wdxm657/ble_egg_anfu/蛋安抚器产品定义.md

## Wag2Me V1.3版本定义
- 1- 修订记录
    - 记录-1
        - 时间：2026-04-16
        - 修订人：刘岩
        - 修订内容：初始版本
- 2-开发内容
    - 2.1 设备
        - 蛋安抚器
    - 2.2 APP
        - 功能模块
            - Pet Hub、Hardware，增加对蛋安抚器的支持
    - 2.3-运营管理端
        - 增加对蛋安抚器的支持
    - 2.4-服务器端
        - 增加对蛋安抚器的支持
- 3-设备定义
    - 蛋安抚器
        - 主要电子器件
            - 主控
                - RV1103G1，17RMB
                - 部署声音识别算法
            - 麦克风咪头
                - B6050AL-C1033，1.5RMB
            - 超声波模组
                - 双头+板，13.2RMB
            - 扬声器喇叭
                - 首选
                    - 高保真，自带音腔，6.2RMB
                - 次选
                    - 旧样机在用，1.1RMBf
            - 蓝牙芯片
                - TLSR8258，2RMB
        - 安装要求
            - 摆放在狗狗碰不到的地方，距离地面高度0.7~1.5米，正面无遮挡
        - 功能定义
            - 自动识别吠叫
                - 7 x 24 小时自动识别狗吠，监测到狗狗持续吠叫则自动执行安抚
                - 每10~15秒为一个监测周期，根据期间识别到的狗吠次数判断是否要执行安抚
            - 自动执行安抚
                - 无安抚成功记录时，按照出厂顺序执行安抚，直到狗吠停止或全部措施执行完
                    - 1-播放安抚音乐2分钟
                    - 如果吠叫未停止
                    - 已录制主人声音
                    - 2-播放主人录音
                        - 录音播放次数=ceil(20 / 录音长度)
                    - 如果吠叫未停止
                    - 3-释放超声波5秒
                        - 25kHz@110dB
                    - 如果吠叫未停止
                    - 4-释放超声波5秒
                        - 30kHz@110dB
                    - 如果吠叫未停止
                    - 5-释放超声波5秒
                        - 25kHz&30kHz@110dB
                    - 设备进入60秒休息时间
                - 如果有成功安抚记录，优先执行最近成功的安抚措施
                    - 根据成功安抚记录，基于出厂顺序，调整下次执行顺序
                    - 举例
                        - 最近成功止吠措施
                            - 25kHz@110dB
                        - 下次执行顺序
                            - 1-25kHz@110dB
                            - 2-30kHz@110dB
                            - 3-25kHz&30kHz@110dB
                            - 4-播放安抚音乐
                            - 5-播放主人录音
            - 主人录音管理
                - 录音长度：3~10秒
                - 可在APP控制设备进行
                    - 录音试听
                    - 录音清除
                    - 声音录制
            - 安抚措施可配置
                - 安抚措施可多选，至少选1个
                    - 播放安抚音乐
                    - 播放主人声音
                    - 发射超声波
                        - 发射频率及强度可多选，至少选1个，最多选3个
                            - 25kHz@100dB
                            - 30kHz@80dB
                            - 25kHz&30kHz@100dB
            - 安抚记录查看
                - 可在APP上查看最近30天的安抚记录
            - 恢复出厂
                - 在app上解除配对时，设备恢复出厂状态
                    - 清除主人录音
                    - 安抚措施执行顺序恢复出厂状态
                    - 断开与当前用户的蓝牙连接
            - 上电后自动开机，可通过app操作关机
        - 数据处理
            - 与APP的数据接口
                - APP请求设备
                    - 配对请求
                    - 解除配对请求
                    - 获取设备状态
                        - 开关状态
                        - 是否存在主人录音
                    - 播放主人录音指令
                    - 删除主人录音指令
                    - 开始录制指令
                    - 结束录制指令
                        - 异常反馈：录音时长<3秒
                    - 音量，请求+指令
                    - 安抚模式，请求+指令
                    - 安抚措施，请求+指令
                - 设备主打上报
                    - 当前工作状态：监测/休息/识别/执行
                    - 安抚记录
                        - 吠叫识别时间
                        - 安抚措施执行时间（可能多个）
                        - 安抚结果及时间
        - 物理UI
            - 指示灯
                - 工作状态灯
                    - 熄灭：未供电
                    - 白色灯常亮：已供电、未开机
                    - 白色灯闪烁：开机启动中
                    - 蓝色灯常亮：实时监测状态
                    - 蓝色灯闪烁：安抚后的休息状态
                    - 绿色灯闪烁：检测到狗吠，判断是否要执行安抚
                    - 绿色灯常亮：安抚措施执行中
                - 蓝牙连接灯
                    - 熄灭：蓝牙未连接
                    - 蓝色灯常亮：蓝牙已连接
            - USB供电口
