wdxm657/ble_egg_anfu/docs/ctrl_service_doc.md

## 通用控制 Service 协议说明（给 APP 开发）

### 蓝牙名称 SincereEGGA

### 1. GATT 结构概览

- **Service：Custom Control Service**
- UUID（16 字节）：`00 A0 0D 0C 0B 0A 09 08 07 06 05 04 03 02 01 00`
- **Characteristic 1：Ctrl RX（APP -> 设备）**

- 

- UUID：`01 A0 0D 0C 0B 0A 09 08 07 06 05 04 03 02 01 00`
- 属性：Read | Write | Write Without Response
- 用途：APP 向设备发送所有控制命令

- **Characteristic 2：Ctrl TX（设备 -> APP）**

- 

- UUID：`02 A0 0D 0C 0B 0A 09 08 07 06 05 04 03 02 01 00`
- 属性：Read | Notify
- 需先向 CCC 写 `0x0001` 开启 Notify
- 用途：设备向 APP 返回响应/事件

- **Characteristic 3：Log TX（设备 -> APP）**

- 

- UUID：`03 A0 0D 0C 0B 0A 09 08 07 06 05 04 03 02 01 00`
- 属性：Read | Notify
- 需先向 CCC 写 `0x0001` 开启 Notify
- 用途：独立的调试日志输出通道，设备侧 `BLE_LOG_D` 宏的输出发往此特征。原始文本 UTF-8 编码，不分帧（每包最多 20 字节，长日志自动分包）
- APP 应将此通道的日志单独显示或与协议日志分开处理

当前固件按默认 MTU=23 设计，单帧总长度限制：`6 + payloadLen <= 20`。

**阅读约定**：下文「请求帧 / 响应帧」中，`byte0`～`byte5` 为固定 6 字节帧头；`byte6` 起为负载。`seq` 由 APP 自选 `0x00`～`0xFF`，响应中原样回显。多字节整数均为**小端（LE）**。

---

### 2. 通用帧头（每个接口共用，共 6 字节）

| | | |
| --- | --- | --- |
| 字节索引 | 固定/变量 | 含义 |
| byte0 | 固定 `0x01` | 协议版本 |
| byte1 | `0x01`/ `0x02`/ `0x03` | 消息类型：`0x01`=CMD（APP→设备），`0x02`=RSP（设备→APP），`0x03`=EVENT（设备→APP） |
| byte2 | 命令 ID | 与具体接口对应（见各节） |
| byte3 | `seq` | 序号；RSP/EVENT 与触发该结果的 CMD 使用同一 `seq`（事件除外见各节说明）。注意：设备会缓存最近 4 条 RSP 帧，若同一 seq 重复到达，自动重发上一次的响应结果 |
| byte4 | `payloadLen & 0xFF` | 负载长度低字节 |
| byte5 | `(payloadLen >> 8) & 0xFF` | 负载长度高字节；当前实现恒为 `0x00` |

`payloadLen` = 从 `byte6` 开始的字节数，且满足 `6 + payloadLen <= 20`。

---

### 3. 错误码（响应或事件中 payload 的首字节 `status`）

| | | |
| --- | --- | --- |
| 取值 | 名称 | 含义（APP 侧建议） |
| `0x00` | OK | 成功 |
| `0x01` | LEN_ERROR | 长度/格式不符 |
| `0x02` | UNSUPPORTED_CMD | 不支持的命令 |
| `0x03` | PARAM_ERROR | 参数非法 |
| `0x04` | INTERNAL_ERROR  | 内部或下游处理失败 |
| `0x05` | BUSY | 忙（如上一笔异步未完成） |
| `0x06` | SOC_TIMEOUT | 等 SOC 串口响应超时 |
| `0x07` | SOC_ERROR | SOC 返回错误（errDetail 为原始状态码） |

**短错误响应（常见 2 字节负载）**：`byte6=status`，`byte7=errDetail`（多数为 `0x00`；部分接口在失败时 `byte7` 为 SOC 原始错误码，见各接口说明）。

#### 3.1 SOC 原始故障码（当 `status = 0x07` 时，`errDetail` 取值）

当 BLE MCU 返回 `SOC_ERROR(0x07)` 时，`errDetail` 字节为 SOC 侧返回的原始状态码（`ds_uart_status_t`），取值如下：

| errDetail | 枚举名 | 含义 |
| --- | --- | --- |
| `0x00` | `DS_UART_STATUS_OK` | 成功 |
| `0x01` | `DS_UART_STATUS_PARAM_ERROR` | 参数错误 |
| `0x02` | `DS_UART_STATUS_BUSY` | 忙 |
| `0x03` | `DS_UART_STATUS_STATE_CONFLICT` | 状态冲突（当前不允许该操作） |
| `0x04` | `DS_UART_STATUS_TIMEOUT` | 超时 |
| `0x05` | `DS_UART_STATUS_NOT_FOUND` | 未找到（如无主人录音文件） |
| `0x06` | `DS_UART_STATUS_INTERNAL_ERROR` | SOC 内部错误 |

> **安抚会话中禁止的操作**：当设备处于安抚流程中（从首次狗叫识别到冷却开始），以下命令会被 SOC 拒绝并返回 `status=0x07(SOC_ERROR)` + `errDetail=0x03(状态冲突)`：
> - `OWNER_REC_START(0x20)` — 主人录音开始
> - `OWNER_REC_STOP(0x21)` — 主人录音结束
> - `OWNER_REC_PLAY(0x22)` — 主人录音播放
> - `OWNER_REC_PLAY_STOP(0x25)` — 主人录音停止播放
> - `OWNER_REC_DELETE(0x23)` — 主人录音删除
> - `OWNER_REC_SAVE(0x26)` — 主人录音保存
> - `CALM_MUSIC_PLAY(0x27)` — 安抚音频播放
> - `CALM_MUSIC_PLAY_STOP(0x28)` — 安抚音频停止播放
> - `CALM_MUSIC_SELECT(0x29)` 设置模式 — 设置安抚音频
> - `CALM_MODE_SET(0x30)` — 安抚模式设置
> - `CALM_STRATEGY_SET(0x37)` — 安抚策略设置
>
> APP 应在收到此错误后提示用户「安抚进行中，请稍后重试」。

---

### 4. 已实现命令（逐字节说明）

---

#### 4.1 电源开关（POWER_CTRL，CMD = `0x12`）

**请求帧（APP → 设备），总长 7 字节**

| | | |
| ----- | --- | --- |
| 字节  | 值/变量 | 注释 |
| byte0 | `0x01`  | 协议版本 |
| byte1 | `0x01`  | CMD |
| byte2 | `0x12`  | POWER_CTRL |
| byte3 | `seq` | 序号 |
| byte4 | `0x01`  | 负载长度 = 1 |
| byte5 | `0x00`  | 长度高字节 |
| byte6 | `onOff` | `0x00`=关机，`非0`视为开机（固件规范化为 `0x01`） |

**响应帧（设备 → APP），总长 8 字节**

| | | |
| ----- | --- | --- |
| 字节  | 值/变量  | 注释 |
| byte0 | `0x01` | 协议版本 |
| byte1 | `0x02` | RSP |
| byte2 | `0x12` | POWER_CTRL |
| byte3 | `seq` | 与请求一致 |
| byte4 | `0x02` | 负载长度 = 2 |
| byte5 | `0x00` | 长度高字节 |
| byte6 | `status` | 见 §3；成功为 `0x00` |
| byte7 | `onOff`  | 回显 MCU 应用后的开关：`0x00`关，`0x01`开 |

**参数错误时**：同上总长 8 字节，`byte6=0x03`（PARAM_ERROR），`byte7=0x00`。

---

#### 4.2 状态查询（STATUS_GET，CMD = `0x13`）

**请求帧（APP → 设备），总长 6 字节**

| | | |
| ----- | --- | --- |
| 字节  | 值/变量 | 注释 |
| byte0 | `0x01`  | 协议版本 |
| byte1 | `0x01`  | CMD |
| byte2 | `0x13`  | STATUS_GET |
| byte3 | `seq` | 序号 |
| byte4 | `0x00`  | 负载长度 = 0 |
| byte5 | `0x00`  | 长度高字节 |

**响应帧（设备 → APP），总长 16 字节**

| | | |
| --- | --- | --- |
| 字节 | 值/变量 | 注释 |
| byte0  | `0x01` | 协议版本 |
| byte1  | `0x02` | RSP |
| byte2  | `0x13` | STATUS_GET |
| byte3  | `seq` | 与请求一致 |
| byte4  | `0x07` | 负载长度 = 7 |
| byte5  | `0x00` | 长度高字节 |
| byte6  | `status` | 见 §3 |
| byte7  | `powerState` | 电源：`0x00`关机，`0x01`开机（**MCU 本地维护**，非 SOC 直传） |
| byte8  | `workState` | 工作状态：`0x00`OFF，`0x01`监测，`0x02`识别，`0x03`执行，`0x04`休息 |
| byte9  | `btLinked` | 兼容字段：当前连接下**固定为** `0x01` |
| byte10 | `volume` | 音量 `0`～`100` (百分比) |
| byte11 | `calmMode` | 安抚模式：`0x00`自动调整，`0x01`人工干预 |
| byte12 | `charging` | 充电状态（**MCU 本地 ADC 监测**）：`0x00`未充电，`0x01`充电中 |

---

#### 4.3 音量设置（VOLUME_SET，CMD = `0x14`）

**请求帧（APP → 设备），总长 7 字节**

| | | |
| ----- | --- | --- |
| 字节  | 值/变量  | 注释 |
| byte0 | `0x01` | 协议版本 |
| byte1 | `0x01` | CMD |
| byte2 | `0x14` | VOLUME_SET |
| byte3 | `seq` | 序号 |
| byte4 | `0x01` | 负载长度 = 1 |
| byte5 | `0x00` | 长度高字节 |
| byte6 | `volume` | 目标音量 `0`～`100` (百分比) |

**响应帧（设备 → APP），总长 8 字节**

| | | |
| ----- | --- | --- |
| 字节  | 值/变量 | 注释 |
| byte0 | `0x01` | 协议版本 |
| byte1 | `0x02` | RSP |
| byte2 | `0x14` | VOLUME_SET |
| byte3 | `seq` | 与请求一致 |
| byte4 | `0x02` | 负载长度 = 2 |
| byte5 | `0x00` | 长度高字节 |
| byte6 | `status` | 见 §3 |
| byte7 | `volumeApplied` | SOC 应用后的音量 `0`～`100` (百分比) |

**失败（SOC 回包异常）**：总长 8 字节，`byte6=0x07`（SOC_ERROR），`byte7=SOC故障码`（见 §3.1）。

---

#### 4.4 音量查询（VOLUME_GET，CMD = `0x15`）

**请求帧（APP → 设备），总长 6 字节**

| | | |
| ----- | --- | --- |
| 字节  | 值/变量 | 注释 |
| byte0 | `0x01`  | 协议版本 |
| byte1 | `0x01`  | CMD |
| byte2 | `0x15`  | VOLUME_GET |
| byte3 | `seq` | 序号 |
| byte4 | `0x00`  | 负载长度 = 0 |
| byte5 | `0x00`  | 长度高字节 |

**响应帧（设备 → APP），总长 8 字节**

| | | |
| ----- | --- | --- |
| 字节  | 值/变量  | 注释 |
| byte0 | `0x01` | 协议版本 |
| byte1 | `0x02` | RSP |
| byte2 | `0x15` | VOLUME_GET |
| byte3 | `seq` | 与请求一致 |
| byte4 | `0x02` | 负载长度 = 2 |
| byte5 | `0x00` | 长度高字节 |
| byte6 | `status` | 见 §3 |
| byte7 | `volume` | 当前音量 `0`～`100` (百分比) |

---

#### 4.5 主人录音开始（OWNER_REC_START，CMD = `0x20`）

**请求帧（APP → 设备），总长 6 字节**

| | | |
| ----- | --- | --- |
| 字节  | 值/变量 | 注释 |
| byte0 | `0x01`  | 协议版本 |
| byte1 | `0x01`  | CMD |
| byte2 | `0x20`  | OWNER_REC_START |
| byte3 | `seq` | 序号 |
| byte4 | `0x00`  | 负载长度 = 0 |
| byte5 | `0x00`  | 长度高字节 |

**响应帧成功（设备 → APP），总长 7 字节**

| | | |
| ----- | --- | --- |
| 字节  | 值/变量  | 注释 |
| byte0 | `0x01` | 协议版本 |
| byte1 | `0x02` | RSP |
| byte2 | `0x20` | OWNER_REC_START |
| byte3 | `seq` | 与请求一致 |
| byte4 | `0x01` | 负载长度 = 1 |
| byte5 | `0x00` | 长度高字节 |
| byte6 | `status` | `0x00`表示 SOC 已接受开始录制 |

**响应帧失败（SOC 非 OK）**，总长 8 字节：`byte6=0x07`（SOC_ERROR），`byte7=socStatus`（SOC 响应首字节原始值，见 §3.1）。

---

#### 4.6 主人录音结束（OWNER_REC_STOP，CMD = `0x21`）

**请求帧（APP → 设备），总长 6 字节**

| | | |
| ----- | --- | --- |
| 字节  | 值/变量 | 注释 |
| byte0 | `0x01`  | 协议版本 |
| byte1 | `0x01`  | CMD |
| byte2 | `0x21`  | OWNER_REC_STOP |
| byte3 | `seq` | 序号 |
| byte4 | `0x00`  | 负载长度 = 0 |
| byte5 | `0x00`  | 长度高字节 |

**响应帧成功（设备 → APP），总长 8 字节**

| | | |
| ----- | --- | --- |
| 字节  | 值/变量 | 注释 |
| byte0 | `0x01` | 协议版本 |
| byte1 | `0x02` | RSP |
| byte2 | `0x21` | OWNER_REC_STOP |
| byte3 | `seq` | 与请求一致 |
| byte4 | `0x02` | 负载长度 = 2 |
| byte5 | `0x00` | 长度高字节 |
| byte6 | `status` | `0x00` |
| byte7 | `durationSec` | 有效录音时长（秒） |

停止响应在 WAV 头更新并关闭文件后返回；时长按实际写入的 PCM 字节数计算，16 kHz、单声道、16 bit，每秒 32000 字节，向下取整。不再额外延迟录制；重复停止返回最近一次录音的相同结果，不随调用时间增长。手动停止只返回 RSP，不发送自动停止事件。

**响应帧（录音过短等，SOC** `status=0x01`**）**，总长 8 字节：同上 `byte4=0x02`，`byte6=0x03`（PARAM_ERROR），`byte7=durationSec`（SOC 带回的秒数，常为 0）。

**响应帧（其它失败）**，总长 8 字节：`byte6=0x04`（INTERNAL_ERROR），`byte7=0x00`。

---

#### 4.7 主人录音播放（OWNER_REC_PLAY，CMD = `0x22`）

**请求帧（APP → 设备），总长 7 字节**

| | | |
| ----- | --- | --- |
| 字节  | 值/变量  | 注释 |
| byte0 | `0x01` | 协议版本 |
| byte1 | `0x01` | CMD |
| byte2 | `0x22` | OWNER_REC_PLAY |
| byte3 | `seq` | 序号 |
| byte4 | `0x01` | 负载长度 = 1 |
| byte5 | `0x00` | 长度高字节 |
| byte6 | `source` | 播放源：`0x00`=已保存音频，`0x01`=tmp 目录未保存音频 |

**响应帧（设备 → APP），总长 7 字节**

| | | |
| ----- | --- | --- |
| 字节  | 值/变量  | 注释 |
| byte0 | `0x01` | 协议版本 |
| byte1 | `0x02` | RSP |
| byte2 | `0x22` | OWNER_REC_PLAY |
| byte3 | `seq` | 与请求一致 |
| byte4 | `0x01` | 负载长度 = 1 |
| byte5 | `0x00` | 长度高字节 |
| byte6 | `status` | `0x00`表示已接受并开始异步播放 |

**响应帧（无主人录音，SOC** `NOT_FOUND`**）**，总长 8 字节：`byte6=0x07`（SOC_ERROR），`byte7=SOC故障码`。

**响应帧（其它失败）**，总长 8 字节：`byte6=0x04`（INTERNAL_ERROR），`byte7=0x00`。

---

#### 4.8 主人录音停止播放（OWNER_REC_PLAY_STOP，CMD = `0x25`）

**请求帧（APP → 设备），总长 6 字节**

| | | |
| ----- | --- | --- |
| 字节  | 值/变量 | 注释 |
| byte0 | `0x01`  | 协议版本 |
| byte1 | `0x01`  | CMD |
| byte2 | `0x25`  | OWNER_REC_PLAY_STOP |
| byte3 | `seq` | 序号 |
| byte4 | `0x00`  | 负载长度 = 0 |
| byte5 | `0x00`  | 长度高字节 |

**响应帧（设备 → APP），总长 7 字节**

| | | |
| ----- | --- | --- |
| 字节  | 值/变量  | 注释 |
| byte0 | `0x01` | 协议版本 |
| byte1 | `0x02` | RSP |
| byte2 | `0x25` | OWNER_REC_PLAY_STOP |
| byte3 | `seq` | 与请求一致 |
| byte4 | `0x01` | 负载长度 = 1 |
| byte5 | `0x00` | 长度高字节 |
| byte6 | `status` | 见 §3 |

---

#### 4.9 主人录音保存（OWNER_REC_SAVE，CMD = `0x26`）

**用途**：将已录制到 tmp 目录的音频文件移动到播放目录。如果 tmp 中无文件，返回 `NOT_FOUND`。

**请求帧（APP → 设备），总长 6 字节**

| | | |
| ----- | --- | --- |
| 字节  | 值/变量 | 注释 |
| byte0 | `0x01`  | 协议版本 |
| byte1 | `0x01`  | CMD |
| byte2 | `0x26`  | OWNER_REC_SAVE |
| byte3 | `seq` | 序号 |
| byte4 | `0x00`  | 负载长度 = 0 |
| byte5 | `0x00`  | 长度高字节 |

**响应帧成功（设备 → APP），总长 8 字节**

| | | |
| ----- | --- | --- |
| 字节  | 值/变量 | 注释 |
| byte0 | `0x01` | 协议版本 |
| byte1 | `0x02` | RSP |
| byte2 | `0x26` | OWNER_REC_SAVE |
| byte3 | `seq` | 与请求一致 |
| byte4 | `0x02` | 负载长度 = 2 |
| byte5 | `0x00` | 长度高字节 |
| byte6 | `status` | `0x00` |
| byte7 | `durationSec` | 音频时长（秒），与 OWNER_REC_STOP 一致 |

时长从保存后的 WAV 文件读取，计算规则同停录接口。录制尚未结束时保存返回 SOC_ERROR，附带 SOC 状态 `0x02`（BUSY），应先停止再保存。

保存成功响应在 WAV 数据和重命名涉及的目录均完成 `fsync` 后返回，确保保存后立即断电时数据已提交到存储。同步失败返回 SOC_ERROR，附带 SOC 状态 `0x06`（INTERNAL_ERROR），不返回保存成功。

**响应帧（tmp 无文件）**，总长 7 字节：`byte6=0x07`（SOC_ERROR），`byte7=0x05`（NOT_FOUND）。

**响应帧（移动失败）**，总长 7 字节：`byte6=0x07`（SOC_ERROR），`byte7=0x06`（INTERNAL_ERROR）。

---

#### 4.10 主人录音删除（OWNER_REC_DELETE，CMD = `0x23`）

**请求帧（APP → 设备），总长 6 字节**

| | | |
| ----- | --- | --- |
| 字节  | 值/变量 | 注释 |
| byte0 | `0x01`  | 协议版本 |
| byte1 | `0x01`  | CMD |
| byte2 | `0x23`  | OWNER_REC_DELETE |
| byte3 | `seq` | 序号 |
| byte4 | `0x00`  | 负载长度 = 0 |
| byte5 | `0x00`  | 长度高字节 |

**响应帧成功（设备 → APP），总长 7 字节**

| | | |
| ----- | --- | --- |
| 字节  | 值/变量  | 注释 |
| byte0 | `0x01` | 协议版本 |
| byte1 | `0x02` | RSP |
| byte2 | `0x23` | OWNER_REC_DELETE |
| byte3 | `seq` | 与请求一致 |
| byte4 | `0x01` | 负载长度 = 1 |
| byte5 | `0x00` | 长度高字节 |
| byte6 | `status` | `0x00` |

删除接口会停止录制，删除临时和已保存的录音，并同步两个目录后才返回成功；成功后查询返回 `exist=0`、`durationSec=0`。文件原本不存在或重复删除时也返回成功。

**删除或同步失败**：总长 8 字节，`byte6=0x07`（SOC_ERROR），`byte7=0x06`（SOC INTERNAL_ERROR）。此时不能认为删除已持久化，可重试删除接口。

---

#### 4.11 主人录音信息（OWNER_REC_INFO_GET，CMD = `0x24`）

**请求帧（APP → 设备），总长 6 字节**

| | | |
| ----- | --- | --- |
| 字节  | 值/变量 | 注释 |
| byte0 | `0x01`  | 协议版本 |
| byte1 | `0x01`  | CMD |
| byte2 | `0x24`  | OWNER_REC_INFO_GET |
| byte3 | `seq` | 序号 |
| byte4 | `0x00`  | 负载长度 = 0 |
| byte5 | `0x00`  | 长度高字节 |

**响应帧（设备 → APP），总长 9 字节**

| | | |
| ----- | --- | --- |
| 字节  | 值/变量 | 注释 |
| byte0 | `0x01` | 协议版本 |
| byte1 | `0x02` | RSP |
| byte2 | `0x24` | OWNER_REC_INFO_GET |
| byte3 | `seq` | 与请求一致 |
| byte4 | `0x03` | 负载长度 = 3 |
| byte5 | `0x00` | 长度高字节 |
| byte6 | `status` | 见 §3 |
| byte7 | `exist` | `0x00`无文件，`0x01`有 |
| byte8 | `durationSec` | 时长（秒），与 SOC 规则一致（含上限） |

查询对象为已保存的录音文件；时长从该 WAV 文件实际 PCM 数据量计算，向下取整，重启前后规则一致。新录音尚未保存时，此接口仍返回旧的已保存录音信息；新录音保存后，其时长与本次停止、保存响应一致。无文件时返回 `exist=0`、`durationSec=0`。

---

#### 4.11 安抚记录读取（CALM_RECORD_GET，CMD = `0x33`）

用途：获取最旧的一条安抚会话记录。设备会将本条记录的所有 entry 逐条通过 NOTIFY 上报。每条 entry 携带 `session_id`，APP 可据此在读取完成后调用 `CALM_RECORD_DELETE(0x3A)` 删除对应记录。再继续获取下一条，直到无记录为止。

**请求帧（APP → 设备），总长 6 字节**

| | | |
| ----- | --- | --- |
| 字节  | 值/变量 | 注释 |
| byte0 | `0x01`  | 协议版本 |
| byte1 | `0x01`  | CMD |
| byte2 | `0x33`  | CALM_RECORD_GET |
| byte3 | `seq` | 序号 |
| byte4 | `0x00`  | 负载长度 = 0 |
| byte5 | `0x00`  | 长度高字节 |

**单条 entry 响应帧（设备 → APP），总长 15 字节**

| | | |
| --- | --- | --- |
| byte0 | `0x01` | 协议版本 |
| byte1 | `0x02` | RSP |
| byte2 | `0x33` | CALM_RECORD_GET |
| byte3 | `seq` | 与请求一致 |
| byte4 | `0x09` | 负载长度 = 9 |
| byte5 | `0x00` | 长度高字节 |
| byte6 | `status` | 本条为 `0x00` |
| byte7 | `entryIdx` | 本条 entry 在该记录中的索引，`0`起 |
| byte8 | `totalEntriesInRecord` | 本记录总共包含多少条 entry |
| byte9 | `session_id` | 本条记录所属的会话 ID（1 字节，用于删除） |
| byte10 | `type` | entry 类型（见下表） |
| byte11～byte14 | `ts` | Unix 时间戳（秒），uint32 LE |

**结果条目响应帧（最后一条，即 `entryIdx == totalEntriesInRecord - 1`），总长 16 字节**

最后一条 entry 恒为结果条目（`type=0x10` SUCCESS 或 `0x11` FAIL），其帧尾多 1 字节 `reward`，用于告知 APP 本次安抚成功是否附带零食投喂奖励。

| | | |
| --- | --- | --- |
| byte0～byte5 | 同单条帧  | 帧头 |
| byte6 | `status` | `0x00` |
| byte7 | `entryIdx` | 最后一条索引（`totalEntriesInRecord - 1`） |
| byte8 | `totalEntriesInRecord` | 同前 |
| byte9 | `session_id` | 同前 |
| byte10 | `type` | `0x10`=SUCCESS 或 `0x11`=FAIL |
| byte11～byte14 | `ts` | 结果时间戳（Unix 秒，uint32 LE） |
| byte15 | `reward` | 零食奖励标记：`0x00`无；`0x01`=本次成功附带零食投喂奖励 |

> **reward 说明**：非结果条目（`entryIdx < totalEntriesInRecord - 1`）帧长为 9 字节、无该字段；仅结果条目为 10 字节。APP 可按 `entryIdx == totalEntriesInRecord - 1` 判断帧长并读取 `reward`。旧固件（无 reward 字段）的结果条目仍为 9 字节，读取时按 0 处理即可，向后兼容。

**entry type 定义**

| | | |
| --- | --- | --- |
| type | 名称 | 含义 |
| `0x01` | BARK | 狗叫识别（每条记录的第一个 entry） |
| `0x02` | MUSIC | 安抚音乐 |
| `0x03` | OWNER | 主人音频 |
| `0x04` | US_25K  | 超声波 25KHz |
| `0x05` | US_30K  | 超声波 30KHz |
| `0x06` | US_DUAL | 超声波双频 |
| `0x07` | SNACK | 零食投喂 |
| `0x10` | SUCCESS | 安抚成功（每条记录的最后一个 entry） |
| `0x11` | FAIL | 安抚失败（每条记录的最后一个 entry） |

**无记录响应帧（设备 → APP），总长 7 字节**

| | | |
| ----- | --- | --- |
| 字节  | 值/变量  | 注释 |
| byte0 | `0x01` | 协议版本 |
| byte1 | `0x02` | RSP |
| byte2 | `0x33` | CALM_RECORD_GET |
| byte3 | `seq` | 与请求一致 |
| byte4 | `0x01` | 负载长度 = 1 |
| byte5 | `0x00` | 长度高字节 |
| byte6 | `status` | `0x00` |

**APP 建议流程**：

1. 发送 `CALM_RECORD_GET`（空 payload）
2. 接收多条 `entry` 响应帧，按 `entryIdx` / `totalEntriesInRecord` 拼成完整记录，记录 `session_id`
3. 当 `entryIdx == totalEntriesInRecord - 1` 时，本条记录接收完毕
4. 调用 `CALM_RECORD_DELETE` 并传入该记录的 `session_id` 以删除
5. 再次发送 `CALM_RECORD_GET` 获取下一条，重复步骤 2~4
6. 收到 `no records`（`payloadLen=1`），结束

**错误短包示例**：总长 7 字节，`byte6=status`，`byte7=0x00`。

---

#### 4.12 安抚记录删除（CALM_RECORD_DELETE，CMD = `0x3A`）

用途：APP 读取完一条记录的全部 entry 后，调用此接口传入 `session_id` 删除指定记录。

**请求帧（APP → 设备），总长 7 字节**

| | | |
| --- | --- | --- |
| 字节 | 值/变量 | 注释 |
| byte0 | `0x01` | 协议版本 |
| byte1 | `0x01` | CMD |
| byte2 | `0x3A` | CALM_RECORD_DELETE |
| byte3 | `seq` | 序号 |
| byte4 | `0x01` | 负载长度 = 1 |
| byte5 | `0x00` | 长度高字节 |
| byte6 | `session_id` | 要删除的记录的会话 ID（1 字节） |

**响应帧成功（设备 → APP），总长 7 字节**

| | | |
| ----- | --- | --- |
| 字节  | 值/变量  | 注释 |
| byte0 | `0x01` | 协议版本 |
| byte1 | `0x02` | RSP |
| byte2 | `0x3A` | CALM_RECORD_DELETE |
| byte3 | `seq` | 与请求一致 |
| byte4 | `0x01` | 负载长度 = 1 |
| byte5 | `0x00` | 长度高字节 |
| byte6 | `status` | `0x00`=成功 |

**响应帧失败**：总长 7 字节，`byte6=0x06`（SOC_TIMEOUT）或 `0x07`（SOC_ERROR）。

---

#### 4.13 安抚模式设置（CALM_MODE_SET，CMD = `0x30`）

**请求帧（APP → 设备），总长 7 字节**

| | | |
| ----- | --- | --- |
| 字节  | 值/变量 | 注释 |
| byte0 | `0x01`  | 协议版本 |
| byte1 | `0x01`  | CMD |
| byte2 | `0x30`  | CALM_MODE_SET |
| byte3 | `seq` | 序号 |
| byte4 | `0x01`  | 负载长度 = 1 |
| byte5 | `0x00`  | 长度高字节 |
| byte6 | `mode`  | `0x00`自动调整（允许动态调序），`0x01`人工干预（固定策略顺序） |

**响应帧成功（设备 → APP），总长 8 字节**

| | | |
| ----- | --- | --- |
| 字节  | 值/变量 | 注释 |
| byte0 | `0x01` | 协议版本 |
| byte1 | `0x02` | RSP |
| byte2 | `0x30` | CALM_MODE_SET |
| byte3 | `seq` | 与请求一致 |
| byte4 | `0x02` | 负载长度 = 2 |
| byte5 | `0x00` | 长度高字节 |
| byte6 | `status` | `0x00` |
| byte7 | `modeApplied` | 与请求一致或 SOC 确认后的值 |

---

#### 4.14 安抚模式查询（CALM_MODE_GET，CMD = `0x31`）

**请求帧（APP → 设备），总长 6 字节**

| | | |
| ----- | --- | --- |
| 字节  | 值/变量 | 注释 |
| byte0 | `0x01`  | 协议版本 |
| byte1 | `0x01`  | CMD |
| byte2 | `0x31`  | CALM_MODE_GET |
| byte3 | `seq` | 序号 |
| byte4 | `0x00`  | 负载长度 = 0  |
| byte5 | `0x00`  | 长度高字节 |

**响应帧（设备 → APP），总长 11 字节**

| | | |
| --- | --- | --- |
| 字节 | 值/变量 | 注释 |
| byte0  | `0x01` | 协议版本 |
| byte1  | `0x02` | RSP |
| byte2  | `0x31` | CALM_MODE_GET |
| byte3  | `seq` | 与请求一致 |
| byte4  | `0x05` | 负载长度 = 5 |
| byte5  | `0x00` | 长度高字节 |
| byte6  | `status` | 见 §3 |
| byte7  | `mode` | 当前安抚模式，同 §4.13 |
| byte8  | `usOrder0` | 超声策略顺序第 1 步：`1`=25k，`2`=30k，`3`=25k+30k |
| byte9  | `usOrder1` | 第 2 步；未使用可填 `0` |
| byte10 | `usOrder2` | 第 3 步；未使用可填 `0` |

（`usOrder`* 来自 MCU 缓存的超声顺序，与策略里超声段一致。）

---

#### 4.15 安抚策略设置（CALM_STRATEGY_SET，CMD = `0x37`）

说明：下文 `§4.13` 指安抚模式设置节。

负载为变长：`payloadLen = 3 + M + 1 + U`，其中 `M = measureOrderCount`（1～4），`U = usOrderCount`（1～3）。整帧须满足 `6 + payloadLen <= 20`。

**帧头（byte0～byte5）**

| | | |
| ----- | --- | --- |
| 字节  | 值/变量 | 注释 |
| byte0 | `0x01` | 协议版本 |
| byte1 | `0x01` | CMD |
| byte2 | `0x37` | CALM_STRATEGY_SET |
| byte3 | `seq` | 序号 |
| byte4 | `payloadLen & 0xFF` | 例如 `M=2,U=3`时 `payloadLen=9`，此处为 `0x09` |
| byte5 | `0x00` | 长度高字节 |

**负载首段（从 byte6 起）**

| | | |
| --- | --- | --- |
| 字节 | 值/变量 | 注释 |
| byte6 | `mode` | 与 §4.13 相同；仅允许 `0`或 `1` |
| byte7 | `enabledMask` | bit0=音乐，bit1=主人录音，bit2=超声，bit3=零食投喂；**不可为 0**；自动策略禁止 bit3 |
| byte8 | `measureOrderCount` | `M`，执行顺序项个数，1～4 |
| byte9 ～ `byte(8+M)` | `measureOrder[i]` | 每项：`1`=音乐，`2`=主人录音，`3`=超声，`4`=零食投喂；自动策略禁止 `4` |

**负载末段（超声顺序）**

| | | |
| --- | --- | --- |
| 字节 | 值/变量 | 注释 |
| `byte(9+M)`  | `usOrderCount` | `U`，1～3 |
| 随后 `U`字节 | `usOrder[j]` | 每项：`1`=25kHz，`2`=30kHz，`3`=25kHz+30kHz |

**响应帧成功（设备 → APP），总长 7 字节**

| | | |
| ----- | --- | --- |
| 字节  | 值/变量  | 注释 |
| byte0 | `0x01` | 协议版本 |
| byte1 | `0x02` | RSP |
| byte2 | `0x37` | CALM_STRATEGY_SET |
| byte3 | `seq` | 与请求一致 |
| byte4 | `0x01` | 负载长度 = 1 |
| byte5 | `0x00` | 长度高字节 |
| byte6 | `status` | `0x00` |

**响应帧失败（SOC 非 OK）**，总长 8 字节：`byte6=0x04`（INTERNAL_ERROR），`byte7=socErr`（SOC 原始错误码，见 §3.1）。

---

#### 4.16 安抚策略查询（CALM_STRATEGY_GET，CMD = `0x38`）

**请求帧（APP → 设备），总长 7 字节**

| | | |
| ----- | --- | --- |
| 字节  | 值/变量 | 注释 |
| byte0 | `0x01`  | 协议版本 |
| byte1 | `0x01`  | CMD |
| byte2 | `0x38`  | CALM_STRATEGY_GET |
| byte3 | `seq` | 序号 |
| byte4 | `0x01`  | 负载长度 = 1 |
| byte5 | `0x00`  | 长度高字节 |
| byte6 | `mode`  | `0x00`=查询自动策略，`0x01`=查询手动策略 |

**注意**：SOC 端维护两个独立的策略文件（`calm_strategy_auto.bin` / `calm_strategy_manual.bin`），查询时需指定要获取哪个。设置策略（`CALM_STRATEGY_SET`）时自动根据 payload 中的 `mode` 字段保存到对应文件；模式切换（`CALM_MODE_SET`）时也会将当前策略持久化到对应文件。

**响应帧（设备 → APP），变长**  
令 `M = measureOrderCount`，`U = usOrderCount`，则 `payloadLen = 4 + M + U`（最大 `4+4+3=11`），总长 `6 + payloadLen`，不超过 20。

| | | |
| --- | --- | --- |
| 字节 | 值/变量 | 注释 |
| byte0 | `0x01` | 协议版本 |
| byte1 | `0x02` | RSP |
| byte2 | `0x38` | CALM_STRATEGY_GET |
| byte3 | `seq` | 与请求一致 |
| byte4 | `payloadLen & 0xFF` | 见上式 |
| byte5 | `0x00` | 长度高字节 |
| byte6 | `status` | 见 §3 |
| byte7 | `mode` | 同请求中的 mode |
| byte8 | `enabledMask` | 同 §4.15 |
| byte9 | `measureOrderCount` | `M` |
| byte10 ～ `byte(9+M)` | `measureOrder[i]` | 同 §4.15 |
| `byte(10+M)` | `usOrderCount` | `U` |
| 随后 `U`字节 | `usOrder[j]` | 同 §4.15 |

---

#### 4.17 设置时间（TIME_SET，CMD = `0x32`）

**请求帧（APP → 设备），总长 11 字节**

| | | |
| --- | --- | --- |
| 字节 | 值/变量 | 注释 |
| byte0  | `0x01` | 协议版本 |
| byte1  | `0x01` | CMD |
| byte2  | `0x32` | TIME_SET |
| byte3  | `seq` | 序号 |
| byte4  | `0x05` | 负载长度 = 5 |
| byte5  | `0x00` | 长度高字节 |
| byte6  | `epochSec_b0` | Unix 时间戳（秒），uint32 LE 字节 0 |
| byte7  | `epochSec_b1` | 字节 1 |
| byte8  | `epochSec_b2` | 字节 2 |
| byte9  | `epochSec_b3` | 字节 3 |
| byte10 | `tzQ15` | 有符号时区参数（固件侧与 SOC 约定，通常为 15 分钟粒度偏移）；具体换算见 `BLE_UART接口设计_V1.md` |

**响应帧（设备 → APP），总长 7 字节**

| | | |
| ----- | --- | --- |
| 字节  | 值/变量  | 注释 |
| byte0 | `0x01` | 协议版本 |
| byte1 | `0x02` | RSP |
| byte2 | `0x32` | TIME_SET |
| byte3 | `seq` | 与请求一致 |
| byte4 | `0x01` | 负载长度 = 1 |
| byte5 | `0x00` | 长度高字节 |
| byte6 | `status` | `0x00`表示 MCU 已缓存并下发 SOC（SOC 设时结果以联调为准） |

---

#### 4.18 UID 查询（UID_GET，CMD = `0x34`）

Flash UID 共 16 字节，分 **2 帧 RSP** 回传，每帧 8 字节负载。

**请求帧（APP → 设备），总长 6 字节**

| | | |
| ----- | --- | --- |
| 字节  | 值/变量 | 注释 |
| byte0 | `0x01`  | 协议版本 |
| byte1 | `0x01`  | CMD |
| byte2 | `0x34`  | UID_GET |
| byte3 | `seq` | 序号 |
| byte4 | `0x00`  | 负载长度 = 0 |
| byte5 | `0x00`  | 长度高字节 |

**响应帧第 1 包（设备 → APP），总长 16 字节**

| | | |
| --- | --- | --- |
| 字节 | 值/变量 | 注释 |
| byte0 | `0x01` | 协议版本 |
| byte1 | `0x02` | RSP |
| byte2 | `0x34` | UID_GET |
| byte3 | `seq` | 与请求一致 |
| byte4 | `0x0A` | 负载长度 = 10 |
| byte5 | `0x00` | 长度高字节 |
| byte6 | `status` | 见 §3 |
| byte7 | `part` | 固定 `0x00`，表示 UID 第 1 段 |
| byte8～byte15 | `uid[0..7]` | UID 字节 0～7 |

**响应帧第 2 包（设备 → APP），总长 16 字节**

| | | |
| --- | --- | --- |
| 字节 | 值/变量 | 注释 |
| byte0 | `0x01` | 协议版本 |
| byte1 | `0x02` | RSP |
| byte2 | `0x34` | UID_GET |
| byte3 | `seq` | 与第 1 包相同 |
| byte4 | `0x0A` | 负载长度 = 10 |
| byte5 | `0x00` | 长度高字节 |
| byte6 | `status` | 见 §3 |
| byte7 | `part` | 固定 `0x01`，表示 UID 第 2 段 |
| byte8～byte15 | `uid[8..15]` | UID 字节 8～15 |

---

#### 4.19 解绑复位（FACTORY_RESET，CMD = `0x56`）

**请求帧（APP → 设备），总长 7 字节**

| | | |
| ----- | --- | --- |
| 字节  | 值/变量  | 注释 |
| byte0 | `0x01` | 协议版本 |
| byte1 | `0x01` | CMD |
| byte2 | `0x50` | FACTORY_RESET |
| byte3 | `seq` | 序号 |
| byte4 | `0x01` | 负载长度 = 1 |
| byte5 | `0x00` | 长度高字节 |
| byte6 | `reason` | 原因码；当前建议 `0x01`（如解绑触发），其它值保留 |

**响应帧（设备 → APP），总长 7 字节**

| | | |
| ----- | --- | --- |
| 字节  | 值/变量  | 注释 |
| byte0 | `0x01` | 协议版本 |
| byte1 | `0x02` | RSP |
| byte2 | `0x50` | FACTORY_RESET |
| byte3 | `seq` | 与请求一致 |
| byte4 | `0x01` | 负载长度 = 1 |
| byte5 | `0x00` | 长度高字节 |
| byte6 | `status` | `0x00`表示已执行清录音、清策略与清记录等出厂数据流程 |

**响应帧失败**：总长 8 字节，`byte6=0x04`（INTERNAL_ERROR），`byte7=socStatus`（SOC 原始错误码，见 §3.1）。

---

#### 4.20 零食奖励开关设置（REWARD_FLAG_SET，CMD = `0x35`）

**用途**：设置「安抚成功是否附带零食投喂奖励」功能开关。该开关由 MCU 保存在本地 Flash，每次启动时自动恢复；MCU 同步给 SOC 用于安抚成功时的奖励判定。

**请求帧（APP → 设备），总长 7 字节**

| | | |
| ----- | --- | --- |
| 字节  | 值/变量  | 注释 |
| byte0 | `0x01` | 协议版本 |
| byte1 | `0x01` | CMD |
| byte2 | `0x35` | REWARD_FLAG_SET |
| byte3 | `seq` | 序号 |
| byte4 | `0x01` | 负载长度 = 1 |
| byte5 | `0x00` | 长度高字节 |
| byte6 | `enabled`| `0x00`=关闭，`非0`视为开启（固件规范化为 `0x01`） |

**响应帧（设备 → APP），总长 8 字节**

| | | |
| ----- | --- | --- |
| 字节  | 值/变量  | 注释 |
| byte0 | `0x01` | 协议版本 |
| byte1 | `0x02` | RSP |
| byte2 | `0x35` | REWARD_FLAG_SET |
| byte3 | `seq` | 与请求一致 |
| byte4 | `0x02` | 负载长度 = 2 |
| byte5 | `0x00` | 长度高字节 |
| byte6 | `status` | `0x00`成功；`0x03`参数错误 |
| byte7 | `enabledApplied` | 设备实际应用的开关值 `0x00`/`0x01` |

**参数错误时**：`byte6=0x03`（PARAM_ERROR），`byte7=0x00`。

---

#### 4.21 零食奖励开关查询（REWARD_FLAG_GET，CMD = `0x36`）

**用途**：查询当前零食奖励功能开关状态（进入设置页时恢复 UI 勾选态）。

**请求帧（APP → 设备），总长 6 字节**

| | | |
| ----- | --- | --- |
| 字节  | 值/变量 | 注释 |
| byte0 | `0x01`  | 协议版本 |
| byte1 | `0x01`  | CMD |
| byte2 | `0x36`  | REWARD_FLAG_GET |
| byte3 | `seq` | 序号 |
| byte4 | `0x00`  | 负载长度 = 0 |
| byte5 | `0x00`  | 长度高字节 |

**响应帧（设备 → APP），总长 8 字节**

| | | |
| ----- | --- | --- |
| 字节  | 值/变量  | 注释 |
| byte0 | `0x01` | 协议版本 |
| byte1 | `0x02` | RSP |
| byte2 | `0x36` | REWARD_FLAG_GET |
| byte3 | `seq` | 与请求一致 |
| byte4 | `0x02` | 负载长度 = 2 |
| byte5 | `0x00` | 长度高字节 |
| byte6 | `status` | `0x00`成功；`0x03`参数错误 |
| byte7 | `enabled` | 当前开关值：`0x00`关闭，`0x01`开启 |

---

#### 4.22 安抚音频选择与播放测试（CALM_MUSIC_SELECT，CMD = `0x29`）

**用途**：选择 SOC 端的安抚音频文件。设置成功后，选择会保存到 SOC 本地 `params/calm_music_index.bin`；SOC 启动时加载该值，手动测试播放（`CALM_MUSIC_PLAY`，`0x27`）和自动安抚中的音乐措施都会使用该文件。首次运行或选择文件无效时默认使用音频 1。

**音频编号**：

| `audioIndex` | 文件名 |
| --- | --- |
| `0x00` | `calm1.wav`  |
| `0x01` | `calm2.wav`  |

**请求帧（APP → 设备）**

| 模式 | 总长 | byte4 (`payloadLen`) | byte6 起的负载 |
| ---- | ---- | --- | --- |
| 查询 | 6 字节 | `0x00` | 无 |
| 设置 | 7 字节 | `0x01` | `audioIndex`：`0x00`=calm1.wav，`0x01`=calm2.wav |

两种请求的 `byte0`～`byte3` 与 `byte5` 字段遵循通用帧头定义；查询请求不带负载，设置请求携带 1 字节索引。

**响应帧（设备 → APP），总长 8 字节**

| 字节  | 值/变量 | 注释 |
| ----- | --- | ---- |
| byte0 | `0x01` | 协议版本 |
| byte1 | `0x02` | RSP |
| byte2 | `0x29` | CALM_MUSIC_SELECT |
| byte3 | `seq` | 与请求一致 |
| byte4 | `0x02` | 负载长度 = 2 |
| byte5 | `0x00` | 长度高字节 |
| byte6 | `status` | `0x00`成功；`0x03`参数错误；`0x07`SOC 错误 |
| byte7 | `audioIndex` / `errDetail` | `status=0x00` 时为当前音频索引；`status=0x07` 时为 SOC 原始状态码 |

查询模式返回持久化后加载的当前选择；设置模式在本地保存成功后更新当前选择并返回。成功响应为 `[status=0x00, audioIndex]`；SOC 拒绝或执行失败时返回 `[status=0x07, errDetail]`，`errDetail` 为 SOC 原始状态码（安抚会话状态冲突为 `0x03`）。参数错误为 `[status=0x03, 0x00]`；`status=0x06` 表示 MCU 等待 SOC 超时。设置操作在安抚会话进行中会被 SOC 拒绝，查询不受此限制。

**播放/停止测试**：

1. 可先发送空负载 `CALM_MUSIC_SELECT(0x29)` 查询当前选择。
2. 发送带 1 字节编号 `0x00` 或 `0x01` 的 `CALM_MUSIC_SELECT(0x29)` 设置音频，等待成功响应。
3. 发送 `CALM_MUSIC_PLAY(0x27)`，空负载，开始播放当前选择的文件。
4. 发送 `CALM_MUSIC_PLAY_STOP(0x28)`，空负载，停止播放。

`0x27` 与 `0x28` 的请求均为总长 6 字节（空负载）；成功响应均为总长 7 字节，`byte6=0x00`。SOC 拒绝或执行失败时返回总长 8 字节，`byte6=0x07`、`byte7=errDetail`；安抚会话状态冲突的 `errDetail=0x03`。其他 SOC 错误时 `errDetail` 为 SOC 原始状态码。

---

### 5. 事件（设备 → APP，逐字节）

#### 5.1 主人录音自动停止事件（EVENT cmd = `0x21`）

SOC 端录音数据量达到配置上限（当前 `DS_OWNER_REC_MAX_SEC=11` 秒）自动停止时，设备以 EVENT 形式上报，复用 `OWNER_REC_STOP` 的 cmdId。手动停止不发送此事件。

**事件帧，总长 9 字节**

| | | |
| ----- | --- | --- |
| 字节  | 值/变量 | 注释 |
| byte0 | `0x01` | 协议版本 |
| byte1 | `0x03` | EVENT |
| byte2 | `0x21` | CTRL_CMD_OWNER_REC_STOP |
| byte3 | `seq` | 事件序号（由设备分配，可与 CMD 无关） |
| byte4 | `0x03` | 负载长度 = 3 |
| byte5 | `0x00` | 长度高字节 |
| byte6 | `bleStatus` | 停录结果，同 §3 语义 |
| byte7 | `durationSec` | 停录时实际时长（整数秒，当前上限 11） |
| byte8 | `autoStop` | `0x01`=SOC 自动停止 |

#### 5.2 工作状态变化事件（WORK_STATE_CHANGED，EVENT cmd = `0x80`）

SOC 工作状态发生变化时主动推送。payload 直接透传 SOC 原始数据。

**事件帧，总长 8 字节**

| | | |
| ----- | --- | --- |
| 字节  | 值/变量 | 注释 |
| byte0 | `0x01` | 协议版本 |
| byte1 | `0x03` | EVENT |
| byte2 | `0x80` | CTRL_CMD_WORK_STATE_CHANGED |
| byte3 | `seq` | 事件序号 |
| byte4 | `0x02` | 负载长度 = 2 |
| byte5 | `0x00` | 长度高字节 |
| byte6 | `workState` | 工作状态：`0x00`OFF，`0x01`监测，`0x02`识别，`0x03`执行，`0x04`休息 |
| byte7 | `reason` | 触发原因（见下表） |

**reason 取值**

| reason | 含义 |
| :----: | --- |
| `0x00` | 开机 |
| `0x01` | 监测到狗叫，进入识别 |
| `0x02` | 触发安抚，开始执行措施 |
| `0x03` | 安抚成功，进入休息 |
| `0x04` | 安抚失败，进入休息 |
| `0x05` | 休息结束，回到监测 |
| `0x06` | 措施完成，进入复听 |
| `0x07` | 识别超时，回到监测 |
| `0x08` | 复听期间检测到狗叫，再次识别 |

#### 5.4 安抚会话开始事件（SOC_SESSION_START，EVENT cmd = `0x81`）

SOC 端吠叫检测满 3 次触发安抚执行时主动推送。

**事件帧，总长 14 字节**

| | | |
| --- | --- | --- |
| 字节 | 值/变量 | 注释 |
| byte0 | `0x01` | 协议版本 |
| byte1 | `0x03` | EVENT |
| byte2 | `0x81` | CTRL_CMD_SOC_SESSION_START |
| byte3 | `seq` | 事件序号 |
| byte4 | `0x08` | 负载长度 = 8 |
| byte5 | `0x00` | 长度高字节 |
| byte6～9 | `session_id` | 会话 ID，uint32 LE |
| byte10～13 | `bark_ts` | 首次狗叫 Unix 时间戳（秒），uint32 LE |

#### 5.5 措施执行事件（SOC_MEASURE_EXEC，EVENT cmd = `0x82`）

SOC 每项安抚措施开始执行时主动推送。

**事件帧，总长 17 字节**

| | | |
| --- | --- | --- |
| 字节 | 值/变量 | 注释 |
| byte0 | `0x01` | 协议版本 |
| byte1 | `0x03` | EVENT |
| byte2 | `0x82` | CTRL_CMD_SOC_MEASURE_EXEC |
| byte3 | `seq` | 事件序号 |
| byte4 | `0x0B` | 负载长度 = 11 |
| byte5 | `0x00` | 长度高字节 |
| byte6～9 | `session_id` | 会话 ID，uint32 LE |
| byte10 | `step` | 本项措施在列表中的序号（0 起） |
| byte11 | `measure` | 措施类型：`1`=音乐，`2`=主人录音，`3`=超声 |
| byte12 | `sub` | 超声子项，仅 `measure=3` 时有效：`1`=25KHz，`2`=30KHz，`3`=双频 |
| byte13～16 | `ts` | 执行时间 Unix 时间戳（秒），uint32 LE |

#### 5.6 会话结果事件（SOC_SESSION_RESULT，EVENT cmd = `0x83`）

安抚会话结束（成功/失败）时主动推送。

**事件帧，总长 18 字节**

| | | |
| --- | --- | --- |
| 字节 | 值/变量 | 注释 |
| byte0 | `0x01` | 协议版本 |
| byte1 | `0x03` | EVENT |
| byte2 | `0x83` | CTRL_CMD_SOC_SESSION_RESULT |
| byte3 | `seq` | 事件序号 |
| byte4 | `0x0C` | 负载长度 = 12 |
| byte5 | `0x00` | 长度高字节 |
| byte6～9 | `session_id` | 会话 ID，uint32 LE |
| byte10 | `result` | `0x00`=失败，`0x01`=成功 |
| byte11～14 | `end_ts` | 结束时间 Unix 时间戳（秒），uint32 LE |
| byte15 | `ok_measure` | 最后生效的措施类型（同 `measure`） |
| byte16 | `ok_sub` | 最后生效的超声子项（同 `sub`） |
| byte17 | `reward` | 零食奖励标记：`0x00`无，`0x01`=本次成功附带零食投喂奖励 |

> **reward 说明**：仅当 `result=0x01`（成功）且设备开启了「零食奖励」功能、且最后生效措施不是零食投喂时，设备会额外投喂一次零食并将 `reward=1`。该投喂**不属于安抚流程措施**（不产生 `0x82` 措施执行事件、不新增记录条目），APP 可用此字段展示「本次安抚附带零食奖励」。

#### 5.7 SOC 错误事件（SOC_ERROR，EVENT cmd = `0x86`）

SOC 端发生内部错误时主动推送。

**事件帧，总长 7 字节**

| | | |
| ----- | --- | --- |
| 字节  | 值/变量  | 注释 |
| byte0 | `0x01` | 协议版本 |
| byte1 | `0x03` | EVENT |
| byte2 | `0x86` | CTRL_CMD_SOC_ERROR |
| byte3 | `seq` | 事件序号 |
| byte4 | `0x01` | 负载长度 = 1 |
| byte5 | `0x00` | 长度高字节 |
| byte6 | `errCode` | SOC 错误码（见 SOC 侧定义） |

#### 5.8 安抚记录可用通知（CALM_RECORD_NOTIFY，EVENT cmd = `0x84`）

SOC 端每秒检查一次安抚记录文件，当检测到有已存储的完整记录且 BLE 已连接时，以 EVENT 形式通知上位机（只要记录存在且 BLE 连接就会每秒持续通知）。

**触发时机**：
- SOC 每秒轮询，检测到有安抚记录 + BLE 已连接，每秒发送通知
- APP 读取并删除记录后通知停止（无新记录时不再发送）

**事件帧，总长 7 字节**

| | | |
| ----- | --- | --- |
| 字节  | 值/变量 | 注释 |
| byte0 | `0x01` | 协议版本 |
| byte1 | `0x03` | EVENT |
| byte2 | `0x84` | CTRL_CMD_CALM_RECORD_NOTIFY |
| byte3 | `seq` | 事件序号 |
| byte4 | `0x01` | 负载长度 = 1 |
| byte5 | `0x00` | 长度高字节 |
| byte6 | `recordCount`| 当前存储的安抚记录数（固定为 `0x01`） |

**APP 建议处理方式**：
- 收到此 EVENT 后，表示设备端有安抚记录可用
- 用户如需读取具体记录，点击「查询安抚记录」按钮调用 `CALM_RECORD_GET(0x33)` 获取
- 记录的完整管理与删除仍通过 `CALM_RECORD_GET(0x33)` / `CALM_RECORD_DELETE(0x3A)` 由 APP 控制

---

#### 5.9 安抚音频播放完成事件（CALM_MUSIC_DONE，EVENT cmd = `0x87`）

SOC 安抚音频文件（`calm1.wav` 或 `calm2.wav`）自然播放到文件末尾时发送。用户主动停止播放、切换音频或播放失败不发送此事件。MCU 收到后在 BLE 已连接时转发给 APP；BLE 未连接时丢弃。

**事件帧，总长 7 字节**

| 字节 | 值/变量 | 注释 |
| ---- | --- | ---- |
| byte0 | `0x01` | 协议版本 |
| byte1 | `0x03` | EVENT |
| byte2 | `0x87` | CALM_MUSIC_DONE |
| byte3 | `seq` | MCU 生成的事件序号 |
| byte4 | `0x01` | 负载长度 = 1 |
| byte5 | `0x00` | 长度高字节 |
| byte6 | `audioIndex` | `0x00`=`calm1.wav`，`0x01`=`calm2.wav` |

APP 可据此将对应音频的播放状态更新为已完成。事件仅用于播放完成通知，不替代 `CALM_MUSIC_PLAY(0x27)` 的启动响应。

---

#### 5.3 状态变更事件（STATUS_CHANGED，EVENT cmd = `0x13`）

当设备运行时状态（电源/工作/录音/音量/模式/使能位等）发生任何变化时，设备主动推送完整状态快照。  
payload 格式与 STATUS_GET（§4.2）的响应一致，EVENT 类型标识 `msg_type=0x03`。

**事件帧，总长 16 字节**

| | | |
| --- | --- | --- |
| 字节 | 值/变量 | 注释 |
| byte0  | `0x01` | 协议版本 |
| byte1  | `0x03` | EVENT |
| byte2  | `0x13` | CTRL_CMD_STATUS_GET（复用命令 ID，由 msg_type 区分） |
| byte3  | `seq` | 事件序号 |
| byte4  | `0x07` | 负载长度 = 7 |
| byte5  | `0x00` | 长度高字节 |
| byte6  | `status` | `0x00` |
| byte7  | `powerState` | 电源：`0x00`关机，`0x01`开机 |
| byte8  | `workState` | 工作状态：`0x00`OFF，`0x01`监测，`0x02`识别，`0x03`执行，`0x04`休息 |
| byte9  | `btLinked` | 蓝牙连接状态：当前会话固定 `0x01` |
| byte10 | `volume` | 音量 `0`～`100` (百分比) |
| byte11 | `calmMode` | 安抚模式：`0x00`自动调整，`0x01`人工干预 |
| byte12 | `charging` | 充电状态（**MCU 本地 ADC 监测**）：`0x00`未充电，`0x01`充电中 |

**触发时机**：电源/工作/录音/音量/模式/使能位等任何状态变化，以及 **MCU 充电状态变化（插拔 USB、充满/开始充电）** 均会触发推送。

APP 应在收到此事件后刷新本地缓存的状态展示，无需再次调用 STATUS_GET。

---

### 6. APP 处理建议

1. 连接后先开启 `Ctrl TX` Notify。
2. 请求维护 `seq`，响应按 `cmdId + seq` 匹配。
3. `CALM_RECORD_GET(0x33)` 按逐条 entry 的 `entryIdx / totalEntriesInRecord` 拼成完整记录，并记录 `session_id`；拿到记录的最后一条 entry 后调用 `CALM_RECORD_DELETE(0x3A)` 传入该 `session_id` 删除，循环直至无记录。
4. 若收到 `CALM_RECORD_NOTIFY(0x84)` EVENT，表示设备端当前存在安抚记录，可点击「查询安抚记录」按钮读取，或忽略在适当时机再查。该通知每秒重复发送，直到记录被读取删除。
5. 若 `status != 0x00`，结合 §3 与对应接口的 `errDetail`（若有）提示用户或重试。
