wdxm657/ble_egg_anfu/docs/UART_超声波模组.md

# UART 超声波模组通信协议

## 1. 概述

本文档定义主机（MCU）与超声波模组之间的 UART 通信协议。主机通过串口向模组下发配置和发射指令，模组执行后返回应答帧。

- **物理层**：UART，3.3V TTL 电平
- **波特率**：115200 bps
- **数据位**：8
- **停止位**：1
- **校验位**：无
- **通信方式**：半双工，主机主动发送请求，模组回复应答

---

## 2. 通用约定

### 2.1 帧格式

所有指令和应答均采用定长或变长帧，结构如下：

| 偏移  | 长度(字节) | 字段 | 说明 |
| ----- | --- | --- | --- |
| 0 | 1 | `HEAD`  | 帧头，固定 `0xAA` |
| 1 | 1 | `CMD` | 命令字，见 §3 |
| 2 | 1 | `LEN` | 数据区长度（0 ~ 32），不含 HEAD/CMD/LEN/CHECK |
| 3 | LEN | `DATA`  | 数据区，内容依赖 CMD |
| 3+LEN | 1 | `CHECK` | 校验和 = `HEAD` + `CMD` + `LEN` + `DATA` 各字节累加和，取低 8 位 |

### 2.2 应答帧格式

模组对每个有效指令回复一个应答帧：

| 偏移 | 长度(字节) | 字段 | 说明 |
| ---- | --- | --- | --- |
| 0 | 1 | `HEAD` | 帧头，固定 `0xAA` |
| 1 | 1 | `CMD` | 命令字，与请求帧相同 |
| 2 | 1 | `LEN` | `0x01` |
| 3 | 1 | `STATUS` | 执行状态 |
| 4 | 1 | `CHECK`  | 校验和 |

`STATUS` 取值：

| 取值 | 含义 | 说明 |
| --- | --- | --- |
| `0x00` | 成功 | 指令已正确执行 |
| `0x01` | 失败 | 指令执行失败，参数或硬件异常 |
| `0x02` | 无效命令 | `CMD` 值未定义或当前状态下不支持 |

### 2.3 超时与重试

- 主机发送请求后，应在 **100 ms** 内收到应答，否则视为超时。

---

## 3. 指令定义

### 3.1 配置超声波发射频率为 25KHz

**用途**：将模组超声波发射频率设置为 25KHz 单频模式。

**调用方 / 前置条件**：模组空闲或已停止发射。

**请求**：

| 字段  | 值 | 说明 |
| ----- | --- | --- |
| HEAD  | `0xAA` | |
| CMD | `0x01` | |
| LEN | `0x00` | 无数据区 |
| CHECK | `0xAB` | `0xAA+0x01+0x00 = 0xAB` |

**应答**：通用应答帧（见 §2.2），`CMD=0x01`。

**示例**：

```
请求： AA 01 00 AB
应答： AA 01 01 00 AC
```

---

### 3.2 配置超声波发射频率为 30KHz

**用途**：将模组超声波发射频率设置为 30KHz 单频模式。

**调用方 / 前置条件**：模组空闲或已停止发射。

**请求**：

| 字段  | 值 | 说明 |
| ----- | --- | --- |
| HEAD  | `0xAA` | |
| CMD | `0x02` | |
| LEN | `0x00` | 无数据区 |
| CHECK | `0xAC` | `0xAA+0x02+0x00 = 0xAC` |

**应答**：通用应答帧（见 §2.2），`CMD=0x02`。

**示例**：

```
请求： AA 02 00 AC
应答： AA 02 01 00 AD
```

---

### 3.3 配置超声波发射频率为 25KHz + 30KHz

**用途**：将模组超声波发射频率设置为 25KHz 和 30KHz 混合模式（双频交替或同时输出，视模组硬件能力而定）。

**调用方 / 前置条件**：模组空闲或已停止发射。

**请求**：

| 字段  | 值 | 说明 |
| ----- | --- | --- |
| HEAD  | `0xAA` | |
| CMD | `0x03` | |
| LEN | `0x00` | 无数据区 |
| CHECK | `0xAD` | `0xAA+0x03+0x00 = 0xAD` |

**应答**：通用应答帧（见 §2.2），`CMD=0x03`。

**示例**：

```
请求： AA 03 00 AD
应答： AA 03 01 00 AE
```

---

### 3.4 开启 / 关闭超声波变压器

**用途**：控制超声波变压器高压输出的通断。发射超声波前需先开启变压器。

**调用方 / 前置条件**：无。

**请求**：

| 字段 | 值 | 说明 |
| --- | --- | --- |
| HEAD | `0xAA` | |
| CMD | `0x04` | |
| LEN | `0x01` | 数据区长度为 1 |
| DATA[0] | `0x00` ~ `0x01` | `0x00` = 关闭变压器，`0x01` = 开启变压器 |
| CHECK | 计算结果 | 整帧校验和 |

**应答**：通用应答帧（见 §2.2），`CMD=0x04`。

**示例**：

```
开启变压器：
请求： AA 04 01 01 B0
应答： AA 04 01 00 AF

关闭变压器：
请求： AA 04 01 00 AF
应答： AA 04 01 00 AF
```

---

### 3.5 发射超声波

**用途**：控制超声波发射的开启与关闭。模组按当前配置的频率（由 §3.1 / §3.2 / §3.3 设置）持续发射，直到主机下发关闭指令。发射时长完全由主机控制。

**调用方 / 前置条件**：开启发射前需先通过 §3.4 开启变压器。

**请求**：

| 字段 | 值 | 说明 |
| --- | --- | --- |
| HEAD | `0xAA` | |
| CMD | `0x05` | |
| LEN | `0x01` | 数据区长度为 1 |
| DATA[0] | `0x00` ~ `0x01` | `0x00` = 停止发射，`0x01` = 开始发射 |
| CHECK | 计算结果 | 整帧校验和 |

**应答**：通用应答帧（见 §2.2），`CMD=0x05`。

**示例**：

```
开始发射：
请求： AA 05 01 01 B1
应答： AA 05 01 00 B0

停止发射：
请求： AA 05 01 00 B0
应答： AA 05 01 00 B0
```

## 3.6 RGB 三色灯控制

**CMD：`0x06`**

**用途**：通过串口控制 RGB 三色灯。支持：

- 关闭所有颜色；
- 任意颜色组合常亮；
- 任意颜色组合按指定频率闪烁。

**调用方 / 前置条件**：无。模组需具备 RGB 三色灯硬件。

### 请求

| 字段 | 值 | 说明 |
| --- | --- | --- |
| HEAD | `0xAA` | 帧头 |
| CMD | `0x06` | RGB 控制命令  |
| LEN | `0x03` | 数据区长度 3  |
| DATA[0] | `MODE` | 工作模式 |
| DATA[1] | `COLOR`  | 颜色掩码 |
| DATA[2] | `FREQ` | 闪烁频率 Hz |
| CHECK | 计算结果 | 整帧校验和 |

### DATA 定义

**DATA[0]：MODE 工作模式**

| 取值 | 含义 | 说明 |
| --- | ---- | --- |
| `0x00` | 关闭 | 关闭 RGB 所有颜色 |
| `0x01` | 常亮 | 按 `COLOR` 掩码常亮 |
| `0x02` | 闪烁 | 按 `COLOR` 掩码和 `FREQ` 闪烁  |
| 其他 | 无效 | 返回 `STATUS=0x01` |

**DATA[1]：COLOR 颜色掩码，RGB 三色灯**

| bit | 颜色 | 说明 |
| --- | ---- | --- |
| bit0 | R | `1`=参与，`0`=关闭 |
| bit1 | G | `1`=参与，`0`=关闭 |
| bit2 | B | `1`=参与，`0`=关闭 |
| bit3~7 | 保留 | 必须为 `0` |

常用颜色组合：

| COLOR  | 颜色 |
| --- | --- |
| `0x01` | 红 |
| `0x02` | 绿 |
| `0x04` | 蓝 |
| `0x03` | 红 + 绿，黄 |
| `0x05` | 红 + 蓝，品红 |
| `0x06` | 绿 + 蓝，青 |
| `0x07` | 红 + 绿 + 蓝，白 |

说明：

- `MODE=0x00` 时忽略 `COLOR`、`FREQ`，建议填 `0x00`。
- `MODE=0x01` 或 `0x02` 时，`COLOR` 不得为 `0x00`，且 bit3~7 必须为 0，否则返回 `STATUS=0x01`。
- 该指令为整灯状态设置：未在 `COLOR` 中置位的颜色通道关闭。

**DATA[2]：FREQ 闪烁频率**

| 取值 | 含义 |
| --- | --- |
| `0x01~0x32` | 闪烁频率 1~50 Hz |
| `0x00` | 仅 `MODE=0x00/0x01` 时建议填 0 |
| 其他 | `MODE=0x02` 时视为无效，返回 `STATUS=0x01` |

说明：

- 仅 `MODE=0x02` 时有效。
- 默认占空比 50%。
- 实际频率精度受模组定时器能力影响。

### 应答

通用应答帧，`CMD=0x06`：

| STATUS | 含义 |
| --- | --- |
| `0x00` | 成功 |
| `0x01` | 参数错误或执行失败 |
| `0x02` | 无效命令或当前状态不支持 |

### 示例

```text
RGB 全灭：
请求： AA 06 03 00 00 00 B3
应答： AA 06 01 00 B1

RGB 红色常亮：
请求： AA 06 03 01 01 00 B5
应答： AA 06 01 00 B1

RGB 绿色闪烁 2Hz：
请求： AA 06 03 02 02 02 B9
应答： AA 06 01 00 B1

RGB 红 + 蓝常亮，即品红：
请求： AA 06 03 01 05 00 B9
应答： AA 06 01 00 B1

RGB 白色闪烁 10Hz：
请求： AA 06 03 02 07 0A C6
应答： AA 06 01 00 B1
```

## 3.7 RG 双色灯控制

**CMD：`0x07`**

**用途**：通过串口控制 RG 双色灯。支持：

- 关闭所有颜色；
- 任意颜色组合常亮；
- 任意颜色组合按指定频率闪烁。

**调用方 / 前置条件**：无。模组需具备 RG 双色灯硬件。

### 请求

| 字段 | 值 | 说明 |
| --- | --- | --- |
| HEAD | `0xAA` | 帧头 |
| CMD | `0x07` | RG 控制命令 |
| LEN | `0x03` | 数据区长度 3  |
| DATA[0] | `MODE` | 工作模式 |
| DATA[1] | `COLOR`  | 颜色掩码 |
| DATA[2] | `FREQ` | 闪烁频率 Hz |
| CHECK | 计算结果 | 整帧校验和 |

### DATA 定义

**DATA[0]：MODE 工作模式**

| 取值 | 含义 | 说明 |
| --- | ---- | --- |
| `0x00` | 关闭 | 关闭 RG 所有颜色 |
| `0x01` | 常亮 | 按 `COLOR` 掩码常亮 |
| `0x02` | 闪烁 | 按 `COLOR` 掩码和 `FREQ` 闪烁  |
| 其他 | 无效 | 返回 `STATUS=0x01` |

**DATA[1]：COLOR 颜色掩码，RG 双色灯**

| bit | 颜色 | 说明 |
| --- | ---- | --- |
| bit0 | R | `1`=参与，`0`=关闭 |
| bit1 | G | `1`=参与，`0`=关闭 |
| bit2~7 | 保留 | 必须为 `0` |

常用颜色组合：

| COLOR  | 颜色 |
| --- | --- |
| `0x01` | 红 |
| `0x02` | 绿 |
| `0x03` | 红 + 绿 |

说明：

- `MODE=0x00` 时忽略 `COLOR`、`FREQ`，建议填 `0x00`。
- `MODE=0x01` 或 `0x02` 时，`COLOR` 不得为 `0x00`，且 bit2~7 必须为 0，否则返回 `STATUS=0x01`。
- 该指令为整灯状态设置：未在 `COLOR` 中置位的颜色通道关闭。

**DATA[2]：FREQ 闪烁频率**

| 取值 | 含义 |
| --- | --- |
| `0x01~0x32` | 闪烁频率 1~50 Hz |
| `0x00` | 仅 `MODE=0x00/0x01` 时建议填 0 |
| 其他 | `MODE=0x02` 时视为无效，返回 `STATUS=0x01` |

说明：

- 仅 `MODE=0x02` 时有效。
- 默认占空比 50%。
- 实际频率精度受模组定时器能力影响。

### 应答

通用应答帧，`CMD=0x07`：

| STATUS | 含义 |
| --- | --- |
| `0x00` | 成功 |
| `0x01` | 参数错误或执行失败 |
| `0x02` | 无效命令或当前状态不支持 |

### 示例

```text
RG 全灭：
请求： AA 07 03 00 00 00 B4
应答： AA 07 01 00 B2

RG 红色常亮：
请求： AA 07 03 01 01 00 B6
应答： AA 07 01 00 B2

RG 绿色闪烁 5Hz：
请求： AA 07 03 02 02 05 BD
应答： AA 07 01 00 B2

RG 红 + 绿常亮：
请求： AA 07 03 01 03 00 B8
应答： AA 07 01 00 B2

RG 红 + 绿闪烁 1Hz：
请求： AA 07 03 02 03 01 BA
应答： AA 07 01 00 B2
```

---

## 4. 典型使用流程

```mermaid
sequenceDiagram
    participant Host as 主机 (MCU)
    participant Module as 超声波模组

    Host->>Module: AA 01 00 AB  (配置25KHz)
    Module-->>Host: AA 01 01 00 AC (成功)

    Host->>Module: AA 04 01 01 B0 (开启变压器)
    Module-->>Host: AA 04 01 00 AF (成功)

    Host->>Module: AA 05 01 01 B1 (开始发射)
    Module-->>Host: AA 05 01 00 B0 (成功)
    Note over Host,Module: 主机控制发射时长

    Host->>Module: AA 05 01 00 B0 (停止发射)
    Module-->>Host: AA 05 01 00 B0 (成功)

    Host->>Module: AA 04 01 00 AF (关闭变压器)
    Module-->>Host: AA 04 01 00 AF (成功)
```

---

## 5. 完整指令速查表

| 功能 | CMD | LEN | DATA | 说明 |
| --- | --- | --- | --- | --- |
| 配置 25KHz | `0x01` | `0x00` | 无 | 发射频率设为 25KHz |
| 配置 30KHz | `0x02` | `0x00` | 无 | 发射频率设为 30KHz |
| 配置 25K+30K | `0x03` | `0x00` | 无 | 发射频率设为 25KHz+30KHz |
| 控制变压器 | `0x04` | `0x01` | `0x00`=关, `0x01`=开 | 开启/关闭变压器 |
| 发射超声波 | `0x05` | `0x01` | `0x00`=停止, `0x01`=发射 | 开始/停止超声波发射 |
| RGB 三色灯控制 | `0x06` | `0x03` | `MODE, COLOR, FREQ` | 关闭 / 常亮 / 指定频率闪烁 |
| RG 双色灯控制  | `0x07` | `0x03` | `MODE, COLOR, FREQ` | 关闭 / 常亮 / 指定频率闪烁 |

---

## 6. 错误处理

| 异常场景 | 行为 | 应答 STATUS |
| --- | --- | --- |
| 帧头错误 (`HEAD != 0xAA`) | 模组丢弃该帧，无应答 | — |
| 校验和不匹配 | 模组丢弃该帧，无应答 | — |
| CMD 未定义 | 回复错误应答 | `0x02` (无效命令) |
| 数据区长度与 CMD 不匹配 | 回复错误应答 | `0x01` (失败) |
| 发射指令(DATA=开)但变压器未开启 | 回复错误应答 | `0x01` (失败) |

---

## 7. 附录

### 7.1 校验和计算参考 (C语言)

```c
uint8_t calc_checksum(const uint8_t *buf, uint8_t len)
{
    uint8_t sum = 0;
    for (uint8_t i = 0; i < len; i++) {
        sum += buf[i];
    }
    return sum;
}
```

### 7.2 组包参考 (C语言)

```c
void build_request(uint8_t cmd, const uint8_t *data, uint8_t data_len, uint8_t *frame)
{
    frame[0] = 0xAA;        // HEAD
    frame[1] = cmd;         // CMD
    frame[2] = data_len;    // LEN
    for (uint8_t i = 0; i < data_len; i++) {
        frame[3 + i] = data[i];
    }
    frame[3 + data_len] = calc_checksum(frame, 3 + data_len);
}
```
