wdxm657/ble_egg_anfu/(list of files, cad)

Other CAD files:
hardware/止吠蛋主板_20260602.dwg
