wdxm657/ble_egg_anfu/hardware/egg/egg.pdf

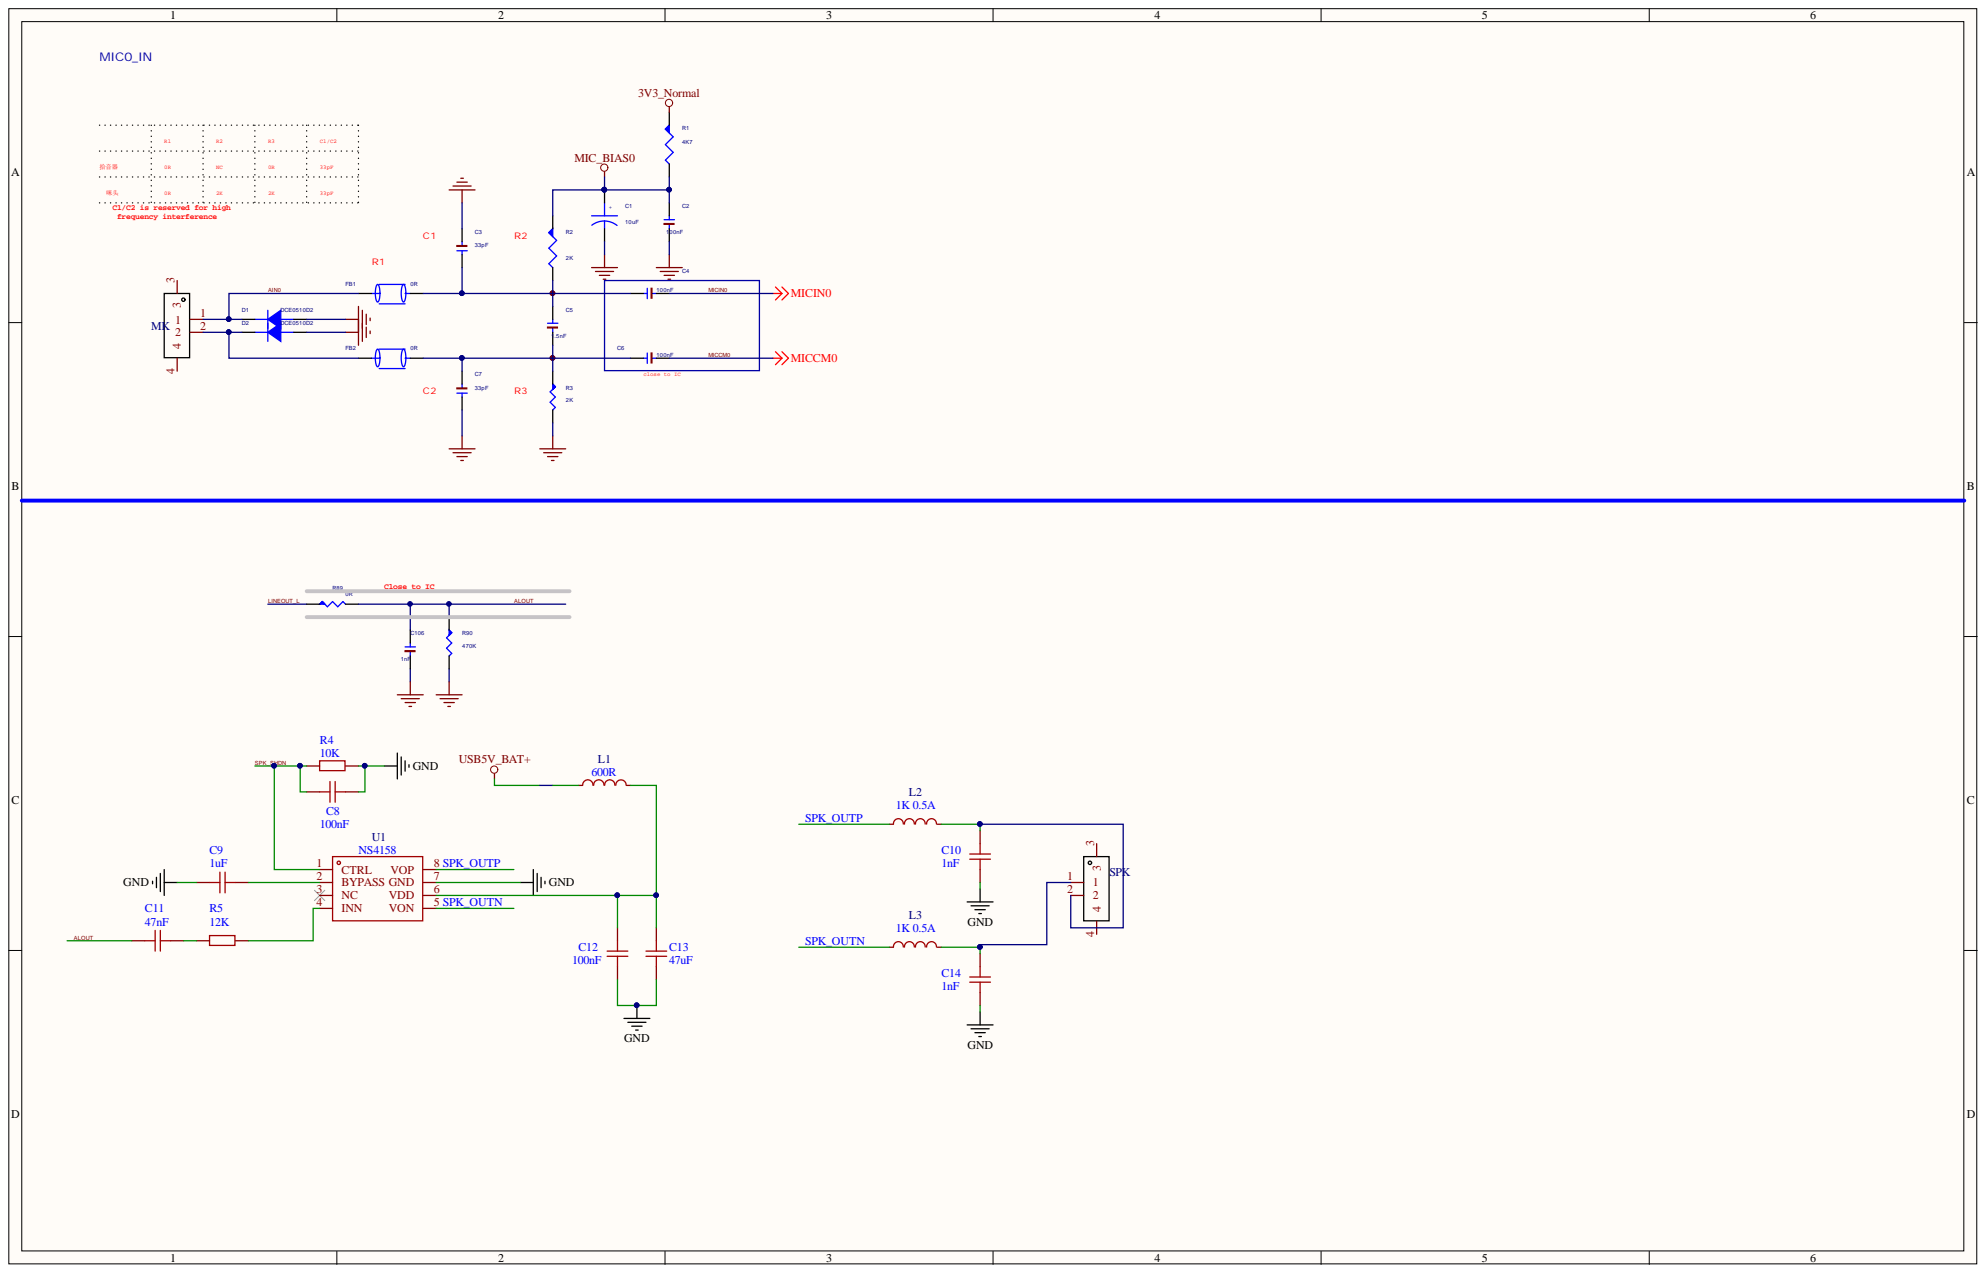
[picture p1: page 1]

C1/C2 is reserved for high
frequency interference

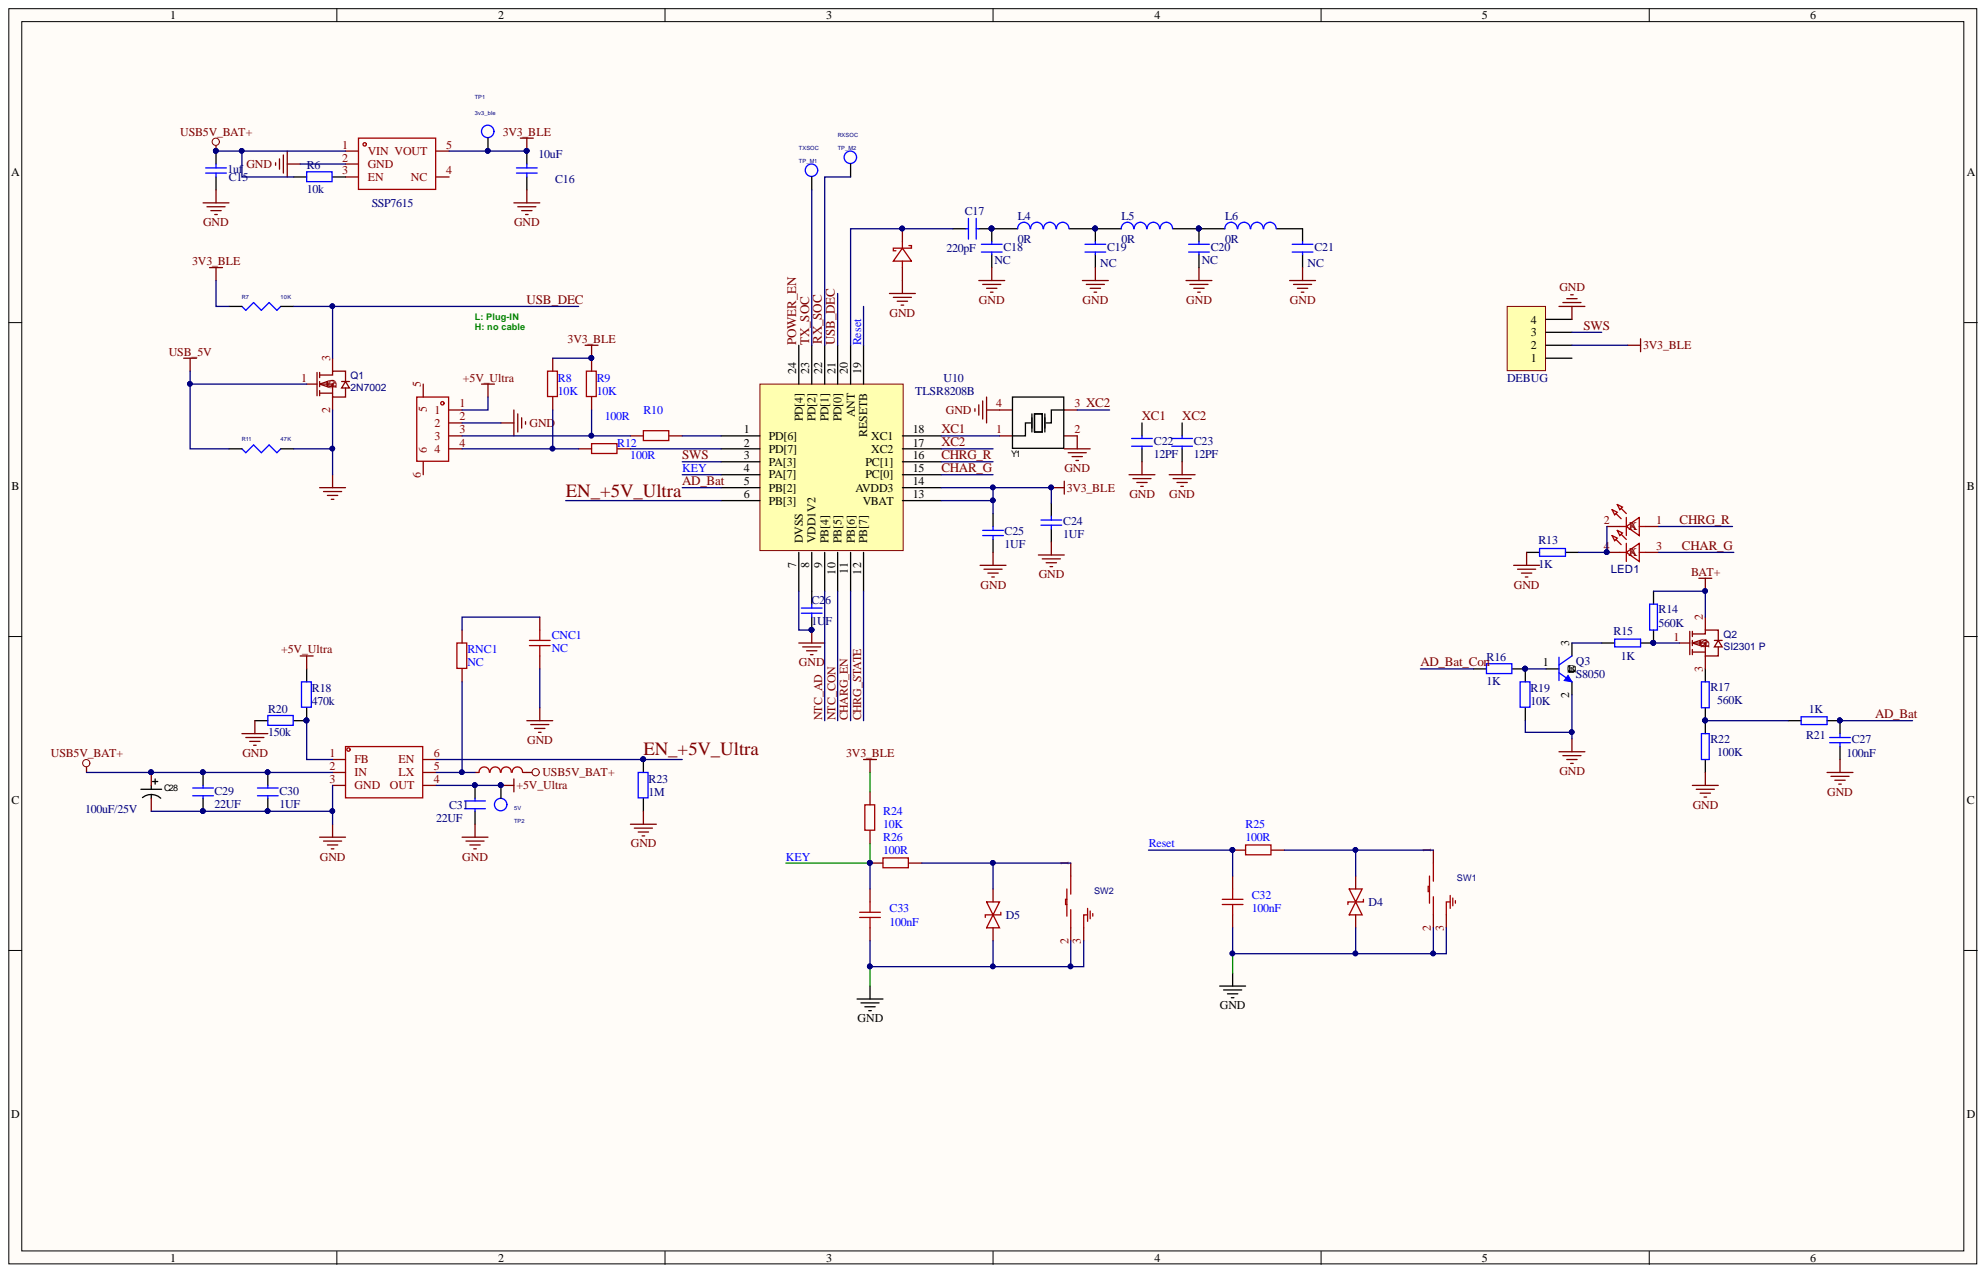
[picture p2: page 2]

18 ESETB 19 ANT 20 PD[0] 21 PD[1] 22 PD[2] 23 PD[4] 24

PB[7] 12 VBAT 13 AVDD3 14 PC[0] 15 PC[1] 16 XC2 17 XC1 R

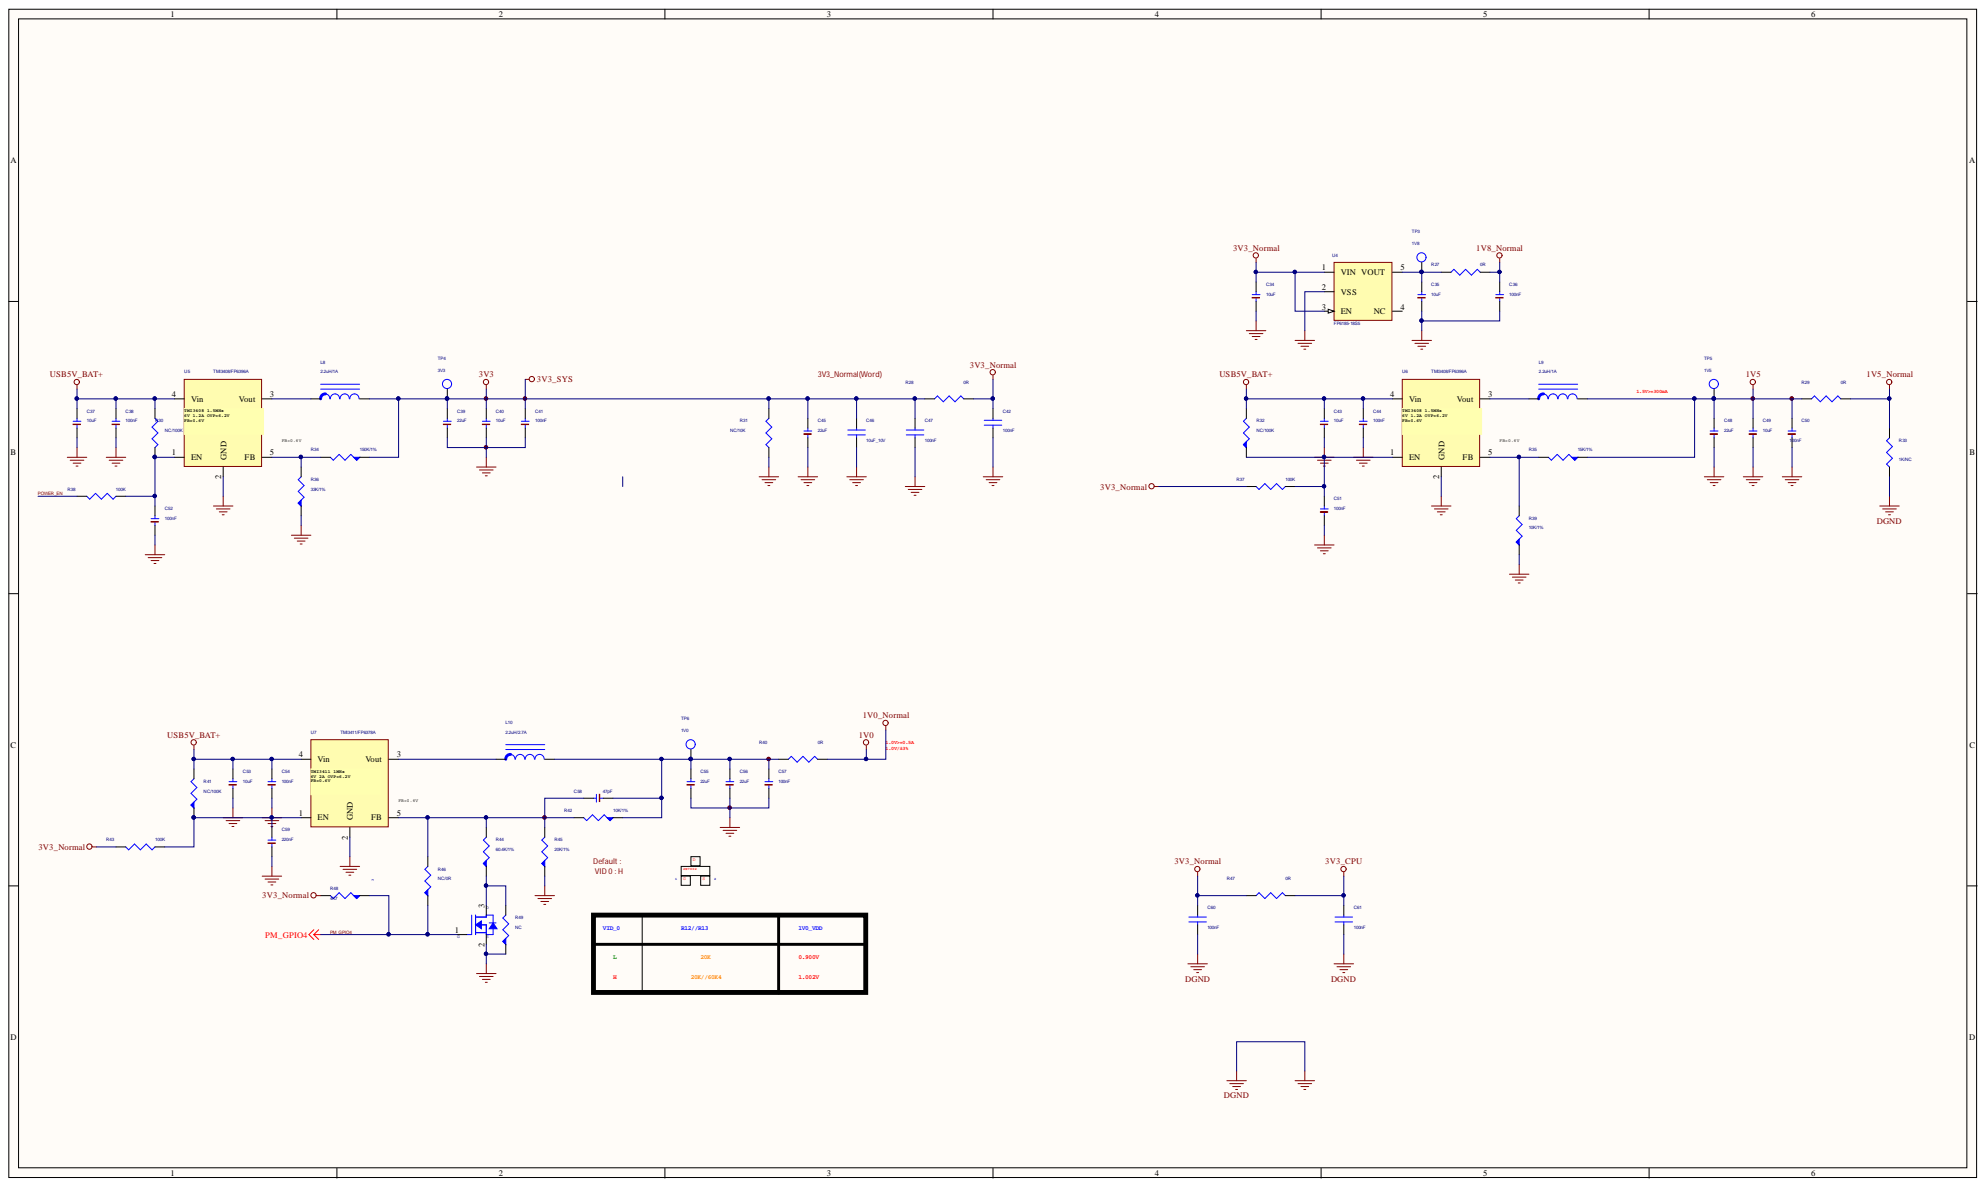
[picture p3: page 3]

VID_0 | R12//R13 | 1V0_VDD

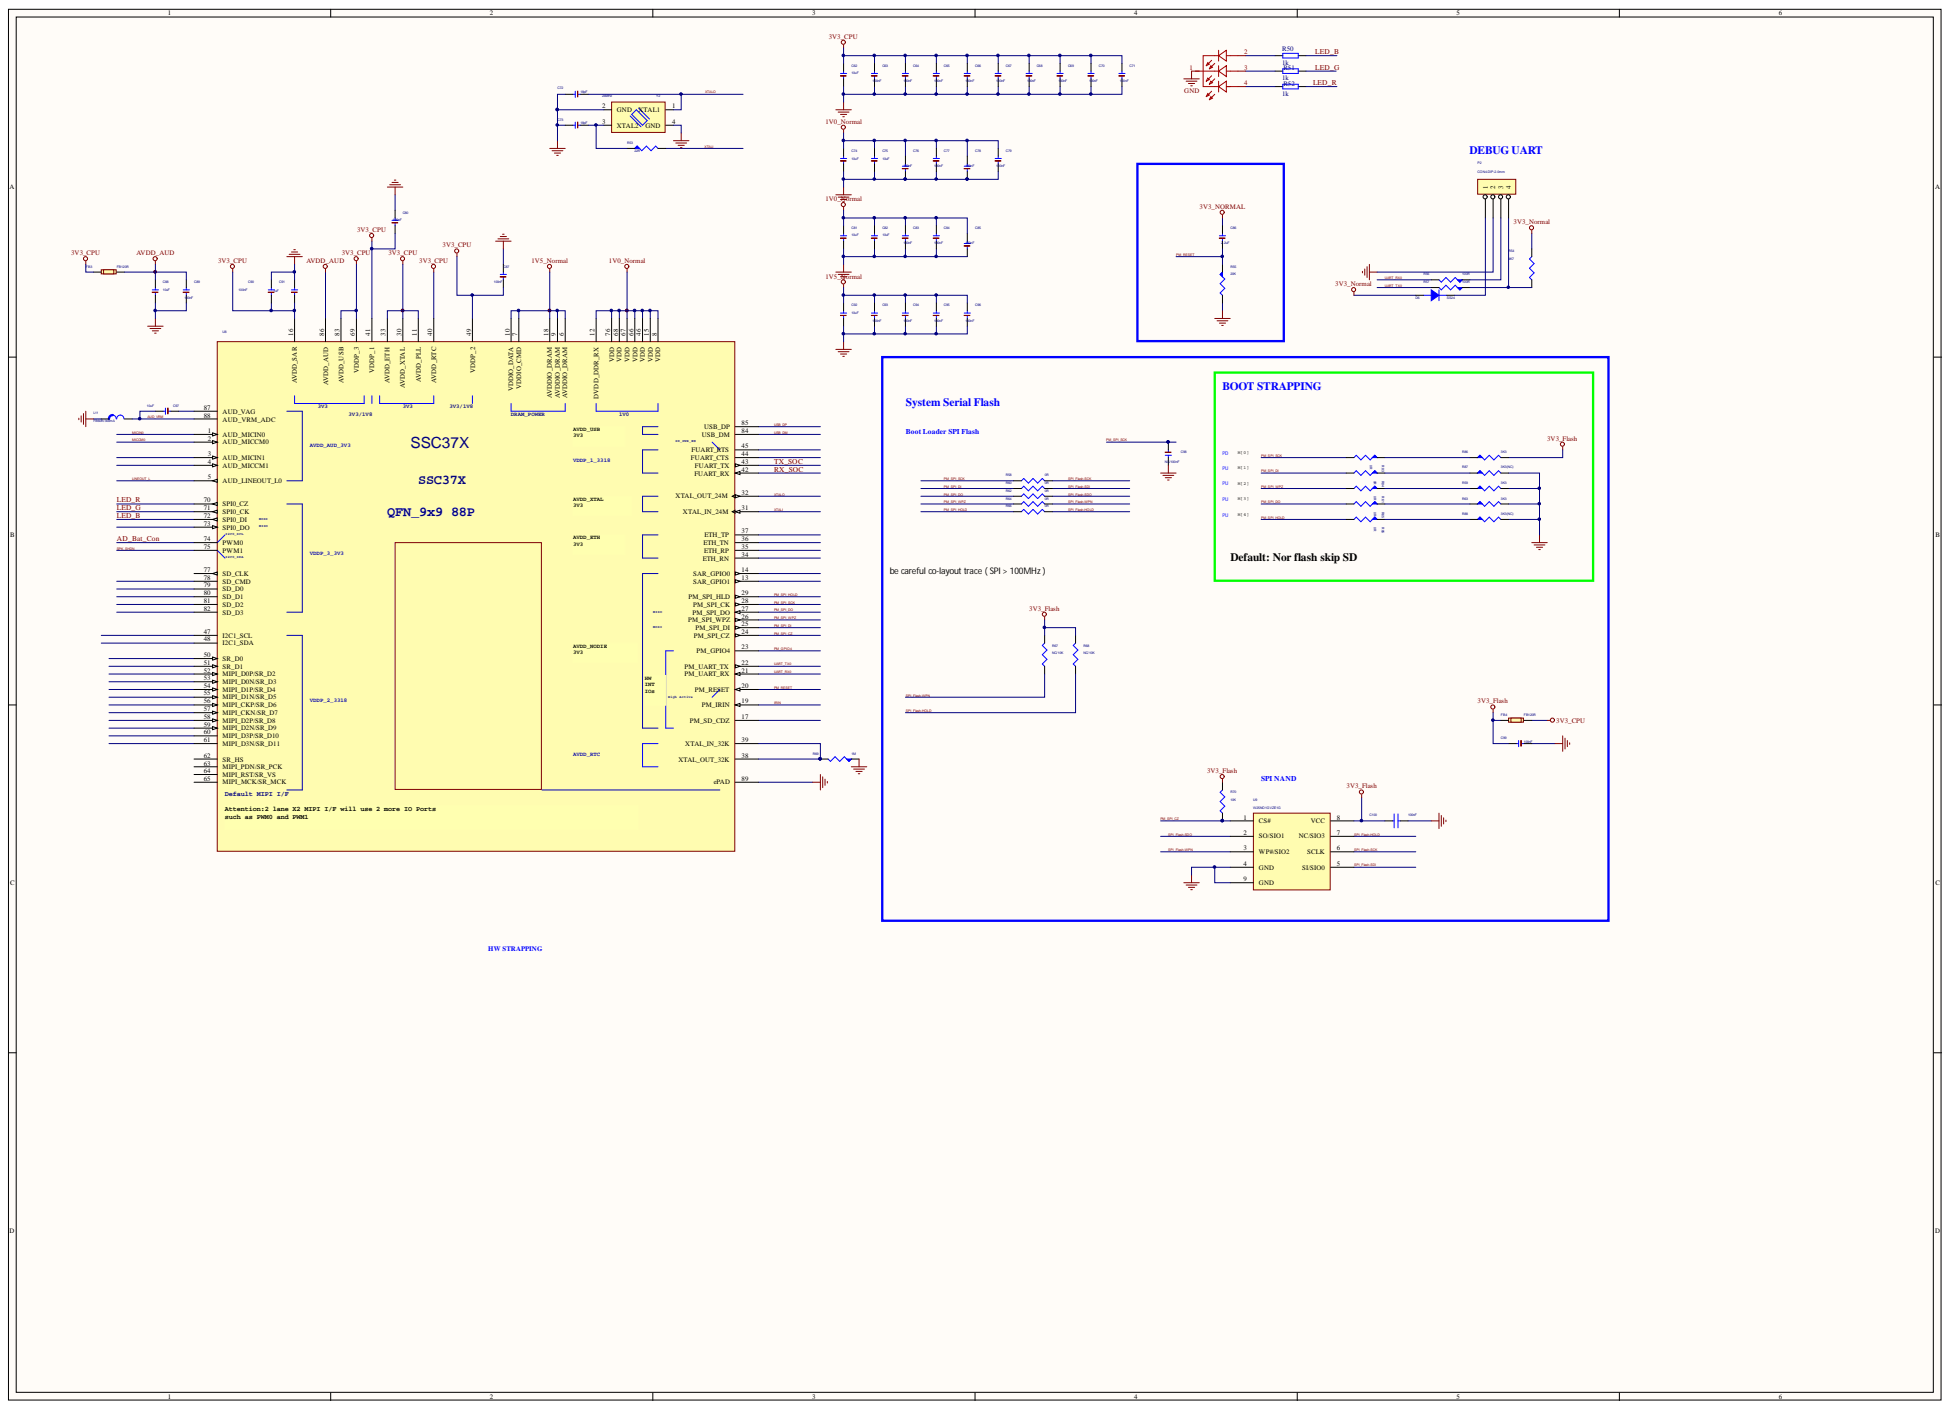
[picture p4: page 4]

Boot Loader SPI Flash

Default: Nor flash skip SD

be careful co-layout trace ( SPI > 100MHz )

Attention:2 lane X2 MIPI I/F will use 2 more IO Ports
such as PWM0 and PWM1

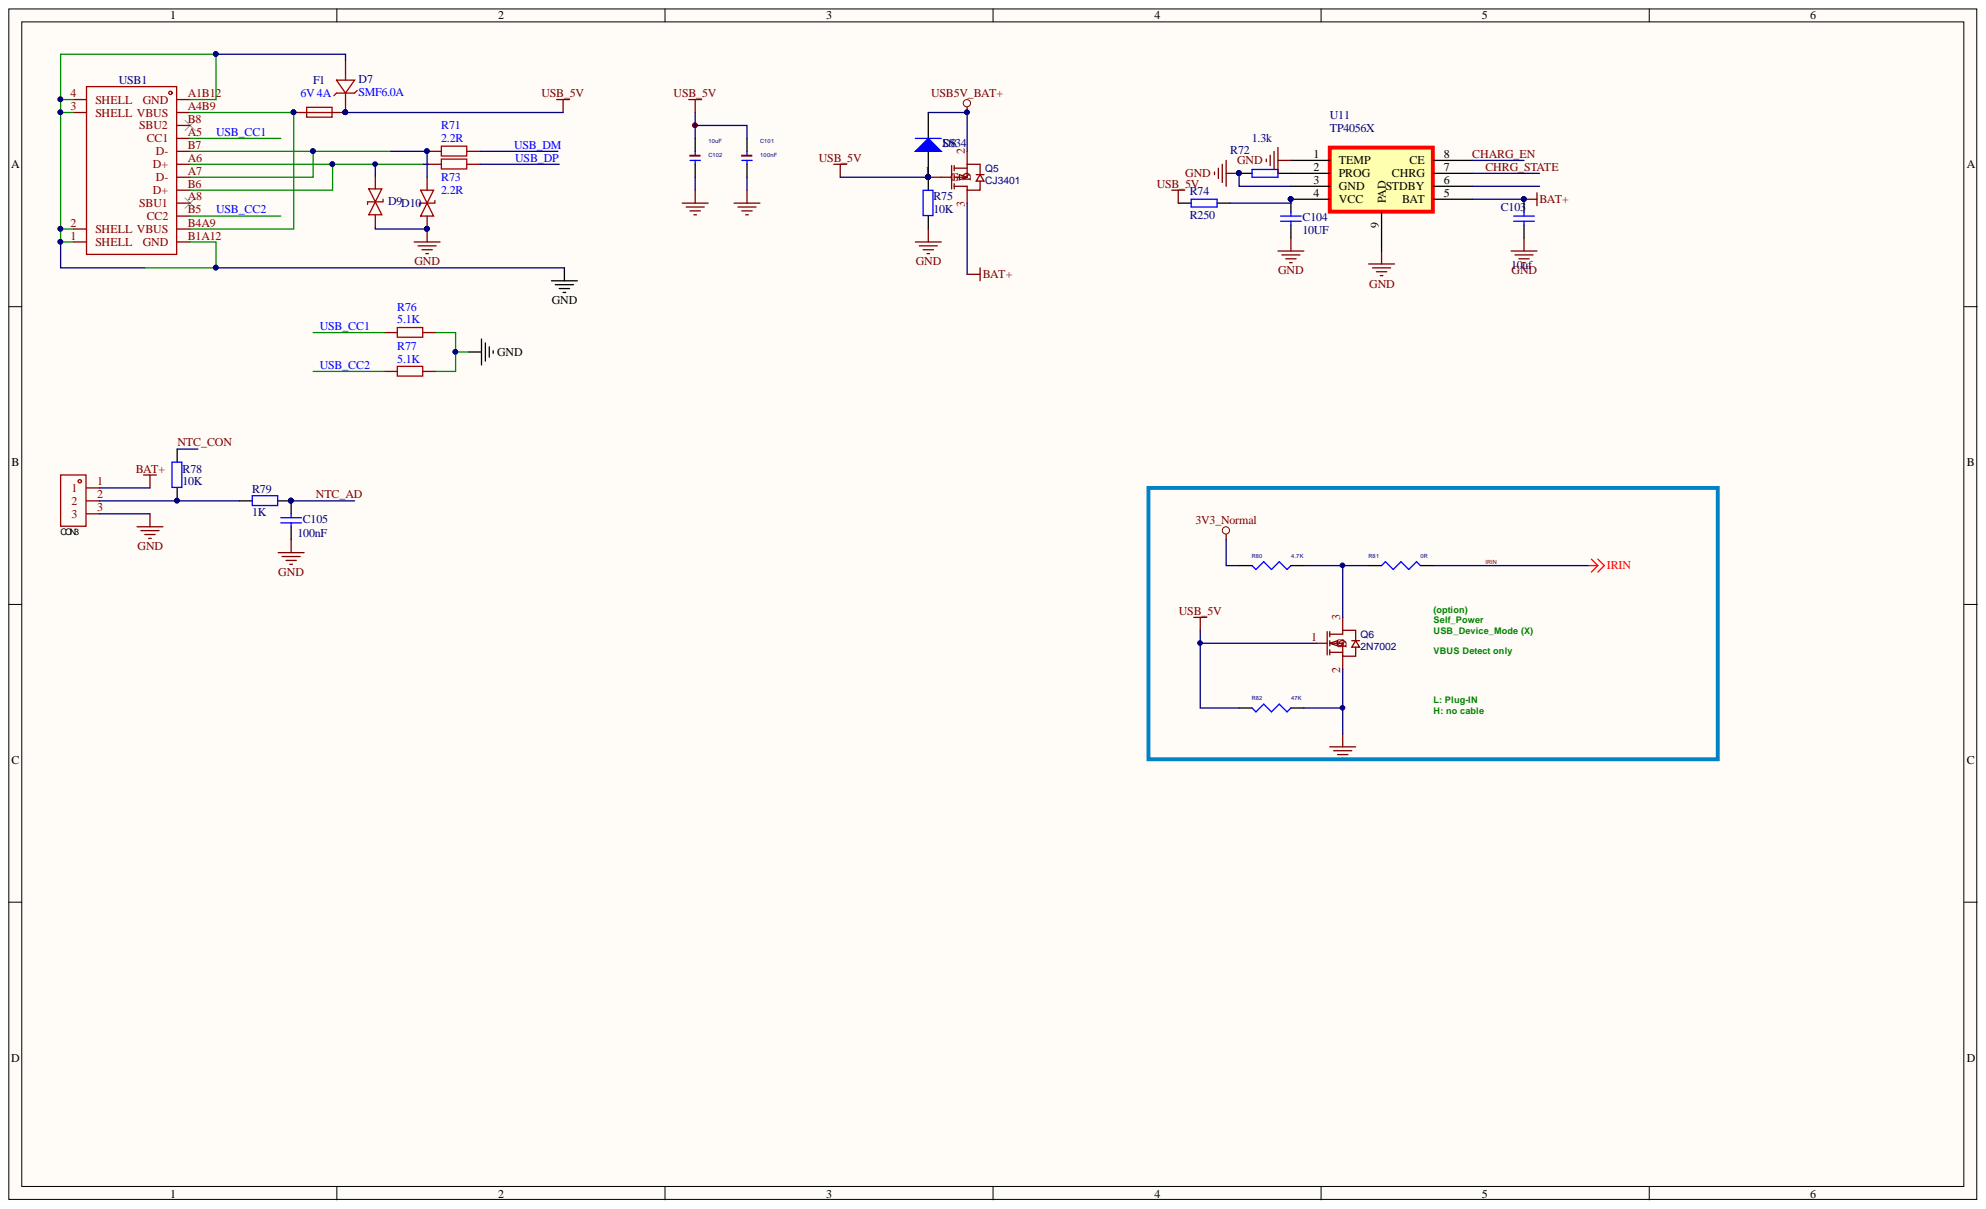
[picture p5: page 5]
