wdxm657/ble_egg_anfu/(list of files, drawings)

Other design files:
hardware/egg/AUDIO.SchDoc
hardware/egg/Bluetooth.SchDoc
hardware/egg/egg.PcbDoc
hardware/egg/egg.PrjPCB
hardware/egg/PCB2.PcbLib
hardware/egg/POWER.SchDoc
hardware/egg/QFN88_FLASH_UART.SchDoc
hardware/egg/USB_CHARGE.SchDoc
hardware/SSC375D20260602/PCB_Project5.PrjPCB
