wdxm657/ble_egg_anfu/main.c

/********************************************************************************************************
 * @file    main.c
 *
 * @brief   This is the source file for BLE SDK
 *
 * @author  BLE GROUP
 * @date    12,2021
 *
 * @par     Copyright (c) 2021, Telink Semiconductor (Shanghai) Co., Ltd. ("TELINK")
 *
 *          Licensed under the Apache License, Version 2.0 (the "License");
 *          you may not use this file except in compliance with the License.
 *          You may obtain a copy of the License at
 *
 *              http://www.apache.org/licenses/LICENSE-2.0
 *
 *          Unless required by applicable law or agreed to in writing, software
 *          distributed under the License is distributed on an "AS IS" BASIS,
 *          WITHOUT WARRANTIES OR CONDITIONS OF ANY KIND, either express or implied.
 *          See the License for the specific language governing permissions and
 *          limitations under the License.
 *
 *******************************************************************************************************/
#include "tl_common.h"
#include "drivers.h"
#include "stack/ble/ble.h"

#include "app.h"
#include "app_att.h"
#include "app_buffer.h"
#include "app_uart.h"
#include "software_uart.h"

/**
 * @brief   IRQ handler
 * @param   none.
 * @return  none.
 */
_attribute_ram_code_ void irq_handler(void)
{
    app_uart_ndma_irq_proc();
    blc_sdk_irq_handler();
#if (SOFT_UART_ENABLE)
    soft_uart_irq_handler();
#endif
}

/**
 * @brief		This is main function
 * @param[in]	none
 * @return      none
 */
#if (PM_DEEPSLEEP_RETENTION_ENABLE)
_attribute_ram_code_sec_noinline_
#endif
    int
    main(void)
{
#if (BLE_APP_PM_ENABLE)
#if (SAVE_RAM_CODE_ENABLE)
    blc_pm_select_internal_32k_crystal_save_ram();
#else
    blc_pm_select_internal_32k_crystal();
#endif
#endif

#if (BLE_OTA_SERVER_ENABLE && (FLASH_SIZE_OPTION == FLASH_SIZE_OPTION_128K))
    blc_ota_setFirmwareSizeAndBootAddress(48, MULTI_BOOT_ADDR_0x10000);
#endif

    cpu_wakeup_init(INTERNAL_CAP_XTAL24M);

    int deepRetWakeUp = pm_is_MCU_deepRetentionWakeup();  // MCU deep retention wakeUp

    rf_drv_ble_init();

    clock_init(SYS_CLK_TYPE);

    gpio_init(!deepRetWakeUp);  // analog resistance will keep available in deepSleep mode, so no need initialize again

#if (PM_DEEPSLEEP_RETENTION_ENABLE)
    if (deepRetWakeUp)
    {
        user_init_deepRetn();
    }
    else
#endif
    {

#if FIRMWARES_SIGNATURE_ENABLE
        blt_firmware_signature_check();
#endif

        user_init_normal();
    }

#if (MODULE_WATCHDOG_ENABLE)
    wd_set_interval_ms(WATCHDOG_INIT_TIMEOUT, CLOCK_SYS_CLOCK_1MS);
    wd_start();
#endif

#if (DEBUG_MODE)
    log_set_level(LOG_LEVEL_DEBUG);
#endif

    irq_enable();

    while (1)
    {
#if (MODULE_WATCHDOG_ENABLE)
        wd_clear();  // clear watch dog
#endif

        main_loop();
    }
}
