wdxm657/ble_egg_anfu/app.c

/********************************************************************************************************
 * @file    app.c
 *
 * @brief   This is the source file for BLE SDK
 *
 * @author  BLE GROUP
 * @date    12,2021
 *
 * @par     Copyright (c) 2021, Telink Semiconductor (Shanghai) Co., Ltd. ("TELINK")
 *
 *          Licensed under the Apache License, Version 2.0 (the "License");
 *          you may not use this file except in compliance with the License.
 *          You may obtain a copy of the License at
 *
 *              http://www.apache.org/licenses/LICENSE-2.0
 *
 *          Unless required by applicable law or agreed to in writing, software
 *          distributed under the License is distributed on an "AS IS" BASIS,
 *          WITHOUT WARRANTIES OR CONDITIONS OF ANY KIND, either express or implied.
 *          See the License for the specific language governing permissions and
 *          limitations under the License.
 *
 *******************************************************************************************************/
#include "tl_common.h"
#include "drivers.h"
#include "stack/ble/ble.h"
#include "app.h"
#include "app_att.h"
#include "app_ui.h"
#include "app_buffer.h"
#include "app_uart.h"
#include "app_ctrl.h"
#include "app_ultrasonic.h"
#include "app_input.h"
#include "app_adc_mon.h"
#include "adc.h"

#define ADV_IDLE_ENTER_DEEP_TIME  60  // 60 s
#define CONN_IDLE_ENTER_DEEP_TIME 60  // 60 s
#define MY_APP_ADV_CHANNEL        BLT_ENABLE_ADV_ALL
#define MY_ADV_INTERVAL_MIN       ADV_INTERVAL_20MS
#define MY_ADV_INTERVAL_MAX       ADV_INTERVAL_25MS
#define MY_RF_POWER_INDEX         RF_POWER_P2p87dBm
#define MY_DIRECT_ADV_TIME        10000000
#define BLE_DEVICE_ADDRESS_TYPE   BLE_DEVICE_ADDRESS_PUBLIC
/* 广播开启门控：MCU 与 AI SOC 串口通信建立的最长等待时间，超时判定硬件故障并重启设备 */
#define SOC_LINK_WAIT_TIMEOUT_US  15000000  // 15 s
u32 advertise_begin_tick;
u32 g_time_tick_last = 0;
#if (PM_DEEPSLEEP_ENABLE)
int device_in_connection_state;
u8  sendTerminate_before_enterDeep = 0;
u32 latest_user_event_tick;
#endif
own_addr_type_t app_own_address_type = OWN_ADDRESS_PUBLIC;

static u8 g_app_power_on = 0;

/* BLE 广播是否已在 MCU 与 AI SOC 串口通信建立成功后打开（0: 未打开, 1: 已打开） */
static u8 g_adv_enabled = 0;

void app_set_power_state(u8 on)
{
    g_app_power_on = on ? 1 : 0;
}

u8 app_get_power_state(void)
{
    return g_app_power_on;
}

u8 g_flash_uid[16];

void app_get_flash_uid(u8 *uid, u8 len)
{
    if (!uid || len == 0)
    {
        return;
    }

    u8 copy_len = (len > sizeof(g_flash_uid)) ? sizeof(g_flash_uid) : len;
    memcpy(uid, g_flash_uid, copy_len);
}

/**
 * @brief	BLE Advertising data
 */
const u8 tbl_advData[] = {
    9,
    DT_COMPLETE_LOCAL_NAME,
    'W',
    '2',
    'M',
    'C',
    'B',
    'E',
    'g',
    'g',
    2,
    DT_FLAGS,
    0x05,  // BLE limited discoverable mode and BR/EDR not supported
    3,
    DT_APPEARANCE,
    0x80,
    0x01,  // 384, Generic Remote Control, Generic category
    5,
    DT_INCOMPLETE_LIST_16BIT_SERVICE_UUID,
    0x12,
    0x18,
    0x0F,
    0x18,  // incomplete list of service class UUIDs (0x1812, 0x180F)
};
/**
 * @brief	BLE Scan Response Packet data
 */
u8 tbl_scanRsp[] = {
    9,
    DT_COMPLETE_LOCAL_NAME,
    'W',
    '2',
    'M',
    'C',
    'B',
    'E',
    'g',
    'g',
    17,
    DT_MANUFACTURER_SPECIFIC_DATA,
    0x00,
    0x01,
    0x02,
    0x03,
    0x04,
    0x05,
    0x06,
    0x07,
    0x08,
    0x09,
    0x0A,
    0x0B,
    0x0C,
    0x0D,
    0x0E,
    0x0F,
};
/**
 * @brief      callback function of LinkLayer Event "BLT_EV_FLAG_ADV_DURATION_TIMEOUT"
 * @param[in]  e - LinkLayer Event type
 * @param[in]  p - data pointer of event
 * @param[in]  n - data length of event
 * @return     none
 */
void app_switch_to_undirected_adv(u8 e, u8 *p, int n)
{
    (void)e;
    (void)p;
    (void)n;
    bls_ll_setAdvParam(MY_ADV_INTERVAL_MIN, MY_ADV_INTERVAL_MAX, ADV_TYPE_CONNECTABLE_UNDIRECTED, app_own_address_type, 0, NULL, MY_APP_ADV_CHANNEL, ADV_FP_NONE);
    bls_ll_setAdvEnable(BLC_ADV_ENABLE);  // must: set ADV enable
}
/**
 * @brief      callback function of LinkLayer Event "BLT_EV_FLAG_CONNECT"
 * @param[in]  e - LinkLayer Event type
 * @param[in]  p - data pointer of event
 * @param[in]  n - data length of event
 * @return     none
 */
void task_connect(u8 e, u8 *p, int n)
{
    bls_l2cap_requestConnParamUpdate(CONN_INTERVAL_10MS, CONN_INTERVAL_10MS, 99, CONN_TIMEOUT_4S);  // 1 S
#if (PM_DEEPSLEEP_ENABLE)
    latest_user_event_tick     = clock_time();
    device_in_connection_state = 1;
#endif
#if (UI_LED_ENABLE)
    LOG_D("[APP][CONN] Connect request");
#endif
    g_ble_connected = 1;
    u8 linked = 1;
    app_uart_send_cmd(UART_SOC_BT_LINK_NOTIFY, &linked, 1, NULL);
}
/**
 * @brief      callback function of LinkLayer Event "BLT_EV_FLAG_TERMINATE"
 * @param[in]  e - LinkLayer Event type
 * @param[in]  p - data pointer of event
 * @param[in]  n - data length of event
 * @return     none
 */
void task_terminate(u8 e, u8 *p, int n)  //*p is terminate reason
{
#if (PM_DEEPSLEEP_ENABLE)
    device_in_connection_state = 0;
#endif
    g_ble_connected = 0;
    u8 linked = 0;
    app_uart_send_cmd(UART_SOC_BT_LINK_NOTIFY, &linked, 1, NULL);
    tlk_contr_evt_terminate_t *pEvt = (tlk_contr_evt_terminate_t *)p;
    if (pEvt->terminate_reason == HCI_ERR_CONN_TIMEOUT)
    {
    }
    else if (pEvt->terminate_reason == HCI_ERR_REMOTE_USER_TERM_CONN)
    {
    }
    else if (pEvt->terminate_reason == HCI_ERR_CONN_TERM_MIC_FAILURE)
    {
    }
    else
    {
    }
#if (PM_DEEPSLEEP_ENABLE)
    // user has push terminate pkt to ble TX buffer before deepsleep
    if (sendTerminate_before_enterDeep == 1)
    {
        sendTerminate_before_enterDeep = 2;
    }
#endif
#if (UI_LED_ENABLE)
    LOG_D("[APP][TERMINATE] Terminate request");
#endif
    advertise_begin_tick = clock_time();
}
/**
 * @brief      callback function of LinkLayer Event "BLT_EV_FLAG_SUSPEND_EXIT"
 * @param[in]  e - LinkLayer Event type
 * @param[in]  p - data pointer of event
 * @param[in]  n - data length of event
 * @return     none
 */
void task_suspend_exit(u8 e, u8 *p, int n)
{
    (void)e;
    (void)p;
    (void)n;
    rf_set_power_level_index(MY_RF_POWER_INDEX);
}

_attribute_data_retention_ static u32 scan_cycle_tick = 0;
u8                                    scan_pm_disable = 0;
#define KEY_SM_IDLE                    0
#define KEY_SM_PRESS_DEBOUNCE          1
#define KEY_SM_PRESSED                 2
#define KEY_SM_RELEASE_DEBOUNCE        3
#define KEY_DEBOUNCE_US                (20 * 1000)    // 按键去抖 20ms
#define KEY_SLEEP_ENABLE_DELAY_US      (5 * 1000000)  // 初始化后 5s 才允许按键进深睡
// scan cycle and active time
#define SCAN_CYCLE_US  (1 * 1000000)
#define SCAN_ACTIVE_US (1 * 1000 * 1000)


#if (PM_DEEPSLEEP_ENABLE)
static void app_request_deep_sleep(void)
{
    if (device_in_connection_state)
    {
        BLE_LOG_D("deep sleep conn");
        bls_ll_terminateConnection(HCI_ERR_REMOTE_USER_TERM_CONN);
        bls_ll_setAdvEnable(0);
        sendTerminate_before_enterDeep = 1;
    }
    else
    {
        app_adc_mon_bat_percent_save_to_flash();
        cpu_set_gpio_wakeup(USB_DET, Level_Low, 1);
        gpio_setup_up_down_resistor(GPIO_CHARGE_EN, PM_PIN_PULLUP_10K);
        cpu_set_gpio_wakeup(GPIO_KEY, Level_Low, 1);
        gpio_setup_up_down_resistor(GPIO_KEY, PM_PIN_PULLUP_10K);

        gpio_write(GPIO_SOC_SWITCH, !LED_ON_LEVEL);
        gpio_setup_up_down_resistor(GPIO_SOC_SWITCH, PM_PIN_PULLDOWN_100K);
        gpio_write(GPIO_LED_CHARGE_GREN, !LED_ON_LEVEL);
        gpio_write(GPIO_LED_CHARGE_RED, !LED_ON_LEVEL);
        gpio_write(GPIO_NTC_AD_EN, 0);
        // SOC端配置ADC开关
        // gpio_write(V_BAT_CON, 0);

        LOG_D("deep sleep no conn");
        cpu_sleep_wakeup(DEEPSLEEP_MODE, PM_WAKEUP_PAD, 0);
    }
}
#endif
static u32 key_sleep_enable_tick = 0;

/**
 * @brief      power management code for application
 * @param[in]  none
 * @return     none
 */
void blt_pm_proc(void)
{
#if PM_DEEPSLEEP_ENABLE
    if (sendTerminate_before_enterDeep == 2)
    {
        app_request_deep_sleep();
        return;
    }
#endif
#if (BLE_APP_PM_ENABLE)
    static u8  key_sm   = KEY_SM_IDLE;
    static u32 key_tick = 0;
#if (PM_DEEPSLEEP_RETENTION_ENABLE)
#if (SCAN_ENABLE)
    if (scan_cycle_tick == 0)
    {
        scan_cycle_tick = clock_time();
    }
    u32 now = clock_time();
    if (clock_time_exceed(scan_cycle_tick, SCAN_CYCLE_US))
    {
        scan_cycle_tick = now;
    }
    u32 delta = now - scan_cycle_tick;
    if (delta < SCAN_ACTIVE_US)
    {
        bls_pm_setSuspendMask(SUSPEND_DISABLE);
    }
    else
    {
        bls_pm_setSuspendMask(SUSPEND_ADV | DEEPSLEEP_RETENTION_ADV | SUSPEND_CONN | DEEPSLEEP_RETENTION_CONN);
    }
#else
    // 直接进入睡眠状态
    bls_pm_setSuspendMask(SUSPEND_ADV | DEEPSLEEP_RETENTION_ADV | SUSPEND_CONN | DEEPSLEEP_RETENTION_CONN);
#endif
#else
    if ((blc_ll_getCurrentState() & BLS_LINK_STATE_CONN) || g_app_power_on)
    {
        bls_pm_setSuspendMask(SUSPEND_DISABLE);
    }
#endif
#if (BLE_OTA_SERVER_ENABLE)
    if (ota_is_working)
    {
        bls_pm_setSuspendMask(SUSPEND_DISABLE);
    }
#endif
#if (UI_KEYBOARD_ENABLE)
    if (scan_pin_need || key_not_released)
    {
        bls_pm_setManualLatency(0);
    }
#endif
#if (PM_DEEPSLEEP_ENABLE)  // test connection power, should disable deepSleep
    // 检测按键：按下去抖确认 -> 松开去抖确认后，才进入深睡
    {
        u8 key_down = !gpio_read(GPIO_KEY);

        switch (key_sm)
        {
        case KEY_SM_IDLE:
            if (key_down)
            {
                key_sm   = KEY_SM_PRESS_DEBOUNCE;
                key_tick = clock_time();
            }
            break;

        case KEY_SM_PRESS_DEBOUNCE:
            if (!key_down)
            {
                key_sm = KEY_SM_IDLE;
            }
            else if (clock_time_exceed(key_tick, KEY_DEBOUNCE_US))
            {
                if (!gpio_read(GPIO_KEY))
                {
                    key_sm = KEY_SM_PRESSED;
                }
                else
                {
                    key_sm = KEY_SM_IDLE;
                }
            }
            break;

        case KEY_SM_PRESSED:
            if (!key_down)
            {
                key_sm   = KEY_SM_RELEASE_DEBOUNCE;
                key_tick = clock_time();
            }
            break;

        case KEY_SM_RELEASE_DEBOUNCE:
            if (key_down)
            {
                key_sm = KEY_SM_PRESSED;
            }
            else if (clock_time_exceed(key_tick, KEY_DEBOUNCE_US))
            {
                if (!gpio_read(GPIO_KEY))
                {
                    key_sm = KEY_SM_PRESSED;
                    break;
                }
                key_sm = KEY_SM_IDLE;
                if (!clock_time_exceed(key_sleep_enable_tick, KEY_SLEEP_ENABLE_DELAY_US))
                {
                    break;
                }
                app_request_deep_sleep();
            }
            break;

        default:
            key_sm = KEY_SM_IDLE;
            break;
        }
    }

    if (clock_time_exceed(key_sleep_enable_tick, KEY_SLEEP_ENABLE_DELAY_US * 12) &&
        !app_adc_mon_is_charging() && app_adc_mon_get_bat_percent_exact() < 5)
    {
        app_request_deep_sleep();
    }

#endif  // end of PM_DEEPSLEEP_ENABLE
    /*
     * SOC UART has no flow control and is not configured as a wake source.
     * Allowing BLE suspend while the SOC is alive can drop bytes from the
     * 10-byte heartbeat frame, leaving fragments such as "55 AA ... 55 AA"
     * that both sides later parse as invalid frames. Keep normal explicit
     * deep-sleep paths above, but do not enter BLE suspend during runtime.
     */
    bls_pm_setSuspendMask(SUSPEND_DISABLE);
#endif  // END of  BLE_APP_PM_ENABLE
}

#if (APP_BATT_CHECK_ENABLE)  // battery check must do before OTA relative operation
_attribute_data_retention_ u32 lowBattDet_tick = 0;
/**
 * @brief		this function is used to process battery power.
 * 				The low voltage protection threshold 2.0V is an example and reference value. Customers should
 * 				evaluate and modify these thresholds according to the actual situation. If users have unreasonable designs
 * 				in the hardware circuit, which leads to a decrease in the stability of the power supply network, the
 * 				safety thresholds must be increased as appropriate.
 * @param[in]	none
 * @return      none
 */
_attribute_ram_code_ void user_battery_power_check(u16 alarm_vol_mv)
{
    /*For battery-powered products, as the battery power will gradually drop, when the voltage is low to a certain
      value, it will cause many problems.
            a) When the voltage is lower than operating voltage range of chip, chip can no longer guarantee stable operation.
            b) When the battery voltage is low, due to the unstable power supply, the write and erase operations
                    of Flash may have the risk of error, causing the program firmware and user data to be modified abnormally,
                    and eventually causing the product to fail. */
    u8 battery_check_returnValue = 0;
    if (analog_read(USED_DEEP_ANA_REG) & LOW_BATT_FLG)
    {
        battery_check_returnValue = app_battery_power_check(alarm_vol_mv + 200);
    }
    else
    {
        battery_check_returnValue = app_battery_power_check(alarm_vol_mv);
    }
    if (battery_check_returnValue)
    {
        analog_write(USED_DEEP_ANA_REG, analog_read(USED_DEEP_ANA_REG) & (~LOW_BATT_FLG));  // clr
    }
    else
    {
#if (UI_LED_ENABLE)  // led indicate
        for (int k = 0; k < 3; k++)
        {
            gpio_write(GPIO_LED_BLUE, LED_ON_LEVEL);
            sleep_us(200000);
            gpio_write(GPIO_LED_BLUE, !LED_ON_LEVEL);
            sleep_us(200000);
        }
#endif
        if (analog_read(USED_DEEP_ANA_REG) & LOW_BATT_FLG)
        {
            LOG_D("[APP][BAT] The battery voltage is lower than %dmV, shut down!!!", (alarm_vol_mv + 200));
        }
        else
        {
            LOG_D("[APP][BAT] The battery voltage is lower than %dmV, shut down!!!", alarm_vol_mv);
        }
        analog_write(USED_DEEP_ANA_REG, analog_read(USED_DEEP_ANA_REG) | LOW_BATT_FLG);  // mark
#if (UI_KEYBOARD_ENABLE)
        u32 pin[] = KB_DRIVE_PINS;
        for (int i = 0; i < (sizeof(pin) / sizeof(*pin)); i++)
        {
            cpu_set_gpio_wakeup(pin[i], Level_High, 1);  // drive pin pad high wakeup deepsleep
        }
        cpu_sleep_wakeup(DEEPSLEEP_MODE, PM_WAKEUP_PAD, 0);  // deepsleep
#endif
    }
}
#endif
#define COLLOR_NAME "NimBLE_GATT"
#include <string.h>
#if (SCAN_ENABLE)
// 解析并打印一个广播 / 扫描响应数据包中的所有 AD Structure
static void print_adv_data(event_adv_report_t *pa)
{
    u8  *data            = pa->data;
    u8   total_len       = pa->len;  // 有效数据长度 (0~31)
    u8   index           = 0;
    u8   dev_name_flag   = 0;
    u8   uuid16_flag     = 0;
    u8   uuid32_flag     = 0;
    u8   uuid128_flag    = 0;
    u16  uuid16_val      = 0;
    u32  uuid32_val      = 0;
    u8   uuid128_val[16] = {0};
    char name[32]        = {0};
    // RSSI 在 data[total_len]（即 len 后面的那个字节）
    s8 rssi = (s8)data[total_len];  // rssi has already plus 110.
    // 1) 如需看原始字节流，可取消下面注释
    // for (u8 i = 0; i < total_len; ++i) {
    //     tl_printf("0x%02x ", data[i]);
    // }
    // tl_printf("\r\n");
    // 2) 按 AD Structure 解析
    while (index < total_len)
    {
        u8 len = data[index];  // 本 AD 结构长度（不含自己这个 length 字节）
        // 长度为 0：后面都是 padding（非有效数据），直接结束
        if (len == 0)
        {
            break;
        }
        // 当前结构总占用字节数：1(长度) + len
        u16 struct_total = 1 + len;
        // 越界检查，避免访问到无效内存
        if (index + struct_total > total_len)
        {
            LOG_W("AD struct out of range: index=%d, len=%d, total_len=%d",
                  index,
                  len,
                  total_len);
            break;
        }
        u8  ad_type   = data[index + 1];
        u8  value_len = len - 1;  // 去掉 type
        u8 *ad_value  = &data[index + 2];
        // 根据 AD Type 解析
        switch (ad_type)
        {
        // ===== 16-bit UUID 列表：0x02 / 0x03 =====
        case 0x02:  // 非完整的 16 bit UUID 列表
        case 0x03:  // 完整的 16 bit UUID 列表
        {
            u8 pos = 0;
            while (pos + 1 < value_len)
            {
                // BLE 小端：低字节在前
                u16 uuid16 = (u16)ad_value[pos] |
                             ((u16)ad_value[pos + 1] << 8);
                // 只记录第一个 UUID16，用于后面统一打印
                if (!uuid16_flag)
                {
                    uuid16_val  = uuid16;
                    uuid16_flag = 1;
                }
                pos += 2;
            }
            break;
        }
        // ===== 32-bit UUID 列表：0x04 / 0x05 =====
        case 0x04:  // 非完整的 32 bit UUID 列表
        case 0x05:  // 完整的 32 bit UUID 列表
        {
            u8 pos = 0;
            while (pos + 3 < value_len)
            {
                u32 uuid32 = (u32)ad_value[pos] |
                             ((u32)ad_value[pos + 1] << 8) |
                             ((u32)ad_value[pos + 2] << 16) |
                             ((u32)ad_value[pos + 3] << 24);
                // 只记录第一个 UUID32，用于后面统一打印
                if (!uuid32_flag)
                {
                    uuid32_val  = uuid32;
                    uuid32_flag = 1;
                }
                pos += 4;
            }
            break;
        }
        // ===== 128-bit UUID 列表：0x06 / 0x07 =====
        case 0x06:  // 非完整的 128 bit UUID 列表
        case 0x07:  // 完整的 128 bit UUID 列表
        {
            u8 pos = 0;
            while (pos + 15 < value_len)
            {
                // 只记录第一个 UUID128，用于后面统一打印
                if (!uuid128_flag)
                {
                    for (u8 k = 0; k < 16; ++k)
                    {
                        uuid128_val[k] = ad_value[pos + k];
                    }
                    uuid128_flag = 1;
                }
                pos += 16;
            }
            break;
        }
        // ===== 设备名：0x08 / 0x09 =====
        case 0x08:  // Shortened Local Name
        case 0x09:  // Complete Local Name
        {
            if (value_len > 0)
            {
                u8 copy_len = (value_len < (sizeof(name) - 1)) ? value_len : (sizeof(name) - 1);
                memcpy(name, ad_value, copy_len);
                if (strcmp(name, COLLOR_NAME) == 0)
                {
                    dev_name_flag = 1;
                }
            }
            break;
        }
        default:
            // 其它类型暂不处理，必要时可以在这里加日志
            break;
        }
        // 跳到下一个 AD Structure
        index += struct_total;
    }
    // 统一输出：根据是否同时存在 UUID 和 Name 决定打印内容
    if (dev_name_flag || uuid16_flag || uuid32_flag || uuid128_flag)
    {
        if (dev_name_flag)
        {
            if (uuid16_flag)
            {
                LOG_D("  UUID16: 0x%04x, Name: %s db=%d", (unsigned int)uuid16_val, name, rssi);
            }
            else if (uuid32_flag)
            {
                LOG_D("  UUID32: 0x%08x, Name: %s db=%d", (unsigned int)uuid32_val, name, rssi);
            }
            else
            {
                LOG_D("  Device Name: %s db=%d", name, rssi);
            }
        }
        //  else {
        // 	if (uuid16_flag) {
        // 		LOG_D("  UUID16: 0x%04x db=%d", (unsigned int)uuid16_val, rssi);
        // 	} else if (uuid32_flag) {
        // 		LOG_D("  UUID32: 0x%08x db=%d", (unsigned int)uuid32_val, rssi);
        // 	}
        // }
    }
}
/**
 * @brief      callback function of HCI Controller Event
 * @param[in]  h - HCI Event type
 * @param[in]  p - data pointer of event
 * @param[in]  n - data length of event
 * @return     none
 */
int controller_event_callback(u32 h, u8 *p, int n)
{
    if (h & HCI_FLAG_EVENT_BT_STD)  // ble controller hci event
    {
        u8 evtCode = h & 0xff;
        if (evtCode == HCI_EVT_LE_META)
        {
            u8 subEvt_code = p[0];
            if (subEvt_code == HCI_SUB_EVT_LE_ADVERTISING_REPORT)  // ADV packet
            {
                DBG_CHN6_TOGGLE;
                // after controller is set to scan state, it will report all the adv packet it received by this event
                event_adv_report_t *pa = (event_adv_report_t *)p;
                // 打印 data 的全部内容 + 解析 AD 结构
                print_adv_data(pa);
#if (DBG_ADV_REPORT_ON_RAM)
                if (pa->len > 31)
                {
                    pa->len = 31;
                }
                memcpy((u8 *)AA_advRpt[AA_advRpt_index++], p, pa->len + 11);
                if (AA_advRpt_index >= RAM_ADV_MAX)
                {
                    AA_advRpt_index = 0;
                }
#endif
            }
        }
    }
    return 0;
}
#endif
/**
 * @brief		user initialization when MCU power on or wake_up from deepSleep mode
 * @param[in]	none
 * @return      none
 */
_attribute_no_inline_ void user_init_normal(void)
{
    //////////////////////////// personal hardware Initialization  Begin //////////////////////////////////
    app_uart_init();
    app_ctrl_init();

    // GPIO init — 根据 app_config.h 引脚定义（EVK=0, UI_LED_ENABLE=1）
#if (UI_LED_ENABLE)
#if !(EVK)
    /* 输出引脚初始化 */
    gpio_set_func(GPIO_SOC_SWITCH, PD4_FUNC);
    gpio_set_output_en(GPIO_SOC_SWITCH, PD4_OUTPUT_ENABLE);
    gpio_write(GPIO_SOC_SWITCH, !LED_ON_LEVEL);
    sleep_ms(1000);
    gpio_write(GPIO_SOC_SWITCH, LED_ON_LEVEL);

    gpio_set_func(GPIO_LED_CHARGE_GREN, PC0_FUNC);
    gpio_set_output_en(GPIO_LED_CHARGE_GREN, PC0_OUTPUT_ENABLE);
    gpio_write(GPIO_LED_CHARGE_GREN, LED_ON_LEVEL);        // 充电绿灯默认灭

    gpio_set_func(GPIO_LED_CHARGE_RED, PC1_FUNC);
    gpio_set_output_en(GPIO_LED_CHARGE_RED, PC1_OUTPUT_ENABLE);
    gpio_write(GPIO_LED_CHARGE_RED, LED_ON_LEVEL);          // 充电红灯默认灭

    gpio_set_func(GPIO_CHARGE_EN, PB6_FUNC);
    gpio_set_output_en(GPIO_CHARGE_EN, PB6_OUTPUT_ENABLE);
    gpio_write(GPIO_CHARGE_EN, 1);                          // 充电使能默认开启

    gpio_set_func(GPIO_NTC_AD_EN, PB5_FUNC);
    gpio_set_output_en(GPIO_NTC_AD_EN, PB5_OUTPUT_ENABLE);
    gpio_write(GPIO_NTC_AD_EN, 1);                          // NTC 检测默认开启

    // gpio_set_func(GPIO_BAT_AD_EN, PBx_FUNC);
    // gpio_set_output_en(GPIO_BAT_AD_EN, PBx_OUTPUT_ENABLE);
    // gpio_write(GPIO_BAT_AD_EN, 1);                          // BAT 检测默认开启
    
    gpio_set_func(GPIO_ULTAR_EN, PB3_FUNC);
    gpio_set_output_en(GPIO_ULTAR_EN, PB3_OUTPUT_ENABLE);
    gpio_write(GPIO_ULTAR_EN, 0);                           // 超声波默认关闭

    /* 输入引脚初始化 */
    gpio_set_func(GPIO_CHARGE_STATE, PB7_FUNC);           // 充电状态检测
    gpio_set_input_en(GPIO_CHARGE_STATE, PB7_INPUT_ENABLE);
    gpio_setup_up_down_resistor(GPIO_CHARGE_STATE, PM_PIN_PULLUP_10K);

    gpio_set_func(USB_DET, PD0_FUNC);                     // USB插入检测
    gpio_set_input_en(USB_DET, PD0_INPUT_ENABLE);
    gpio_setup_up_down_resistor(USB_DET, PM_PIN_PULLUP_10K);

    gpio_set_func(GPIO_KEY, PD0_FUNC);                     // 按键检测
    gpio_set_input_en(GPIO_KEY, PD0_INPUT_ENABLE);
    gpio_setup_up_down_resistor(GPIO_KEY, PM_PIN_PULLUP_10K);
#endif
#endif
#if (PM_DEEPSLEEP_ENABLE)
    key_sleep_enable_tick = clock_time();
#endif
    //////////////////////////// peripheral hardware Initialization  End //////////////////////////////////
    //////////////////////////// basic hardware Initialization  Begin //////////////////////////////////
    /* random number generator must be initiated before any BLE stack initialization.
     * When deepSleep retention wakeUp, no need initialize again */
    random_generator_init();
    blc_readFlashSize_autoConfigCustomFlashSector();
    /* attention that this function must be called after "blc_readFlashSize_autoConfigCustomFlashSector" !!!*/
    blc_app_loadCustomizedParameters_normal();
/* attention that this function must be called after "blc_app_loadCustomizedParameters_normal" !!!
   The reason is that the low battery check need the ADC calibration parameter, and this parameter
   is loaded in blc_app_loadCustomizedParameters_normal.
 */
#if (APP_BATT_CHECK_ENABLE)
    /*The SDK must do a quick low battery detect during user initialization instead of waiting
      until the main_loop. The reason for this process is to avoid application errors that the device
      has already working at low power.
      Considering the working voltage of MCU and the working voltage of flash, if the Demo is set below 2.0V,
      the chip will alarm and deep sleep (Due to PM does not work in the current version of B92, it does not go
      into deepsleep), and once the chip is detected to be lower than 2.0V, it needs to wait until the voltage rises to 2.2V,
      the chip will resume normal operation. Consider the following points in this design:
            At 2.0V, when other modules are operated, the voltage may be pulled down and the flash will not
            work normally. Therefore, it is necessary to enter deepsleep below 2.0V to ensure that the chip no
            longer runs related modules;
            When there is a low voltage situation, need to restore to 2.2V in order to make other functions normal,
            this is to ensure that the power supply voltage is confirmed in the charge and has a certain amount of
            power, then start to restore the function can be safer.*/
    user_battery_power_check(VBAT_ALARM_THRES_MV);
#endif
#if (APP_FLASH_PROTECTION_ENABLE)
    app_flash_protection_operation(FLASH_OP_EVT_APP_INITIALIZATION, 0, 0);
    blc_appRegisterStackFlashOperationCallback(app_flash_protection_operation);  // register flash operation callback for stack
#endif
    //////////////////////////// basic hardware Initialization  End //////////////////////////////////
    //////////////////////////// BLE stack Initialization  Begin //////////////////////////////////
    //////////// Controller Initialization  Begin /////////////////////////
    u8 mac_public[6];
    u8 mac_random_static[6];
    /* for 512K Flash, flash_sector_mac_address equals to 0x7F000, for 128K  Flash, flash_sector_mac_address equals to 0x1F000 */
    blc_initMacAddress(flash_sector_mac_address, mac_public, mac_random_static);
#if (BLE_DEVICE_ADDRESS_TYPE == BLE_DEVICE_ADDRESS_PUBLIC)
    app_own_address_type = OWN_ADDRESS_PUBLIC;
#elif (BLE_DEVICE_ADDRESS_TYPE == BLE_DEVICE_ADDRESS_RANDOM_STATIC)
    app_own_address_type = OWN_ADDRESS_RANDOM;
    blc_ll_setRandomAddr(mac_random_static);
#endif
    blc_ll_initBasicMCU();                  // mandatory
    blc_ll_initStandby_module(mac_public);  // mandatory
    blc_ll_initAdvertising_module();        // legacy advertising module: mandatory for BLE slave
    blc_ll_initSlaveRole_module();          // slave module: mandatory for BLE slave,
    blc_ll_setAclConnMaxOctetsNumber(ACL_CONN_MAX_RX_OCTETS, ACL_CONN_MAX_TX_OCTETS);
    blc_ll_initAclConnTxFifo(app_acl_txfifo, ACL_TX_FIFO_SIZE, ACL_TX_FIFO_NUM);
    blc_ll_initAclConnRxFifo(app_acl_rxfifo, ACL_RX_FIFO_SIZE, ACL_RX_FIFO_NUM);
    //////////// Controller Initialization  End /////////////////////////
    //////////// Host Initialization  Begin /////////////////////////
    /* GAP initialization must be done before any other host feature initialization !!! */
    blc_gap_peripheral_init();  // gap initialization
    /* GATT Initialization */
    my_gatt_init();
    /* L2CAP Initialization */
    blc_l2cap_register_handler(blc_l2cap_packet_receive);
    blc_l2cap_initRxDataBuffer(app_l2cap_rx_fifo, L2CAP_RX_BUFF_SIZE);
/* SMP Initialization */
/* SMP Initialization may involve flash write/erase(when one sector stores too much information,
 *   is about to exceed the sector threshold, this sector must be erased, and all useful information
 *   should re_stored) , so it must be done after battery check */
#if (BLE_APP_SECURITY_ENABLE)
    bls_smp_configPairingSecurityInfoStorageAddr(flash_sector_smp_storage);
    blc_smp_param_setBondingDeviceMaxNumber(4);  // default is 4, can not bigger than this value
                                                 // and this func must call before bls_smp_enableParing
    blc_smp_peripheral_init();
    blc_smp_setSecurityLevel(Unauthenticated_Pairing_with_Encryption);
#else
    blc_smp_setSecurityLevel(No_Security);
#endif
//////////// Host Initialization  End /////////////////////////
//////////// Service Initialization  Begin /////////////////////////
#if (BLE_OTA_SERVER_ENABLE)
    /* OTA module initialization must be called after "blc_ota_setNewFirmwareStorageAddress"(if used), and before any other OTA API.*/
    blc_ota_initOtaServer_module();
    blc_ota_setOtaProcessTimeout(60);  // set OTA whole process timeout
    blc_ota_registerOtaStartCmdCb(app_enter_ota_mode);
    blc_ota_registerOtaFirmwareVersionReqCb(app_get_firmware_version);
    blc_ota_registerOtaResultIndicationCb(app_ota_result);
#endif
    //////////// Service Initialization  End   /////////////////////////
    //////////////////////////// BLE stack Initialization  End //////////////////////////////////
    //////////////////////////// User Configuration for BLE application ////////////////////////////
    ////////////////// config ADV packet /////////////////////
    u8 adv_param_status = BLE_SUCCESS;
#if (BLE_APP_SECURITY_ENABLE)
    u8               bond_number = blc_smp_param_getCurrentBondingDeviceNumber();  // get bonded device number
    smp_param_save_t bondInfo;
    if (bond_number)  // at least 1 bonding device exist
    {
        // get the latest bonding device (index: bond_number-1 )
        bls_smp_param_loadByIndex(bond_number - 1, &bondInfo);
        /* set direct ADV
         * bondInfo.peer_addr_type & bondInfo.peer_addr is the address in the air packet of "CONNECT_IND" PDU stored in Flash.
         * if peer address is IDA(identity address), bondInfo.peer_addr is OK used here.
         * if peer address is RPA(resolved private address), bondInfo.peer_addr is one RPA peer device has used, it has a correct relation
         * with peer IRK, so it can match to peer device at any time even peer device changes it's RPA. */
        adv_param_status = bls_ll_setAdvParam(MY_ADV_INTERVAL_MIN, MY_ADV_INTERVAL_MAX, ADV_TYPE_CONNECTABLE_DIRECTED_LOW_DUTY, app_own_address_type, bondInfo.peer_addr_type, bondInfo.peer_addr, MY_APP_ADV_CHANNEL, ADV_FP_NONE);
        /* If IRK distributed by peer device is valid, peer device may use RPA(resolved private address) at any time,
         * even if it used IDA(identity address) in first pairing phase.
         * So here must add peer IRK to resolving list and enable address resolution, since local device should check if
         * "CONNECT_IND" PDU is sent by the device directed to.
         * attention: local RPA not used, so parameter "local_irk" set to NULL */
        if (blc_app_isIrkValid(bondInfo.peer_irk))
        {
            ll_resolvingList_add(bondInfo.peer_id_adrType, bondInfo.peer_id_addr, bondInfo.peer_irk, NULL);
            ll_resolvingList_setAddrResolutionEnable(1);
        }
        // it is recommended that direct ADV only last for several seconds, then switch to undirected adv
        bls_ll_setAdvDuration(MY_DIRECT_ADV_TIME, 1);
        bls_app_registerEventCallback(BLT_EV_FLAG_ADV_DURATION_TIMEOUT, &app_switch_to_undirected_adv);
    }
    else  // set undirected adv
#endif
    {
        adv_param_status = bls_ll_setAdvParam(MY_ADV_INTERVAL_MIN, MY_ADV_INTERVAL_MAX, ADV_TYPE_CONNECTABLE_UNDIRECTED, app_own_address_type, 0, NULL, MY_APP_ADV_CHANNEL, ADV_FP_NONE);
    }
    if (adv_param_status != BLE_SUCCESS)
    {
        LOG_D("[APP][INI] ADV parameters error 0x%x!!!", adv_param_status);
    }
    bls_ll_setAdvData((u8 *)tbl_advData, sizeof(tbl_advData));
    unsigned int flash_mid;
    int          flag = flash_read_mid_uid_with_check(&flash_mid, g_flash_uid);
    for (int i = 0; i < 16; i++)
    {
        tbl_scanRsp[12 + i] = g_flash_uid[i];
    }
    if (flag == 0)
    {  // reading flash UID error
        LOG_D("[APP][INI] reading flash UID error");
    }
    bls_ll_setScanRspData((u8 *)tbl_scanRsp, sizeof(tbl_scanRsp));
    /* 广播不再在此处无条件打开：
     * 需等 MCU 与 AI SOC 串口通信建立成功后才开启广播（见 app_adv_gate_check()），
     * 最长等待 SOC_LINK_WAIT_TIMEOUT_US(15s)，超时判定硬件故障并重启设备 */
// scan setting
#if (SCAN_ENABLE)
    blc_hci_le_setEventMask_cmd(HCI_LE_EVT_MASK_ADVERTISING_REPORT);
    blc_hci_registerControllerEventHandler(controller_event_callback);
#endif
    /* set rf power index, user must set it after every suspend wakeup, cause relative setting will be reset in suspend */
    rf_set_power_level_index(MY_RF_POWER_INDEX);
#if (SCAN_ENABLE)
    // add scanning in adv and connection slave role
    blt_ll_initScanState();
    blc_ll_addScanningInAdvState();       // add scan in adv state
    blc_ll_addScanningInConnSlaveRole();  // add scan in conn slave role
#endif
    bls_app_registerEventCallback(BLT_EV_FLAG_CONNECT, &task_connect);
    bls_app_registerEventCallback(BLT_EV_FLAG_TERMINATE, &task_terminate);
    bls_app_registerEventCallback(BLT_EV_FLAG_SUSPEND_EXIT, &task_suspend_exit);
///////////////////// Power Management initialization///////////////////
#if (BLE_APP_PM_ENABLE)
#if (SAVE_RAM_CODE_ENABLE)
    blc_ll_initPowerManagement_module_save_ram();  // pm module:      	 optional
#else
    blc_ll_initPowerManagement_module();  // pm module:      	 optional
#endif
#if (PM_DEEPSLEEP_RETENTION_ENABLE)
#if (!SAVE_RAM_CODE_ENABLE)
    blc_ll_initDeepsleepRetention_module();  // Remove it if need save ramcode, and add DeepsleepRetentionEarlyWakeupTiming.
                                             // Note:The user needs to DeepsleepRetentionEarlyWakeupTiming according to the timing from boot to the end of the user_init_deepRetn.Refer to handbook for details.
#endif
    bls_pm_setSuspendMask(SUSPEND_ADV | DEEPSLEEP_RETENTION_ADV | SUSPEND_CONN | DEEPSLEEP_RETENTION_CONN);
    blc_pm_setDeepsleepRetentionThreshold(95, 95);
#if (MCU_CORE_B80)
    blc_pm_setDeepsleepRetentionEarlyWakeupTiming(650);
#elif (MCU_CORE_B80B)
    blc_pm_setDeepsleepRetentionEarlyWakeupTiming(550);
#endif
#else
    bls_pm_setSuspendMask(SUSPEND_DISABLE);
#endif
    bls_app_registerEventCallback(BLT_EV_FLAG_SUSPEND_ENTER, &task_sleep_enter);
#else
    bls_pm_setSuspendMask(SUSPEND_DISABLE);
#endif
#if (UI_KEYBOARD_ENABLE)
    /////////// keyboard gpio wakeup init ////////
    u32 pin[] = KB_DRIVE_PINS;
    for (int i = 0; i < (sizeof(pin) / sizeof(*pin)); i++)
    {
        cpu_set_gpio_wakeup(pin[i], Level_High, 1);  // drive pin pad high wakeup deepsleep
    }
    bls_app_registerEventCallback(BLT_EV_FLAG_GPIO_EARLY_WAKEUP, &proc_keyboard);
#endif
    ////////////////////////////////////////////////////////////////////////////////////////////////

    /* Check if any Stack(Controller & Host) Initialization error after all BLE initialization done.
     * attention that code will stuck in "while(1)" if any error detected in initialization, user need find what error happens and then fix it */
    blc_app_checkControllerHostInitialization();
    advertise_begin_tick = clock_time();

    app_ultrasonic_init();
    app_input_init();
    app_adc_mon_init();
}

#if (PM_DEEPSLEEP_RETENTION_ENABLE)
/**
 * @brief		user initialization when MCU wake_up from deepSleep_retention mode
 * @param[in]	none
 * @return      none
 */
_attribute_ram_code_ void user_init_deepRetn(void)
{
    blc_app_loadCustomizedParameters_deepRetn();
    //////////// LinkLayer Initialization  Begin /////////////////////////
    blc_ll_initBasicMCU();  // mandatory
    //////////////////////////// User Configuration for BLE application ////////////////////////////
    /* set rf power index, user must set it after every suspend wakeup, cause relative setting will be reset in suspend */
    rf_set_power_level_index(MY_RF_POWER_INDEX);
    blc_ll_recoverDeepRetention();
    irq_enable();
#if (UI_KEYBOARD_ENABLE)
    /////////// keyboard GPIO wake_up initialization ////////
    u32 pin[] = KB_DRIVE_PINS;
    for (int i = 0; i < (sizeof(pin) / sizeof(*pin)); i++)
    {
        cpu_set_gpio_wakeup(pin[i], Level_High, 1);  // drive pin high level wake_up deepsleep
    }
#endif
    ////////////////////////////////////////////////////////////////////////////////////////////////
}
#endif
#if (APP_FLASH_PROTECTION_ENABLE)
/**
 * @brief      flash protection operation, including all locking & unlocking for application
 * 			   handle all flash write & erase action for this demo code. use should add more more if they have more flash operation.
 * @param[in]  flash_op_evt - flash operation event, including application layer action and stack layer action event(OTA write & erase)
 * 			   attention 1: if you have more flash write or erase action, you should should add more type and process them
 * 			   attention 2: for "end" event, no need to pay attention on op_addr_begin & op_addr_end, we set them to 0 for
 * 			   			    stack event, such as stack OTA write new firmware end event
 * @param[in]  op_addr_begin - operating flash address range begin value
 * @param[in]  op_addr_end - operating flash address range end value
 * 			   attention that, we use: [op_addr_begin, op_addr_end)
 * 			   e.g. if we write flash sector from 0x10000 to 0x20000, actual operating flash address is 0x10000 ~ 0x1FFFF
 * 			   		but we use [0x10000, 0x20000):  op_addr_begin = 0x10000, op_addr_end = 0x20000
 * @return     none
 */
_attribute_data_retention_ u16 flash_lockBlock_cmd = 0;
void                           app_flash_protection_operation(u8 flash_op_evt, u32 op_addr_begin, u32 op_addr_end)
{
    if (flash_op_evt == FLASH_OP_EVT_APP_INITIALIZATION)
    {
        /* ignore "op addr_begin" and "op addr_end" for initialization event
         * must call "flash protection_init" first, will choose correct flash protection relative API according to current internal flash type in MCU */
        flash_protection_init();
        /* just sample code here, protect all flash area for old firmware and OTA new firmware.
         * user can change this design if have other consideration */
        u32 app_lockBlock = 0xffffffff;
#if (BLE_OTA_SERVER_ENABLE)
        u32 multiBootAddress = blc_ota_getCurrentUsedMultipleBootAddress();
        if (multiBootAddress == MULTI_BOOT_ADDR_0x10000)
        {
            app_lockBlock = FLASH_LOCK_FW_LOW_128K;
        }
        else if (multiBootAddress == MULTI_BOOT_ADDR_0x20000)
        {
            app_lockBlock = FLASH_LOCK_FW_LOW_256K;
        }
        else if (multiBootAddress == MULTI_BOOT_ADDR_0x40000)
        {
            /* attention that 512K capacity flash can not lock all 512K area, should leave some upper sector
             * for system data(SMP storage data & calibration data & MAC address) and user data
             * will use a approximate value */
            app_lockBlock = FLASH_LOCK_FW_LOW_512K;
        }
#else
        app_lockBlock = FLASH_LOCK_FW_LOW_256K;  // just demo value, user can change this value according to application
#endif
        flash_lockBlock_cmd = flash_change_app_lock_block_to_flash_lock_block(app_lockBlock);
        if (blc_flashProt.init_err)
        {
            LOG_D("[FLASH][PROT] flash protection initialization error!!!");
        }
        LOG_D("[FLASH][PROT] initialization, lock flash");
        flash_lock(flash_lockBlock_cmd);
    }
#if (BLE_OTA_SERVER_ENABLE)
    else if (flash_op_evt == FLASH_OP_EVT_STACK_OTA_CLEAR_OLD_FW_BEGIN)
    {
        /* OTA clear old firmware begin event is triggered by stack, in "blc ota_initOtaServer_module", rebooting from a successful OTA.
         * Software will erase whole old firmware for potential next new OTA, need unlock flash if any part of flash address from
         * "op addr_begin" to "op addr_end" is in locking block area.
         * In this sample code, we protect whole flash area for old and new firmware, so here we do not need judge "op addr_begin" and "op addr_end",
         * must unlock flash */
        LOG_D("[FLASH][PROT] OTA clear old FW begin, unlock flash");
        flash_unlock();
    }
    else if (flash_op_evt == FLASH_OP_EVT_STACK_OTA_CLEAR_OLD_FW_END)
    {
        /* ignore "op addr_begin" and "op addr_end" for END event
         * OTA clear old firmware end event is triggered by stack, in "blc ota_initOtaServer_module", erasing old firmware data finished.
         * In this sample code, we need lock flash again, because we have unlocked it at the begin event of clear old firmware */
        LOG_D("[FLASH][PROT] OTA clear old FW end, restore flash locking");
        flash_lock(flash_lockBlock_cmd);
    }
    else if (flash_op_evt == FLASH_OP_EVT_STACK_OTA_WRITE_NEW_FW_BEGIN)
    {
        /* OTA write new firmware begin event is triggered by stack, when receive first OTA data PDU.
         * Software will write data to flash on new firmware area,  need unlock flash if any part of flash address from
         * "op addr_begin" to "op addr_end" is in locking block area.
         * In this sample code, we protect whole flash area for old and new firmware, so here we do not need judge "op addr_begin" and "op addr_end",
         * must unlock flash */
        LOG_D("[FLASH][PROT] OTA write new FW begin, unlock flash");
        flash_unlock();
    }
    else if (flash_op_evt == FLASH_OP_EVT_STACK_OTA_WRITE_NEW_FW_END)
    {
        /* ignore "op addr_begin" and "op addr_end" for END event
         * OTA write new firmware end event is triggered by stack, after OTA end or an OTA error happens, writing new firmware data finished.
         * In this sample code, we need lock flash again, because we have unlocked it at the begin event of write new firmware */
        LOG_D("[FLASH][PROT] OTA write new FW end, restore flash locking");
        flash_lock(flash_lockBlock_cmd);
    }
#endif
    /* add more flash protection operation for your application if needed */
}
#endif
/**
 * @brief      BLE 广播开启门控（在 main_loop 中周期调用）
 * @note       广播不随初始化立即打开，而是等到 MCU 与 AI SOC 串口通信建立成功
 *             （以收到 SOC 心跳、app_ctrl_is_soc_online()==1 为准）后才打开。
 *             若 SOC_LINK_WAIT_TIMEOUT_US(15s) 内未能建立通信，判定硬件故障，
 *             直接重启设备。
 */
static void app_adv_gate_check(void)
{
    if (g_adv_enabled)
    {
        return;
    }

    if (app_ctrl_is_soc_online())
    {
        /* MCU 与 SOC 串口通信正常，打开广播 */
        bls_ll_setAdvEnable(BLC_ADV_ENABLE);
        g_adv_enabled = 1;
        LOG_D("[APP][ADV] SOC handshake OK, ADV enable");
    }
    else if (clock_time_exceed(advertise_begin_tick, SOC_LINK_WAIT_TIMEOUT_US))
    {
        /* 15s 内未建立 MCU 与 SOC 串口通信，判定硬件故障，重启设备 */
        LOG_D("[APP][ADV] SOC handshake timeout(>15s), hardware fault, reboot!");
        sleep_us(100000);  // 预留时间让日志通过 UART 输出
        start_reboot();
        while (1)
        {
            /* start_reboot() 不应返回，防御性死循环 */
        }
    }
}
_attribute_data_retention_ static u8 s_bat_percent_last_reported = 0xFF;
/**
 * @brief     BLE main loop
 * @param[in]  none.
 * @return     none.
 */
void main_loop(void)
{
    ////////////////////////////////////// BLE entry /////////////////////////////////
    blc_sdk_main_loop();

    u8 bat_percent_now = app_adc_mon_get_bat_percent_exact();
    {
        if (bat_percent_now != s_bat_percent_last_reported)
        {
            s_bat_percent_last_reported = bat_percent_now;
            // BLE_LOG_D("bat: %d", bat_percent_now);
            app_att_battery_update(bat_percent_now);
        }
    }

    app_uart_task();
    app_ctrl_time_task();

    /* 广播门控：SOC 串口通信建立成功后开启广播，15s 超时则重启 */
    app_adv_gate_check();

    app_input_poll();
    app_adc_mon_poll();

#if (UI_LED_ENABLE)
    app_ui_led_task();
#endif
    // ////////////////////////////////////// PM Process /////////////////////////////////
    blt_pm_proc();
}
