wdxm657/ble_egg_anfu/app_att.c

/********************************************************************************************************
 * @file    app_att.c
 *
 * @brief   This is the source file for BLE SDK
 *
 * @author  BLE GROUP
 * @date    12,2021
 *
 * @par     Copyright (c) 2021, Telink Semiconductor (Shanghai) Co., Ltd. ("TELINK")
 *
 *          Licensed under the Apache License, Version 2.0 (the "License");
 *          you may not use this file except in compliance with the License.
 *          You may obtain a copy of the License at
 *
 *              http://www.apache.org/licenses/LICENSE-2.0
 *
 *          Unless required by applicable law or agreed to in writing, software
 *          distributed under the License is distributed on an "AS IS" BASIS,
 *          WITHOUT WARRANTIES OR CONDITIONS OF ANY KIND, either express or implied.
 *          See the License for the specific language governing permissions and
 *          limitations under the License.
 *
 *******************************************************************************************************/
#include "tl_common.h"
#include "stack/ble/ble.h"
#include "stack/ble/host/attr/att.h"

#include "app.h"
#include "app_att.h"
#include "app_ctrl.h"

/**
 *  @brief  connect parameters structure for ATT
 */
typedef struct
{
  /** Minimum value for the connection event (interval. 0x0006 - 0x0C80 * 1.25 ms) */
  u16 intervalMin;
  /** Maximum value for the connection event (interval. 0x0006 - 0x0C80 * 1.25 ms) */
  u16 intervalMax;
  /** Number of LL latency connection events (0x0000 - 0x03e8) */
  u16 latency;
  /** Connection Timeout (0x000A - 0x0C80 * 10 ms) */
  u16 timeout;
} gap_periConnectParams_t;

static const u16 clientCharacterCfgUUID = GATT_UUID_CLIENT_CHAR_CFG;

static const u16 extReportRefUUID = GATT_UUID_EXT_REPORT_REF;

static const u16 reportRefUUID = GATT_UUID_REPORT_REF;

static const u16 characterPresentFormatUUID = GATT_UUID_CHAR_PRESENT_FORMAT;

static const u16 userdesc_UUID	= GATT_UUID_CHAR_USER_DESC;

static const u16 serviceChangeUUID = GATT_UUID_SERVICE_CHANGE;

static const u16 my_primaryServiceUUID = GATT_UUID_PRIMARY_SERVICE;

static const u16 my_characterUUID = GATT_UUID_CHARACTER;

static const u16 my_devServiceUUID = SERVICE_UUID_DEVICE_INFORMATION;

static const u16 my_PnPUUID = CHARACTERISTIC_UUID_PNP_ID;

static const u16 my_devNameUUID = GATT_UUID_DEVICE_NAME;

static const u16 my_gapServiceUUID = SERVICE_UUID_GENERIC_ACCESS;

static const u16 my_appearanceUUID = GATT_UUID_APPEARANCE;

static const u16 my_periConnParamUUID = GATT_UUID_PERI_CONN_PARAM;

static const u16 my_appearance = GAP_APPEAR_UNKNOWN;

static const u16 my_gattServiceUUID = SERVICE_UUID_GENERIC_ATTRIBUTE;

static const gap_periConnectParams_t my_periConnParameters = {20, 40, 0, 1000};

static u16 serviceChangeVal[2] = {0};

static u8 serviceChangeCCC[2] = {0,0};

static const u8 my_devName[] = {'W','2','M','C','B','E','g','g'};

static const u8 my_PnPtrs [] = {0x02, 0x8a, 0x24, 0x66, 0x82, 0x01, 0x00};

//////////////////////// Battery /////////////////////////////////////////////////
static const u16 my_batServiceUUID        = SERVICE_UUID_BATTERY;
static const u16 my_batCharUUID       	  = CHARACTERISTIC_UUID_BATTERY_LEVEL;
static u8 batteryValueInCCC[2];
static u8 my_batVal[1] 	= {99};

//////////////////////// HID /////////////////////////////////////////////////////
static const u16 my_hidServiceUUID        = SERVICE_UUID_HUMAN_INTERFACE_DEVICE;
static const u16 hidServiceUUID           = SERVICE_UUID_HUMAN_INTERFACE_DEVICE;
static const u16 hidProtocolModeUUID      = CHARACTERISTIC_UUID_HID_PROTOCOL_MODE;
static const u16 hidReportUUID            = CHARACTERISTIC_UUID_HID_REPORT;
static const u16 hidReportMapUUID         = CHARACTERISTIC_UUID_HID_REPORT_MAP;
static const u16 hidbootKeyInReportUUID   = CHARACTERISTIC_UUID_HID_BOOT_KEY_INPUT;
static const u16 hidbootKeyOutReportUUID  = CHARACTERISTIC_UUID_HID_BOOT_KEY_OUTPUT;
static const u16 hidinformationUUID       = CHARACTERISTIC_UUID_HID_INFORMATION;
static const u16 hidCtrlPointUUID         = CHARACTERISTIC_UUID_HID_CONTROL_POINT;
static const u16 hidIncludeUUID           = GATT_UUID_INCLUDE;
static u8 protocolMode 			  = DFLT_HID_PROTOCOL_MODE;

// Key in Report characteristic variables
static u8 reportKeyIn[8];
static u8 reportKeyInCCC[2];
// HID Report Reference characteristic descriptor, key input
static u8 reportRefKeyIn[2] =
             { HID_REPORT_ID_KEYBOARD_INPUT, HID_REPORT_TYPE_INPUT };

// Key out Report characteristic variables
static u8 reportKeyOut[1];
static u8 reportRefKeyOut[2] =
             { HID_REPORT_ID_KEYBOARD_INPUT, HID_REPORT_TYPE_OUTPUT };

// Consumer Control input Report
static u8 reportConsumerControlIn[2];
static u8 reportConsumerControlInCCC[2];
static u8 reportRefConsumerControlIn[2] =
			 { HID_REPORT_ID_CONSUME_CONTROL_INPUT, HID_REPORT_TYPE_INPUT };

// Boot Keyboard Input Report
static u8 bootKeyInReport;
static u8 bootKeyInReportCCC[2];

// Boot Keyboard Output Report
static u8 bootKeyOutReport;

// HID Information characteristic
static const u8 hidInformation[] =
{
  U16_LO(0x0111), U16_HI(0x0111),             // bcdHID (USB HID version)
  0x00,                                       // bCountryCode
  0x01                                        // Flags
};

// HID Control Point characteristic
static u8 controlPoint;

// HID Report Map characteristic
// Keyboard report descriptor (using format for Boot interface descriptor)

static const u8 reportMap[] =
{
	//keyboard report in
	0x05, 0x01,     // Usage Pg (Generic Desktop)
	0x09, 0x06,     // Usage (Keyboard)
	0xA1, 0x01,     // Collection: (Application)
	0x85, HID_REPORT_ID_KEYBOARD_INPUT,     // Report Id (keyboard)
				  //
	0x05, 0x07,     // Usage Pg (Key Codes)
	0x19, 0xE0,     // Usage Min (224)  VK_CTRL:0xe0
	0x29, 0xE7,     // Usage Max (231)  VK_RWIN:0xe7
	0x15, 0x00,     // Log Min (0)
	0x25, 0x01,     // Log Max (1)
				  //
				  // Modifier byte
	0x75, 0x01,     // Report Size (1)   1 bit * 8
	0x95, 0x08,     // Report Count (8)
	0x81, 0x02,     // Input: (Data, Variable, Absolute)
				  //
				  // Reserved byte
	0x95, 0x01,     // Report Count (1)
	0x75, 0x08,     // Report Size (8)
	0x81, 0x01,     // Input: (static constant)

	//keyboard output
	//5 bit led ctrl: NumLock CapsLock ScrollLock Compose kana
	0x95, 0x05,    //Report Count (5)
	0x75, 0x01,    //Report Size (1)
	0x05, 0x08,    //Usage Pg (LEDs )
	0x19, 0x01,    //Usage Min
	0x29, 0x05,    //Usage Max
	0x91, 0x02,    //Output (Data, Variable, Absolute)
	//3 bit reserved
	0x95, 0x01,    //Report Count (1)
	0x75, 0x03,    //Report Size (3)
	0x91, 0x01,    //Output (static constant)

	// Key arrays (6 bytes)
	0x95, 0x06,     // Report Count (6)
	0x75, 0x08,     // Report Size (8)
	0x15, 0x00,     // Log Min (0)
	0x25, 0xF1,     // Log Max (241)
	0x05, 0x07,     // Usage Pg (Key Codes)
	0x19, 0x00,     // Usage Min (0)
	0x29, 0xf1,     // Usage Max (241)
	0x81, 0x00,     // Input: (Data, Array)

	0xC0,            // End Collection

	//consumer report in
	0x05, 0x0C,   // Usage Page (Consumer)
	0x09, 0x01,   // Usage (Consumer Control)
	0xA1, 0x01,   // Collection (Application)
	0x85, HID_REPORT_ID_CONSUME_CONTROL_INPUT,   //     Report Id
	0x75,0x10,     //global, report size 16 bits
	0x95,0x01,     //global, report count 1
	0x15,0x01,     //global, min  0x01
	0x26,0x8c,0x02,  //global, max  0x28c
	0x19,0x01,     //local, min   0x01
	0x2a,0x8c,0x02,  //local, max    0x28c
	0x81,0x00,     //main,  input data variable, absolute
	0xc0,        //main, end collection
};

// HID External Report Reference Descriptor for report map
static u16 extServiceUUID;

#if (BLE_OTA_SERVER_ENABLE)
/////////////////////////////////////////////////////////
static const  u8 my_OtaServiceUUID[16]				= WRAPPING_BRACES(TELINK_OTA_UUID_SERVICE);
static const  u8 my_OtaUUID[16]						= WRAPPING_BRACES(TELINK_SPP_DATA_OTA);
static u8 my_OtaData 						        = 0x00;

static const u8  my_OtaName[] = {'O', 'T', 'A'};
#endif

//////////////////////// Custom Control Service /////////////////////////////////////////////////
// Custom Service UUID: 128-bit UUID
#define CUSTOM_CTRL_SERVICE_UUID   			0x00,0xa0,0x0d,0x0c,0x0b,0x0a,0x09,0x08,0x07,0x06,0x05,0x04,0x03,0x02,0x01,0x00
// Custom RX Characteristic UUID (APP -> Device)
#define CUSTOM_CTRL_RX_CHAR_UUID   		0x01,0xa0,0x0d,0x0c,0x0b,0x0a,0x09,0x08,0x07,0x06,0x05,0x04,0x03,0x02,0x01,0x00
// Custom TX Characteristic UUID (Device -> APP)
#define CUSTOM_CTRL_TX_CHAR_UUID   		0x02,0xa0,0x0d,0x0c,0x0b,0x0a,0x09,0x08,0x07,0x06,0x05,0x04,0x03,0x02,0x01,0x00
// Custom Log TX Characteristic UUID (Device -> APP, 独立日志通道)
#define CUSTOM_CTRL_LOG_CHAR_UUID   	0x03,0xa0,0x0d,0x0c,0x0b,0x0a,0x09,0x08,0x07,0x06,0x05,0x04,0x03,0x02,0x01,0x00

static const u8 my_CustomCtrlServiceUUID[16]	= WRAPPING_BRACES(CUSTOM_CTRL_SERVICE_UUID);
static const u8 my_CustomCtrlRxUUID[16]	        = WRAPPING_BRACES(CUSTOM_CTRL_RX_CHAR_UUID);
static const u8 my_CustomCtrlTxUUID[16]	        = WRAPPING_BRACES(CUSTOM_CTRL_TX_CHAR_UUID);
static const u8 my_CustomCtrlLogUUID[16]	    = WRAPPING_BRACES(CUSTOM_CTRL_LOG_CHAR_UUID);

static u8 customCtrlTxCCC[2] = {0, 0};  // Client Characteristic Configuration for TX notify
u8 customCtrlLogCCC[2] = {0, 0}; // Client Characteristic Configuration for Log TX notify
static u8 customCtrlLogVal[1] = {0};    // Log TX value buffer
static const u8 my_CustomCtrlLogName[] = {'L','o','g',' ','T','X'};

// User Description strings for characteristics
static const u8 my_CustomCtrlRxName[] = {'C','t','r','l',' ','R','X'};
static const u8 my_CustomCtrlTxName[] = {'C','t','r','l',' ','T','X'};


// Include attribute (Battery service)
static const u16 include[3] = {BATT_PS_H, BATT_LEVEL_INPUT_CCB_H, SERVICE_UUID_BATTERY};

//// GAP attribute values
static const u8 my_devNameCharVal[5] = {
	CHAR_PROP_READ,
	U16_LO(GenericAccess_DeviceName_DP_H), U16_HI(GenericAccess_DeviceName_DP_H),
	U16_LO(GATT_UUID_DEVICE_NAME), U16_HI(GATT_UUID_DEVICE_NAME)
};

static const u8 my_appearanceCharVal[5] = {
	CHAR_PROP_READ,
	U16_LO(GenericAccess_Appearance_DP_H), U16_HI(GenericAccess_Appearance_DP_H),
	U16_LO(GATT_UUID_APPEARANCE), U16_HI(GATT_UUID_APPEARANCE)
};

static const u8 my_periConnParamCharVal[5] = {
	CHAR_PROP_READ,
	U16_LO(CONN_PARAM_DP_H), U16_HI(CONN_PARAM_DP_H),
	U16_LO(GATT_UUID_PERI_CONN_PARAM), U16_HI(GATT_UUID_PERI_CONN_PARAM)
};

//// GATT attribute values
static const u8 my_serviceChangeCharVal[5] = {
	CHAR_PROP_INDICATE,
	U16_LO(GenericAttribute_ServiceChanged_DP_H), U16_HI(GenericAttribute_ServiceChanged_DP_H),
	U16_LO(GATT_UUID_SERVICE_CHANGE), U16_HI(GATT_UUID_SERVICE_CHANGE)
};

//// device Information  attribute values
static const u8 my_PnCharVal[5] = {
	CHAR_PROP_READ,
	U16_LO(DeviceInformation_pnpID_DP_H), U16_HI(DeviceInformation_pnpID_DP_H),
	U16_LO(CHARACTERISTIC_UUID_PNP_ID), U16_HI(CHARACTERISTIC_UUID_PNP_ID)
};

#if (BLE_HID_SERVER_ENABLE)
//// HID attribute values
static const u8 my_hidProtocolModeCharVal[5] = {
	CHAR_PROP_READ | CHAR_PROP_WRITE_WITHOUT_RSP,
	U16_LO(HID_PROTOCOL_MODE_DP_H), U16_HI(HID_PROTOCOL_MODE_DP_H),
	U16_LO(CHARACTERISTIC_UUID_HID_PROTOCOL_MODE), U16_HI(CHARACTERISTIC_UUID_HID_PROTOCOL_MODE)
};

static const u8 my_hidbootKeyInReportCharVal[5] = {
	CHAR_PROP_READ | CHAR_PROP_NOTIFY,
	U16_LO(HID_BOOT_KB_REPORT_INPUT_DP_H), U16_HI(HID_BOOT_KB_REPORT_INPUT_DP_H),
	U16_LO(CHARACTERISTIC_UUID_HID_BOOT_KEY_INPUT), U16_HI(CHARACTERISTIC_UUID_HID_BOOT_KEY_INPUT)
};

static const u8 my_hidbootKeyOutReportCharVal[5] = {
	CHAR_PROP_READ | CHAR_PROP_WRITE | CHAR_PROP_WRITE_WITHOUT_RSP,
	U16_LO(HID_BOOT_KB_REPORT_OUTPUT_DP_H), U16_HI(HID_BOOT_KB_REPORT_OUTPUT_DP_H),
	U16_LO(CHARACTERISTIC_UUID_HID_BOOT_KEY_OUTPUT), U16_HI(CHARACTERISTIC_UUID_HID_BOOT_KEY_OUTPUT)
};

static const u8 my_hidReportCCinCharVal[5] = {
	CHAR_PROP_READ | CHAR_PROP_NOTIFY,
	U16_LO(HID_CONSUME_REPORT_INPUT_DP_H), U16_HI(HID_CONSUME_REPORT_INPUT_DP_H),
	U16_LO(CHARACTERISTIC_UUID_HID_REPORT), U16_HI(CHARACTERISTIC_UUID_HID_REPORT)
};

static const u8 my_hidReportKEYinCharVal[5] = {
	CHAR_PROP_READ | CHAR_PROP_NOTIFY,
	U16_LO(HID_NORMAL_KB_REPORT_INPUT_DP_H), U16_HI(HID_NORMAL_KB_REPORT_INPUT_DP_H),
	U16_LO(CHARACTERISTIC_UUID_HID_REPORT), U16_HI(CHARACTERISTIC_UUID_HID_REPORT)
};

static const u8 my_hidReportKEYoutCharVal[5] = {
	CHAR_PROP_READ | CHAR_PROP_WRITE | CHAR_PROP_WRITE_WITHOUT_RSP,
	U16_LO(HID_NORMAL_KB_REPORT_OUTPUT_DP_H), U16_HI(HID_NORMAL_KB_REPORT_OUTPUT_DP_H),
	U16_LO(CHARACTERISTIC_UUID_HID_REPORT), U16_HI(CHARACTERISTIC_UUID_HID_REPORT)
};

static const u8 my_hidReportMapCharVal[5] = {
	CHAR_PROP_READ,
	U16_LO(HID_REPORT_MAP_DP_H), U16_HI(HID_REPORT_MAP_DP_H),
	U16_LO(CHARACTERISTIC_UUID_HID_REPORT_MAP), U16_HI(CHARACTERISTIC_UUID_HID_REPORT_MAP)
};

static const u8 my_hidinformationCharVal[5] = {
	CHAR_PROP_READ,
	U16_LO(HID_INFORMATION_DP_H), U16_HI(HID_INFORMATION_DP_H),
	U16_LO(CHARACTERISTIC_UUID_HID_INFORMATION), U16_HI(CHARACTERISTIC_UUID_HID_INFORMATION)
};

static const u8 my_hidCtrlPointCharVal[5] = {
	CHAR_PROP_WRITE_WITHOUT_RSP,
	U16_LO(HID_CONTROL_POINT_DP_H), U16_HI(HID_CONTROL_POINT_DP_H),
	U16_LO(CHARACTERISTIC_UUID_HID_CONTROL_POINT), U16_HI(CHARACTERISTIC_UUID_HID_CONTROL_POINT)
};
#endif

//// Battery attribute values
static const u8 my_batCharVal[5] = {
	CHAR_PROP_READ | CHAR_PROP_NOTIFY,
	U16_LO(BATT_LEVEL_INPUT_DP_H), U16_HI(BATT_LEVEL_INPUT_DP_H),
	U16_LO(CHARACTERISTIC_UUID_BATTERY_LEVEL), U16_HI(CHARACTERISTIC_UUID_BATTERY_LEVEL)
};

//// Custom Control Service attribute values
static const u8 my_customCtrlRxCharVal[19] = {
	CHAR_PROP_READ | CHAR_PROP_WRITE | CHAR_PROP_WRITE_WITHOUT_RSP,
	U16_LO(CUSTOM_COUNTER_WRITE_DP_H), U16_HI(CUSTOM_COUNTER_WRITE_DP_H),
	CUSTOM_CTRL_RX_CHAR_UUID,
};

static const u8 my_customCtrlTxCharVal[19] = {
	CHAR_PROP_READ | CHAR_PROP_NOTIFY,
	U16_LO(CUSTOM_COUNTER_READ_DP_H), U16_HI(CUSTOM_COUNTER_READ_DP_H),
	CUSTOM_CTRL_TX_CHAR_UUID,
};

static const u8 my_customCtrlLogCharVal[19] = {
	CHAR_PROP_READ | CHAR_PROP_NOTIFY,
	U16_LO(CUSTOM_COUNTER_LOG_DP_H), U16_HI(CUSTOM_COUNTER_LOG_DP_H),
	CUSTOM_CTRL_LOG_CHAR_UUID,
};

#if (BLE_OTA_SERVER_ENABLE)
//// OTA attribute values
static const u8 my_OtaCharVal[19] = {
	CHAR_PROP_READ | CHAR_PROP_WRITE_WITHOUT_RSP,
	U16_LO(OTA_CMD_OUT_DP_H), U16_HI(OTA_CMD_OUT_DP_H),
	TELINK_SPP_DATA_OTA,
};
#endif

/**
 * @brief      Write callback function for custom control RX characteristic
 * @param[in]  p - GATT data buffer pointer of write_req or write_cmd
 * @return     0: success, other: fail
 */
int customCounterWrite(void * p)
{
	rf_packet_att_write_t * pw = (rf_packet_att_write_t *)p;

	if(pw->handle != CUSTOM_COUNTER_WRITE_DP_H){
		return 0;
	}

	// ATT Write PDU: opcode(1) + handle(2) + value...
	u16 attValLen = pw->l2capLen > 3 ? (pw->l2capLen - 3) : 0;
	if(attValLen > CTRL_RX_MAX_LEN){
		attValLen = CTRL_RX_MAX_LEN;
	}

	u8 *value_data = &(pw->value);  // first byte of value

	if(attValLen){
		memcpy(g_ctrlRxBuf, value_data, attValLen);
		app_ctrl_onRx(g_ctrlRxBuf, attValLen);
	}

	return 0;
}


// TM : to modify
static const attribute_t my_Attributes[] = {

	{ATT_END_H - 1, 0,0,0,0,0},	// total num of attribute


	// 0001 - 0007  gap
	{7,ATT_PERMISSIONS_READ,2,2,(u8*)(&my_primaryServiceUUID), 	(u8*)(&my_gapServiceUUID), 0},
	{0,ATT_PERMISSIONS_READ,2,sizeof(my_devNameCharVal),(u8*)(&my_characterUUID), (u8*)(my_devNameCharVal), 0},
	{0,ATT_PERMISSIONS_READ,2,sizeof(my_devName), (u8*)(&my_devNameUUID), (u8*)(my_devName), 0},
	{0,ATT_PERMISSIONS_READ,2,sizeof(my_appearanceCharVal),(u8*)(&my_characterUUID), (u8*)(my_appearanceCharVal), 0},
	{0,ATT_PERMISSIONS_READ,2,sizeof (my_appearance), (u8*)(&my_appearanceUUID), 	(u8*)(&my_appearance), 0},
	{0,ATT_PERMISSIONS_READ,2,sizeof(my_periConnParamCharVal),(u8*)(&my_characterUUID), (u8*)(my_periConnParamCharVal), 0},
	{0,ATT_PERMISSIONS_READ,2,sizeof (my_periConnParameters),(u8*)(&my_periConnParamUUID), 	(u8*)(&my_periConnParameters), 0},


	// 0008 - 000b gatt
	{4,ATT_PERMISSIONS_READ,2,2,(u8*)(&my_primaryServiceUUID), 	(u8*)(&my_gattServiceUUID), 0},
	{0,ATT_PERMISSIONS_READ,2,sizeof(my_serviceChangeCharVal),(u8*)(&my_characterUUID), 		(u8*)(my_serviceChangeCharVal), 0},
	{0,ATT_PERMISSIONS_READ,2,sizeof (serviceChangeVal), (u8*)(&serviceChangeUUID), 	(u8*)(&serviceChangeVal), 0},
	{0,ATT_PERMISSIONS_RDWR,2,sizeof (serviceChangeCCC),(u8*)(&clientCharacterCfgUUID), (u8*)(serviceChangeCCC), 0},


	// 000c - 000e  device Information Service
	{3,ATT_PERMISSIONS_READ,2,2,(u8*)(&my_primaryServiceUUID), 	(u8*)(&my_devServiceUUID), 0},
	{0,ATT_PERMISSIONS_READ,2,sizeof(my_PnCharVal),(u8*)(&my_characterUUID), (u8*)(my_PnCharVal), 0},
	{0,ATT_PERMISSIONS_READ,2,sizeof (my_PnPtrs),(u8*)(&my_PnPUUID), (u8*)(my_PnPtrs), 0},


#if (BLE_HID_SERVER_ENABLE)
	/////////////////////////////////// 4. HID Service /////////////////////////////////////////////////////////
	// 000f
	//{27, ATT_PERMISSIONS_READ,2,2,(u8*)(&my_primaryServiceUUID), 	(u8*)(&my_hidServiceUUID), 0},
	{HID_CONTROL_POINT_DP_H - HID_PS_H + 1, ATT_PERMISSIONS_READ,2,2,(u8*)(&my_primaryServiceUUID), 	(u8*)(&my_hidServiceUUID), 0},

	// 0010  include battery service
	{0,ATT_PERMISSIONS_READ,2,sizeof(include),(u8*)(&hidIncludeUUID), 	(u8*)(include), 0},

	// 0011 - 0012  protocol mode
	{0,ATT_PERMISSIONS_READ,2,sizeof(my_hidProtocolModeCharVal),(u8*)(&my_characterUUID), (u8*)(my_hidProtocolModeCharVal), 0},				//prop
	{0,ATT_PERMISSIONS_RDWR,2, sizeof(protocolMode),(u8*)(&hidProtocolModeUUID), 	(u8*)(&protocolMode), 0},	//value

	// 0013 - 0015  boot keyboard input report (char-val-client)
	{0,ATT_PERMISSIONS_READ,2,sizeof(my_hidbootKeyInReportCharVal),(u8*)(&my_characterUUID), (u8*)(my_hidbootKeyInReportCharVal), 0},				//prop
	{0,ATT_PERMISSIONS_READ,2,sizeof(bootKeyInReport),(u8*)(&hidbootKeyInReportUUID), 	(u8*)(&bootKeyInReport), 0},	//value
	{0,ATT_PERMISSIONS_RDWR,2,sizeof(bootKeyInReportCCC),(u8*)(&clientCharacterCfgUUID), 	(u8*)(bootKeyInReportCCC), 0},	//value

	// 0016 - 0017   boot keyboard output report (char-val)
	{0,ATT_PERMISSIONS_READ,2,sizeof(my_hidbootKeyOutReportCharVal),(u8*)(&my_characterUUID), (u8*)(my_hidbootKeyOutReportCharVal), 0},				//prop
	{0,ATT_PERMISSIONS_RDWR,2, sizeof(bootKeyOutReport), (u8*)(&hidbootKeyOutReportUUID), 	(u8*)(&bootKeyOutReport), 0},	//value


	// 0018 - 001b. consume report in: 4 (char-val-client-ref)
	{0,ATT_PERMISSIONS_READ,2,sizeof(my_hidReportCCinCharVal),(u8*)(&my_characterUUID), (u8*)(my_hidReportCCinCharVal), 0},				//prop
	{0,ATT_PERMISSIONS_READ,2, sizeof(reportConsumerControlIn),(u8*)(&hidReportUUID), 	(u8*)(reportConsumerControlIn), 0},	//value
	{0,ATT_PERMISSIONS_RDWR,2,sizeof(reportConsumerControlInCCC),(u8*)(&clientCharacterCfgUUID), 	(u8*)(reportConsumerControlInCCC), 0},	//value
	{0,ATT_PERMISSIONS_RDWR,2,sizeof(reportRefConsumerControlIn),(u8*)(&reportRefUUID), 	(u8*)(reportRefConsumerControlIn), 0},	//value

	// 001c - 001f . keyboard report in : 4 (char-val-client-ref)
	{0,ATT_PERMISSIONS_READ,2,sizeof(my_hidReportKEYinCharVal),(u8*)(&my_characterUUID), (u8*)(my_hidReportKEYinCharVal), 0},				//prop
	{0,ATT_PERMISSIONS_READ,2, sizeof(reportKeyIn),(u8*)(&hidReportUUID), 	(u8*)(reportKeyIn), 0},	//value
	{0,ATT_PERMISSIONS_RDWR,2,sizeof(reportKeyInCCC),(u8*)(&clientCharacterCfgUUID), 	(u8*)(reportKeyInCCC), 0},	//value
	{0,ATT_PERMISSIONS_RDWR,2,sizeof(reportRefKeyIn),(u8*)(&reportRefUUID), 	(u8*)(reportRefKeyIn), 0},	//value

	// 0020 - 0022 . keyboard report out: 3 (char-val-ref)
	{0,ATT_PERMISSIONS_READ,2,sizeof(my_hidReportKEYoutCharVal),(u8*)(&my_characterUUID), (u8*)(my_hidReportKEYoutCharVal), 0},				//prop
	{0,ATT_PERMISSIONS_RDWR,2,sizeof(reportKeyOut),(u8*)(&hidReportUUID), 	(u8*)(reportKeyOut), 0},	//value
	{0,ATT_PERMISSIONS_RDWR,2,sizeof(reportRefKeyOut),(u8*)(&reportRefUUID), 	(u8*)(reportRefKeyOut), 0},	//value


	// 0023 - 0025 . report map: 3
	{0,ATT_PERMISSIONS_READ,2,sizeof(my_hidReportMapCharVal),(u8*)(&my_characterUUID), (u8*)(my_hidReportMapCharVal), 0},				//prop
	{0,ATT_PERMISSIONS_READ,2,sizeof(reportMap),(u8*)(&hidReportMapUUID), 	(u8*)(reportMap), 0},	//value
	{0,ATT_PERMISSIONS_RDWR,2,sizeof(extServiceUUID),(u8*)(&extReportRefUUID), 	(u8*)(&extServiceUUID), 0},	//value

	// 0026 - 0027 . hid information: 2
	{0,ATT_PERMISSIONS_READ,2,sizeof(my_hidinformationCharVal),(u8*)(&my_characterUUID), (u8*)(my_hidinformationCharVal), 0},				//prop
	{0,ATT_PERMISSIONS_READ,2, sizeof(hidInformation),(u8*)(&hidinformationUUID), 	(u8*)(hidInformation), 0},	//value

	// 0028 - 0029 . control point: 2
	{0,ATT_PERMISSIONS_READ,2,sizeof(my_hidCtrlPointCharVal),(u8*)(&my_characterUUID), (u8*)(my_hidCtrlPointCharVal), 0},				//prop
	{0,ATT_PERMISSIONS_WRITE,2, sizeof(controlPoint),(u8*)(&hidCtrlPointUUID), 	(u8*)(&controlPoint), 0},	//value
#endif
	////////////////////////////////////// Battery Service /////////////////////////////////////////////////////
	// 002a - 002d
	{4,ATT_PERMISSIONS_READ,2,2,(u8*)(&my_primaryServiceUUID), 	(u8*)(&my_batServiceUUID), 0},
	{0,ATT_PERMISSIONS_READ,2,sizeof(my_batCharVal),(u8*)(&my_characterUUID), (u8*)(my_batCharVal), 0},				//prop
	{0,ATT_PERMISSIONS_READ,2,sizeof(my_batVal),(u8*)(&my_batCharUUID), 	(u8*)(my_batVal), 0},	//value
	{0,ATT_PERMISSIONS_RDWR,2,sizeof(batteryValueInCCC),(u8*)(&clientCharacterCfgUUID), 	(u8*)(batteryValueInCCC), 0},	//value

	#if (BLE_OTA_SERVER_ENABLE)
	////////////////////////////////////// OTA /////////////////////////////////////////////////////
	// 002e - 0031
	{4,ATT_PERMISSIONS_READ, 2,16,(u8*)(&my_primaryServiceUUID), 	(u8*)(&my_OtaServiceUUID), 0},
	{0,ATT_PERMISSIONS_READ, 2, sizeof(my_OtaCharVal),(u8*)(&my_characterUUID), (u8*)(my_OtaCharVal), 0},				//prop
	{0,ATT_PERMISSIONS_RDWR,16,sizeof(my_OtaData),(u8*)(&my_OtaUUID),	(&my_OtaData), &otaWrite, NULL},			//value
	{0,ATT_PERMISSIONS_READ, 2,sizeof (my_OtaName),(u8*)(&userdesc_UUID), (u8*)(my_OtaName), 0},
	#endif

	////////////////////////////////////// Custom Control Service /////////////////////////////////////////////////////
	//  attributes: service, rx char prop, rx value, rx desc, tx char prop, tx value, tx CCC, tx desc
	{12,ATT_PERMISSIONS_READ, 2,16,(u8*)(&my_primaryServiceUUID), 	(u8*)(&my_CustomCtrlServiceUUID), 0},
	{0,ATT_PERMISSIONS_READ, 2, sizeof(my_customCtrlRxCharVal),(u8*)(&my_characterUUID), (u8*)(my_customCtrlRxCharVal), 0},				// RX char prop
	{0,ATT_PERMISSIONS_RDWR,16,CTRL_RX_MAX_LEN,(u8*)(&my_CustomCtrlRxUUID),	(u8*)(g_ctrlRxBuf), &customCounterWrite, NULL},			// RX char value
	{0,ATT_PERMISSIONS_READ, 2,sizeof (my_CustomCtrlRxName),(u8*)(&userdesc_UUID), (u8*)(my_CustomCtrlRxName), 0},	// RX user desc
	{0,ATT_PERMISSIONS_READ, 2, sizeof(my_customCtrlTxCharVal),(u8*)(&my_characterUUID), (u8*)(my_customCtrlTxCharVal), 0},				// TX char prop
	{0,ATT_PERMISSIONS_READ,16,CTRL_TX_MAX_LEN,(u8*)(&my_CustomCtrlTxUUID),	(u8*)(g_ctrlTxBuf), NULL, NULL},			// TX char value
	{0,ATT_PERMISSIONS_RDWR,2,sizeof(customCtrlTxCCC),(u8*)(&clientCharacterCfgUUID), 	(u8*)(customCtrlTxCCC), 0},	// TX CCC
	{0,ATT_PERMISSIONS_READ, 2,sizeof (my_CustomCtrlTxName),(u8*)(&userdesc_UUID), (u8*)(my_CustomCtrlTxName), 0},	// TX user desc
	{0,ATT_PERMISSIONS_READ, 2, sizeof(my_customCtrlLogCharVal),(u8*)(&my_characterUUID), (u8*)(my_customCtrlLogCharVal), 0},			// LOG char prop
	{0,ATT_PERMISSIONS_READ,16,sizeof(customCtrlLogVal),(u8*)(&my_CustomCtrlLogUUID), (u8*)(customCtrlLogVal), NULL, NULL},			// LOG char value
	{0,ATT_PERMISSIONS_RDWR,2,sizeof(customCtrlLogCCC),(u8*)(&clientCharacterCfgUUID), (u8*)(customCtrlLogCCC), 0},	// LOG CCC
	{0,ATT_PERMISSIONS_READ, 2,sizeof (my_CustomCtrlLogName),(u8*)(&userdesc_UUID), (u8*)(my_CustomCtrlLogName), 0},	// LOG user desc
};


/**
 * @brief      Initialize the attribute table
 * @param[in]  none
 * @return     none
 */
void	my_gatt_init (void)
{
	bls_att_setAttributeTable ((u8 *)my_Attributes);
}


void app_att_battery_update(u8 percent)
{
	if (percent > 100)
	{
		percent = 100;
	}

	if (my_batVal[0] == percent)
	{
		return;
	}

	my_batVal[0] = percent;

	/* CCC bit0=Notify enabled */
	if (BLS_CONN_HANDLE != 0xFFFF && (batteryValueInCCC[0] & 0x01))
	{
		blc_gatt_pushHandleValueNotify(BLS_CONN_HANDLE, BATT_LEVEL_INPUT_DP_H, my_batVal, sizeof(my_batVal));
	}
}
