wdxm657/ble_egg_anfu/app_att.h

/********************************************************************************************************
 * @file    app_att.h
 *
 * @brief   This is the header file for BLE SDK
 *
 * @author  BLE GROUP
 * @date    12,2021
 *
 * @par     Copyright (c) 2021, Telink Semiconductor (Shanghai) Co., Ltd. ("TELINK")
 *
 *          Licensed under the Apache License, Version 2.0 (the "License");
 *          you may not use this file except in compliance with the License.
 *          You may obtain a copy of the License at
 *
 *              http://www.apache.org/licenses/LICENSE-2.0
 *
 *          Unless required by applicable law or agreed to in writing, software
 *          distributed under the License is distributed on an "AS IS" BASIS,
 *          WITHOUT WARRANTIES OR CONDITIONS OF ANY KIND, either express or implied.
 *          See the License for the specific language governing permissions and
 *          limitations under the License.
 *
 *******************************************************************************************************/
#ifndef APP_ATT_H_
#define APP_ATT_H_






/* ATT Handle define ---------------------------------------------------------*/
typedef enum
{
	ATT_H_START = 0,


	//// Gap ////
	/**********************************************************************************************/
	GenericAccess_PS_H, 					//UUID: 2800, 	VALUE: uuid 1800
	GenericAccess_DeviceName_CD_H,			//UUID: 2803, 	VALUE:  			Prop: Read | Notify
	GenericAccess_DeviceName_DP_H,			//UUID: 2A00,   VALUE: device name
	GenericAccess_Appearance_CD_H,			//UUID: 2803, 	VALUE:  			Prop: Read
	GenericAccess_Appearance_DP_H,			//UUID: 2A01,	VALUE: appearance
	CONN_PARAM_CD_H,						//UUID: 2803, 	VALUE:  			Prop: Read
	CONN_PARAM_DP_H,						//UUID: 2A04,   VALUE: connParameter


	//// gatt ////
	/**********************************************************************************************/
	GenericAttribute_PS_H,					//UUID: 2800, 	VALUE: uuid 1801
	GenericAttribute_ServiceChanged_CD_H,	//UUID: 2803, 	VALUE:  			Prop: Indicate
	GenericAttribute_ServiceChanged_DP_H,   //UUID:	2A05,	VALUE: service change
	GenericAttribute_ServiceChanged_CCB_H,	//UUID: 2902,	VALUE: serviceChangeCCC


	//// device information ////
	/**********************************************************************************************/
	DeviceInformation_PS_H,					//UUID: 2800, 	VALUE: uuid 180A
	DeviceInformation_pnpID_CD_H,			//UUID: 2803, 	VALUE:  			Prop: Read
	DeviceInformation_pnpID_DP_H,			//UUID: 2A50,	VALUE: PnPtrs

#if (BLE_HID_SERVER_ENABLE)
	//// HID ////
	/**********************************************************************************************/
	HID_PS_H, 								//UUID: 2800, 	VALUE: uuid 1812

	//include
	HID_INCLUDE_H,							//UUID: 2802, 	VALUE: include

	//protocol
	HID_PROTOCOL_MODE_CD_H,					//UUID: 2803, 	VALUE:  			Prop: read | write_without_rsp
	HID_PROTOCOL_MODE_DP_H,					//UUID: 2A4E,	VALUE: protocolMode

	//boot keyboard input report
	HID_BOOT_KB_REPORT_INPUT_CD_H,			//UUID: 2803, 	VALUE:  			Prop: Read | Notify
	HID_BOOT_KB_REPORT_INPUT_DP_H,			//UUID: 2A22, 	VALUE: bootKeyInReport
	HID_BOOT_KB_REPORT_INPUT_CCB_H,			//UUID: 2902, 	VALUE: bootKeyInReportCCC

	//boot keyboard output report
	HID_BOOT_KB_REPORT_OUTPUT_CD_H,			//UUID: 2803, 	VALUE:  			Prop: Read | write| write_without_rsp
	HID_BOOT_KB_REPORT_OUTPUT_DP_H,			//UUID: 2A32, 	VALUE: bootKeyOutReport

	//consume report in
	HID_CONSUME_REPORT_INPUT_CD_H,			//UUID: 2803, 	VALUE:  			Prop: Read | Notify
	HID_CONSUME_REPORT_INPUT_DP_H,			//UUID: 2A4D, 	VALUE: reportConsumerIn
	HID_CONSUME_REPORT_INPUT_CCB_H,			//UUID: 2902, 	VALUE: reportConsumerInCCC
	HID_CONSUME_REPORT_INPUT_REF_H, 		//UUID: 2908    VALUE: REPORT_ID_CONSUMER, TYPE_INPUT

	//keyboard report in
	HID_NORMAL_KB_REPORT_INPUT_CD_H,		//UUID: 2803, 	VALUE:  			Prop: Read | Notify
	HID_NORMAL_KB_REPORT_INPUT_DP_H,		//UUID: 2A4D, 	VALUE: reportKeyIn
	HID_NORMAL_KB_REPORT_INPUT_CCB_H,		//UUID: 2902, 	VALUE: reportKeyInInCCC
	HID_NORMAL_KB_REPORT_INPUT_REF_H, 		//UUID: 2908    VALUE: REPORT_ID_KEYBOARD, TYPE_INPUT

	//keyboard report out
	HID_NORMAL_KB_REPORT_OUTPUT_CD_H,		//UUID: 2803, 	VALUE:  			Prop: Read | write| write_without_rsp
	HID_NORMAL_KB_REPORT_OUTPUT_DP_H,  		//UUID: 2A4D, 	VALUE: reportKeyOut
	HID_NORMAL_KB_REPORT_OUTPUT_REF_H, 		//UUID: 2908    VALUE: REPORT_ID_KEYBOARD, TYPE_OUTPUT

	// report map
	HID_REPORT_MAP_CD_H,					//UUID: 2803, 	VALUE:  			Prop: Read
	HID_REPORT_MAP_DP_H,					//UUID: 2A4B, 	VALUE: reportKeyIn
	HID_REPORT_MAP_EXT_REF_H,				//UUID: 2907 	VALUE: extService

	//hid information
	HID_INFORMATION_CD_H,					//UUID: 2803, 	VALUE:  			Prop: read
	HID_INFORMATION_DP_H,					//UUID: 2A4A 	VALUE: hidInformation

	//control point
	HID_CONTROL_POINT_CD_H,					//UUID: 2803, 	VALUE:  			Prop: write_without_rsp
	HID_CONTROL_POINT_DP_H,					//UUID: 2A4C 	VALUE: controlPoint

#endif
	//// battery service ////
	/**********************************************************************************************/
	BATT_PS_H, 								//UUID: 2800, 	VALUE: uuid 180f
	BATT_LEVEL_INPUT_CD_H,					//UUID: 2803, 	VALUE:  			Prop: Read | Notify
	BATT_LEVEL_INPUT_DP_H,					//UUID: 2A19 	VALUE: batVal
	BATT_LEVEL_INPUT_CCB_H,					//UUID: 2902, 	VALUE: batValCCC

	#if (BLE_OTA_SERVER_ENABLE)
	//// Ota ////
	/**********************************************************************************************/
	OTA_PS_H, 								//UUID: 2800, 	VALUE: telink ota service uuid
	OTA_CMD_OUT_CD_H,						//UUID: 2803, 	VALUE:  			Prop: read | write_without_rsp
	OTA_CMD_OUT_DP_H,						//UUID: telink ota uuid,  VALUE: otaData
	OTA_CMD_OUT_DESC_H,						//UUID: 2901, 	VALUE: otaName
	#endif

	//// Custom Counter Service ////
	/**********************************************************************************************/
	CUSTOM_COUNTER_PS_H,					//UUID: 2800, 	VALUE: custom counter service uuid
	CUSTOM_COUNTER_WRITE_CD_H,				//UUID: 2803, 	VALUE:  			Prop: read | write | write_without_rsp
	CUSTOM_COUNTER_WRITE_DP_H,				//UUID: custom uuid,  VALUE: counter value (write)
	CUSTOM_COUNTER_WRITE_DESC_H,			//UUID: 2901, 	VALUE: write char user description
	CUSTOM_COUNTER_READ_CD_H,				//UUID: 2803, 	VALUE:  			Prop: read | notify
	CUSTOM_COUNTER_READ_DP_H,				//UUID: custom uuid,  VALUE: counter value (read/notify)
	CUSTOM_COUNTER_READ_CCB_H,				//UUID: 2902, 	VALUE: counter CCC
	CUSTOM_COUNTER_READ_DESC_H,				//UUID: 2901, 	VALUE: read char user description

	// Log TX (0x03 UUID, 用于独立日志输出)
	CUSTOM_COUNTER_LOG_CD_H,				//UUID: 2803, 	VALUE:  			Prop: read | notify
	CUSTOM_COUNTER_LOG_DP_H,				//UUID: 03a0..., VALUE: log data
	CUSTOM_COUNTER_LOG_CCB_H,				//UUID: 2902, 	VALUE: log CCC
	CUSTOM_COUNTER_LOG_DESC_H,				//UUID: 2901, 	VALUE: log char user description



	ATT_END_H,

}ATT_HANDLE;




/**
 * @brief   GATT initialization.
 *          !!!Note: this function is used to register ATT table to BLE Stack.
 * @param   none.
 * @return  none.
 */
void my_gatt_init (void);



#endif /* APP_ATT_H_ */
