wdxm657/ble_egg_anfu/(commit log)

2026-05-28 蓝牙串口接口联调测试
    [止吠蛋主板_20260520.dwg]
2026-06-05 最新版本update
    [AUDIO.SchDoc, Bluetooth.SchDoc, PCB1 - 副本.PcbDoc, PCB1.PcbDoc, PCB2.PcbLib, PCB_Project5.PrjPCB, POWER.SchDoc, QFN88_FLASH_UART.SchDoc]
2026-06-10 hardware update
    [AUDIO.SchDoc, Bluetooth.SchDoc, PCB1 - 副本.PcbDoc, PCB1.PcbDoc, PCB2.PcbLib, POWER.SchDoc, QFN88_FLASH_UART.SchDoc, USB_CHARGE.SchDoc]
2026-06-29 soc + mcu base prj (mcu gpio en + soc comunicate mcu en)
    [POWER.SchDoc, egg.PcbDoc, egg.PrjPCB]
2026-06-29 音频播放测试成功
2026-06-29 MCU超声波测试完成
2026-06-30 电池电压以及IO输入检测测试完成
2026-07-01 自动手动两种策略查询
2026-07-01 安抚记录和安抚流程测试
2026-07-01 超声波测试完成
2026-07-02 安抚记录更新
2026-07-02 电量上传和LED
2026-07-03 电池状态更新
2026-07-07 BLE_LOG改为新增服务
2026-07-20 SOC串口通信bug修复
2026-08-04 手动策略增加零食投喂
    [egg.PcbDoc]
2026-11-04 安抚音频选择播放接口更新
2026-11-04 开机时reject一些接口
2026-11-05 安抚模式bug修复
2026-11-06 音频文件保存bug修复
